far-mat42/mte-481-g29/Nucleo PCB Schematic/MB1136.PcbDoc.htm

Reporting Options

# File in Newer Format

Date | : | 2025-03-16
Time | : | 6:20:26 PM
Filename | : | D:\GitHub\mte-481-g29\Nucleo PCB Schematic\MB1136.PcbDoc

Version | Warning
Release 12 | CAUTION - Air Gap Width previously controlled by Clearance rule is now controlled by Polygon Connect Style rule's newly introduced Air Gap Width (set to default value). Suggest reviewing each Polygon Connect Style rule's Air Gap Width attribute for correctness.
Release 13 | CAUTION - Silkscreen Over Component Pads Rules are converted to Silk To Solder Mask Clearance Rules. Suggest examining rule scopes for accuracy.

This file was generated by an earlier version of the software
