far-mat42/mte-481-g29/Custom PCBs/PCB BOM.xlsx

Quantity | Designator | Part Number
2 | BUF: C1, C2 | C0603C120J5GACTU
1 | BUF: C3 | CC0603KRX7R7BB104
2 | BUF: J1, J2 | 61300411121
1 | BUF: J3 | 61300611121
1 | BUF: J4 | 61300811121
3 | BUF: R3, R4, R5 | RNCP0603FTD10K0
1 | BUF: R6 | RC0603FR-071ML
1 | BUF: U1 | XR20M1172IG28-F
1 | BUF: Y1 | CX2016SA24000D0HLLG3
2 | ADC: C1, C2 | CC0603KRX7R7BB104
4 | ADC: C3A, C3B, C3C, C3D | KGM15AR71C683KT
1 | ADC: J1 | 61300811121
1 | ADC: J2 | 61300611121
2 | ADC: R1, R5 | RNCP0603FTD10K0
2 | ADC: R2, R3 | RC0603FR-071K8L
4 | ADC: R4A, R4B, R4C, R4D | RC0603FR-07100RL
1 | ADC: U1 | ADS1219IPWR
