far-mat42/mte-481-g29/3D Parts and Assemblies/Alternate Barcode Scanner Gimbal.SLDASM

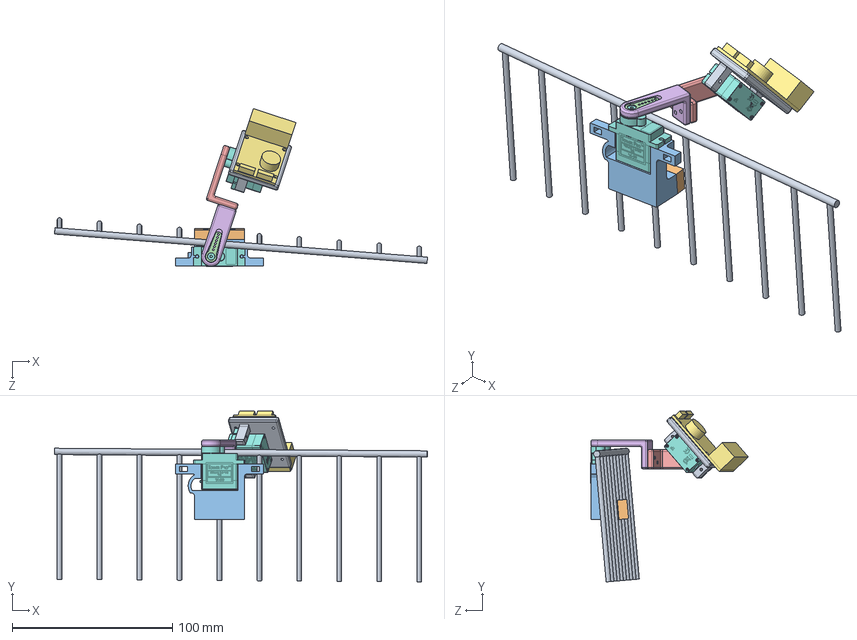
[picture p1: CAD file, 2025-03-16]
3D Parts and Assemblies/Alternate Barcode Scanner Gimbal.SLDASM
232.6 x 106.6 x 98.4 mm
Barcode Scanner Mount Alt
SG90 - Micro Servo 9g - Tower Pro.1 x 2
GM67 Barcode Scanner
Alt Gimbal Yaw Arm
Alt Gimbal Pitch Arm
SG90 Arm x 2
Alt Gimbal Yaw Servo Mount
Yaw Servo Mount Clamp
Gimbal Cart Mockup
