far-mat42/mte-481-g29/3D Parts and Assemblies/ESP32 Case.SLDASM

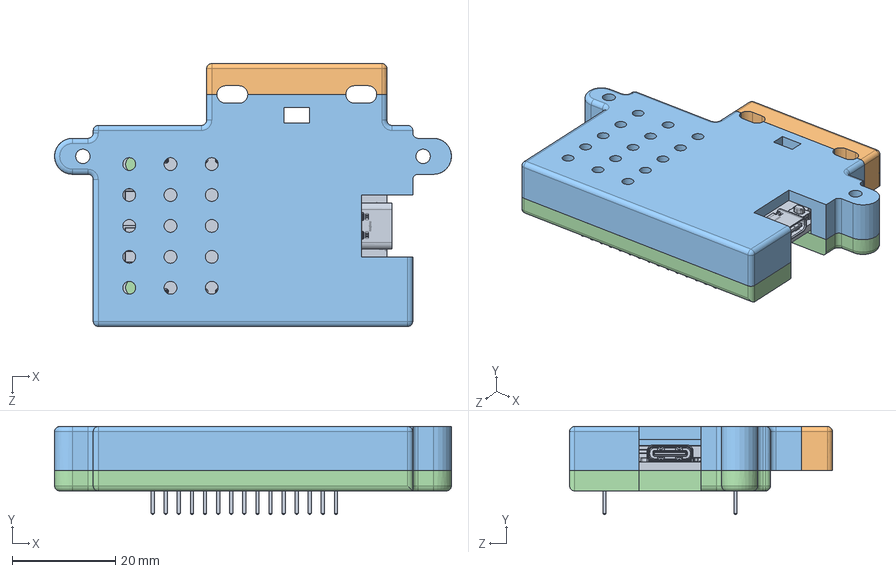
[picture p2: CAD file, 2025-03-10]
3D Parts and Assemblies/ESP32 Case.SLDASM
77.0 x 17.1 x 51.0 mm
ESP32 Case Bottom
ESP32 Case Top
ESP32 Case Mount Clamp
ESP32-WROOM-32
