far-mat42/mte-481-g29/3D Parts and Assemblies/Load Cell ADC Case.SLDASM

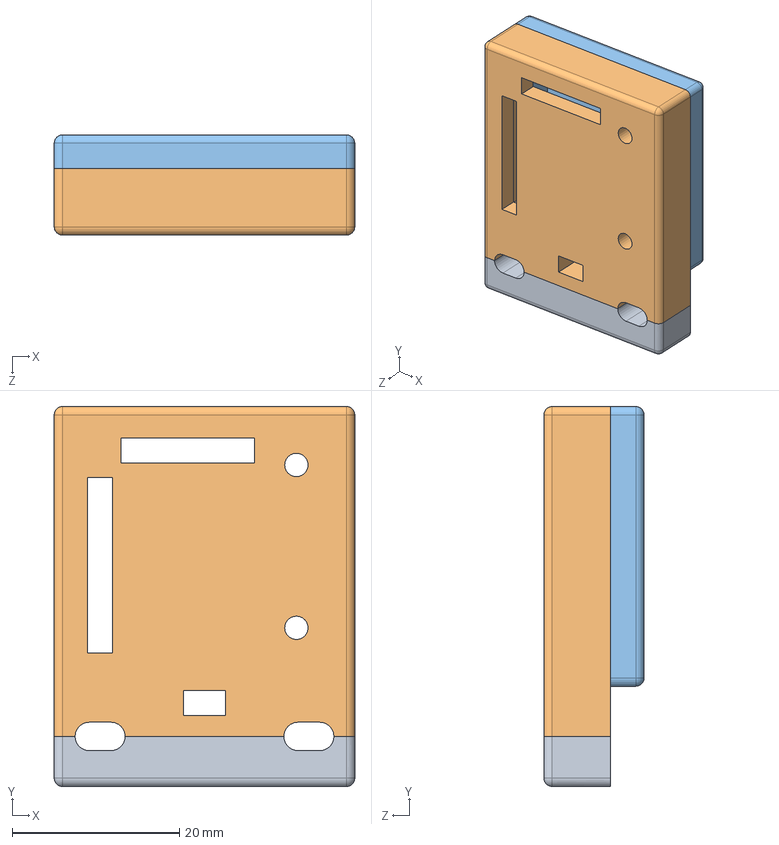
[picture p3: CAD file, 2025-03-02]
3D Parts and Assemblies/Load Cell ADC Case.SLDASM
36.0 x 45.5 x 12.0 mm
Load Cell ADC Case Bottom
Load Cell ADC Case Top
Load Cell ADC Case Mount Clamp
