far-mat42/mte-481-g29/3D Parts and Assemblies/Battery Case.SLDASM

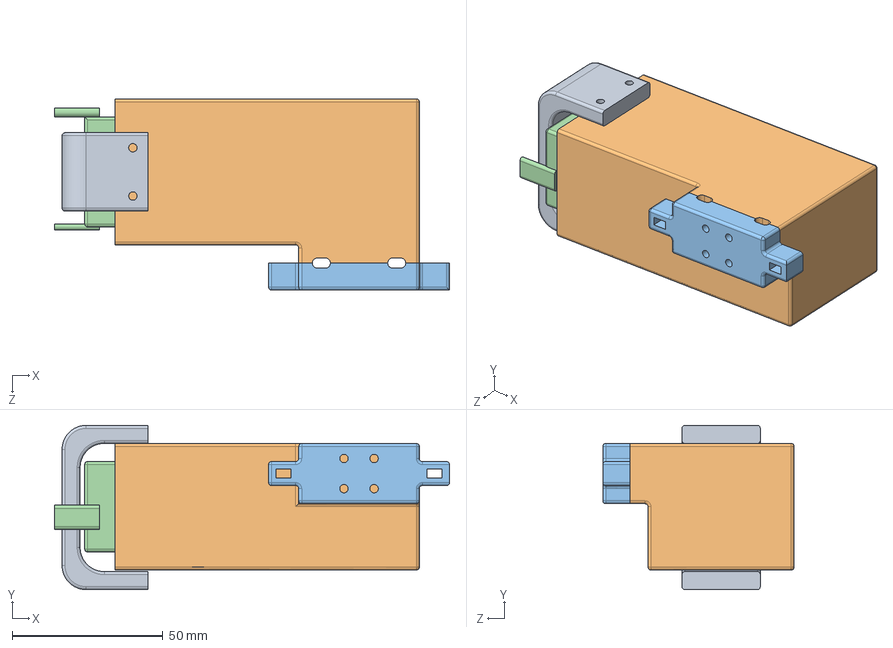
[picture p4: CAD file, 2025-03-02]
3D Parts and Assemblies/Battery Case.SLDASM
131.0 x 54.5 x 63.5 mm
Battery Model
Battery Case Mount
Battery Case
Battery Front Cover
