far-mat42/mte-481-g29/3D Parts and Assemblies/Buck Converter Case.SLDASM

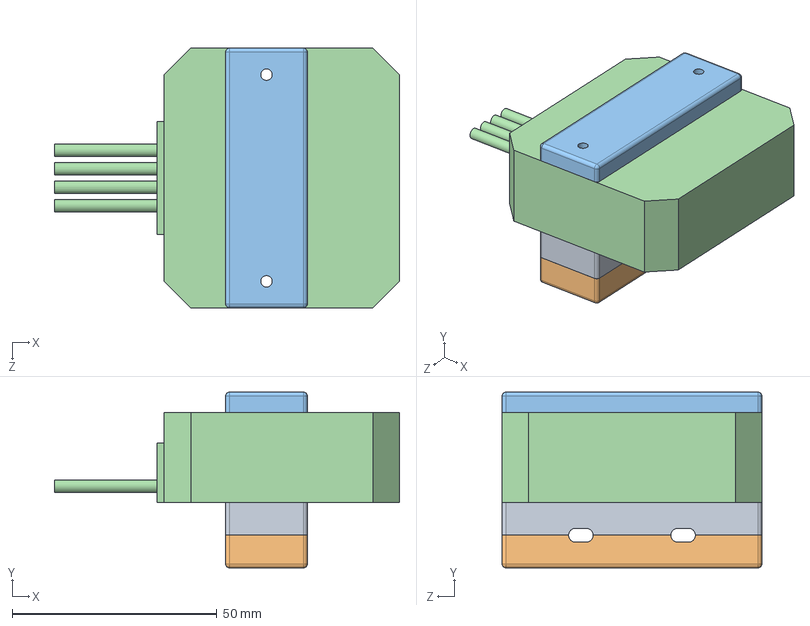
[picture p5: CAD file, 2025-02-27]
3D Parts and Assemblies/Buck Converter Case.SLDASM
84.3 x 43.0 x 63.5 mm
Buck Converter Model
Buck Converter Case Top
Buck Converter Case Mount Clamp
Buck Converter Case Bottom
