far-mat42/mte-481-g29/3D Parts and Assemblies/Barcode Scanner Gimbal.SLDASM

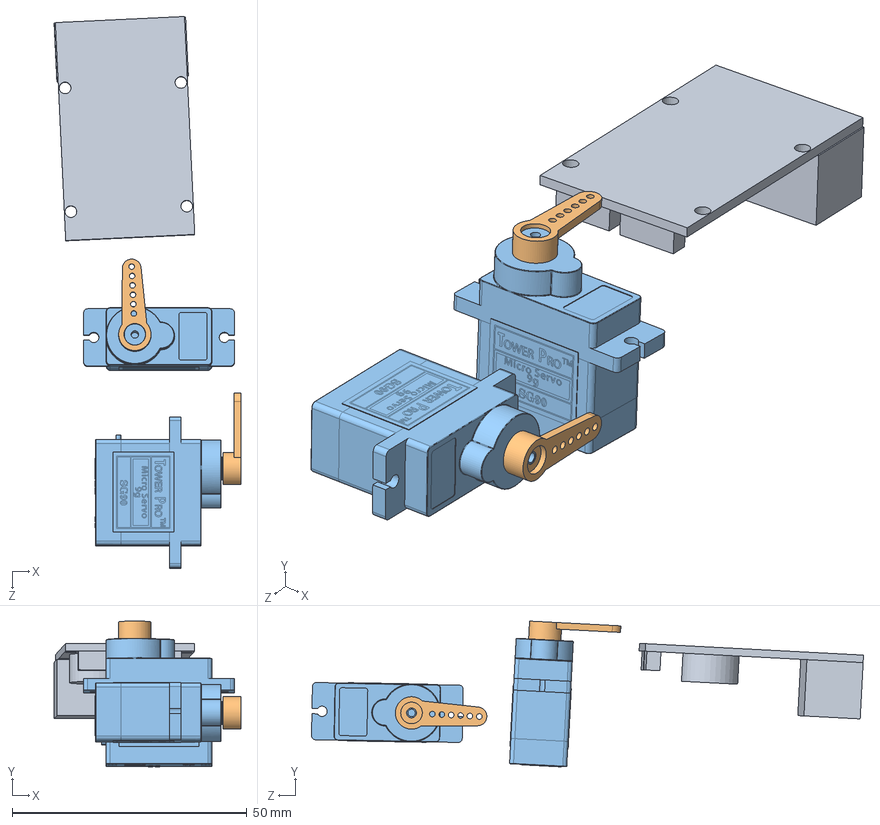
[picture p6: CAD file, 2025-01-12]
3D Parts and Assemblies/Barcode Scanner Gimbal.SLDASM
39.7 x 31.1 x 117.5 mm
SG90 - Micro Servo 9g - Tower Pro.1 x 2
SG90 Arm x 2
GM67 Barcode Scanner
