far-mat42/mte-481-g29/3D Parts and Assemblies/Models & Used Designs/Gimbal Cart Mockup.SLDPRT

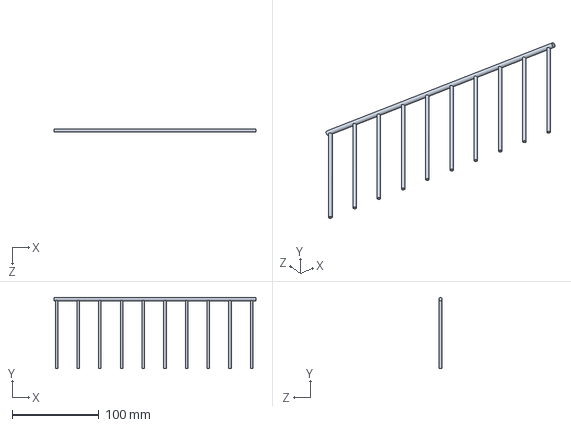
[picture p7: CAD file, 2025-03-16]
3D Parts and Assemblies/Models & Used Designs/Gimbal Cart Mockup.SLDPRT
233.0 x 82.0 x 4.00 mm
