far-mat42/mte-481-g29/3D Parts and Assemblies/Custom Parts/ESP32 Case Bottom.SLDPRT

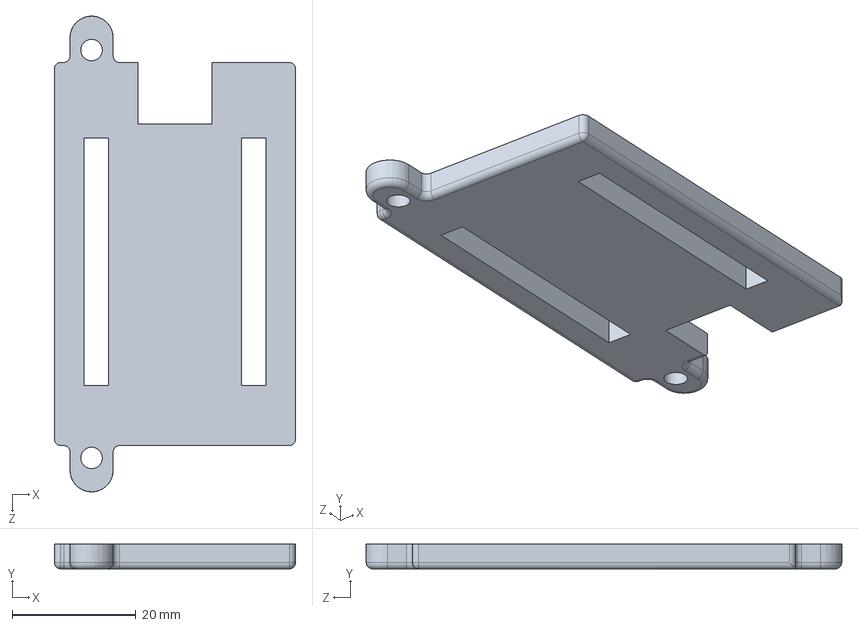
[picture p8: CAD file, 2025-03-10]
3D Parts and Assemblies/Custom Parts/ESP32 Case Bottom.SLDPRT
39.0 x 4.00 x 77.0 mm
