far-mat42/mte-481-g29/3D Parts and Assemblies/Models & Used Designs/ESP32-WROOM-32.SLDPRT

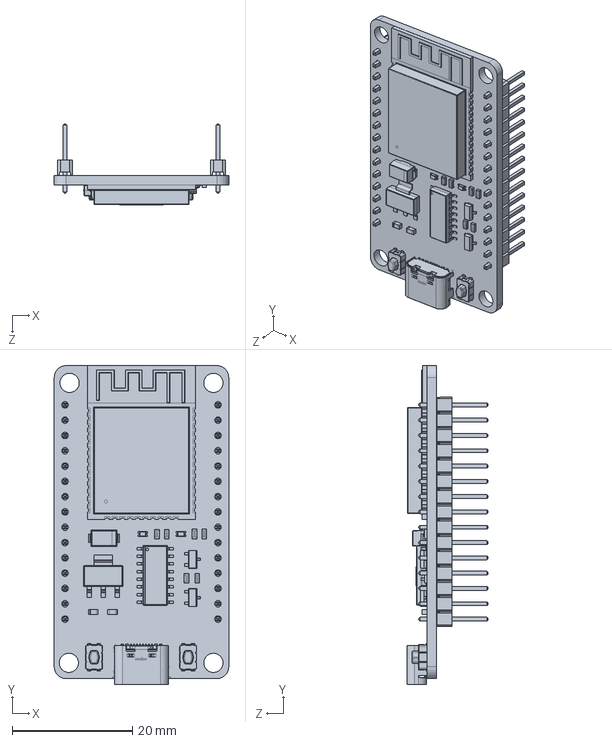
[picture p9: CAD file, 2025-03-03]
3D Parts and Assemblies/Models & Used Designs/ESP32-WROOM-32.SLDPRT
29.0 x 53.0 x 13.5 mm
