far-mat42/mte-481-g29/3D Parts and Assemblies/Custom Parts/ESP32 Case Top.SLDPRT

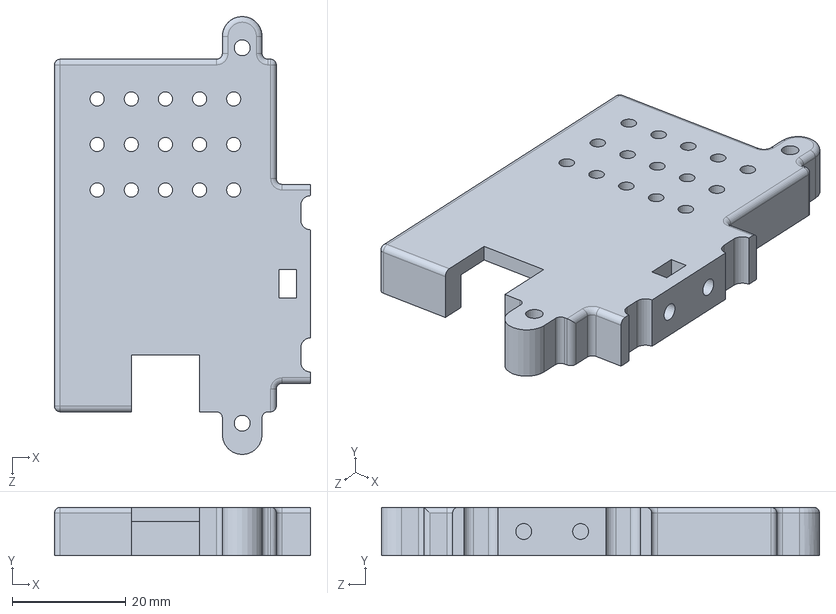
[picture p10: CAD file, 2025-03-10]
3D Parts and Assemblies/Custom Parts/ESP32 Case Top.SLDPRT
45.0 x 8.50 x 77.0 mm
