far-mat42/mte-481-g29/3D Parts and Assemblies/Models & Used Designs/Battery Model.SLDPRT

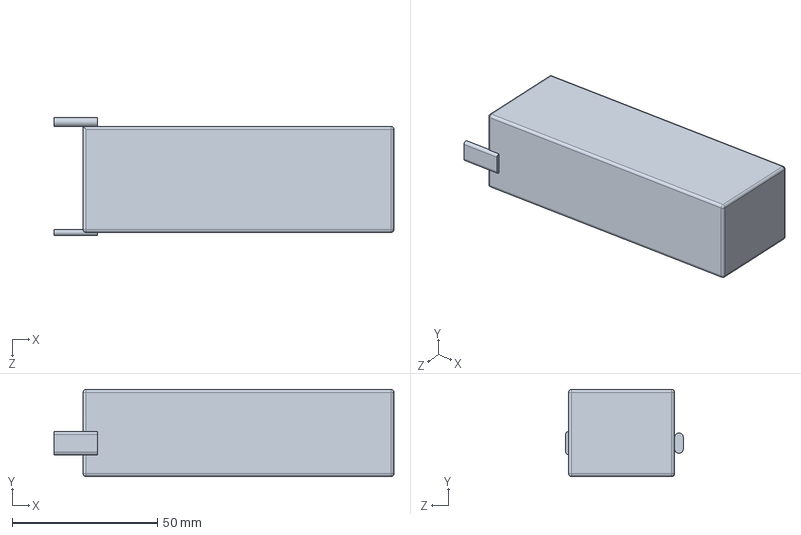
[picture p11: CAD file, 2025-02-27]
3D Parts and Assemblies/Models & Used Designs/Battery Model.SLDPRT
117.0 x 30.0 x 40.5 mm
