far-mat42/mte-481-g29/3D Parts and Assemblies/Custom Parts/Jetson Nano Case Bottom.SLDPRT

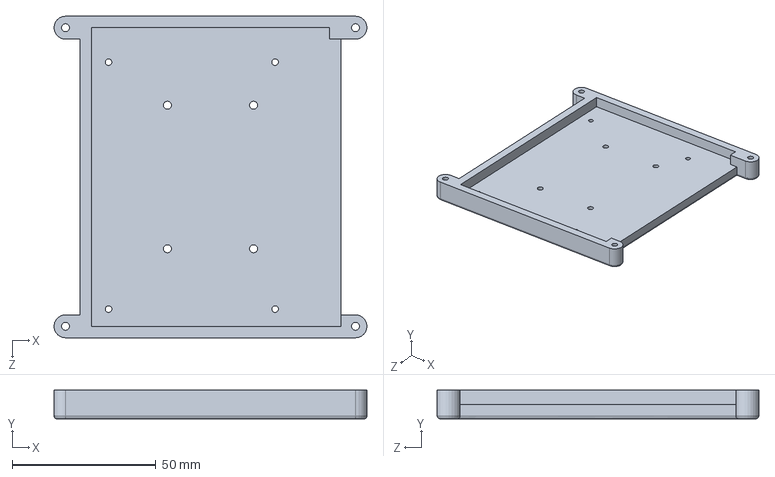
[picture p12: CAD file, 2025-03-06]
3D Parts and Assemblies/Custom Parts/Jetson Nano Case Bottom.SLDPRT
109.0 x 10.0 x 112.0 mm
