far-mat42/mte-481-g29/3D Parts and Assemblies/Models & Used Designs/Buck Converter Model.SLDPRT

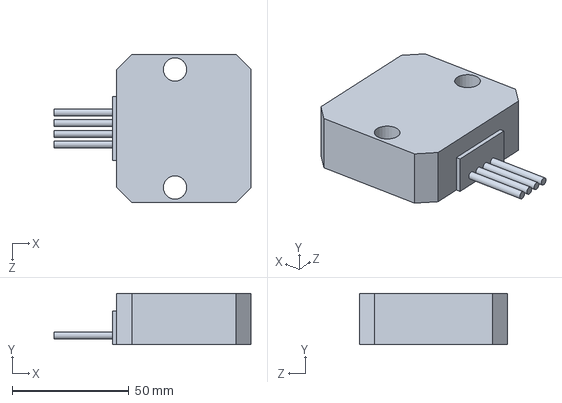
[picture p13: CAD file, 2025-02-27]
3D Parts and Assemblies/Models & Used Designs/Buck Converter Model.SLDPRT
84.3 x 22.0 x 63.5 mm
