far-mat42/mte-481-g29/3D Parts and Assemblies/Models & Used Designs/Basket Wall.SLDPRT

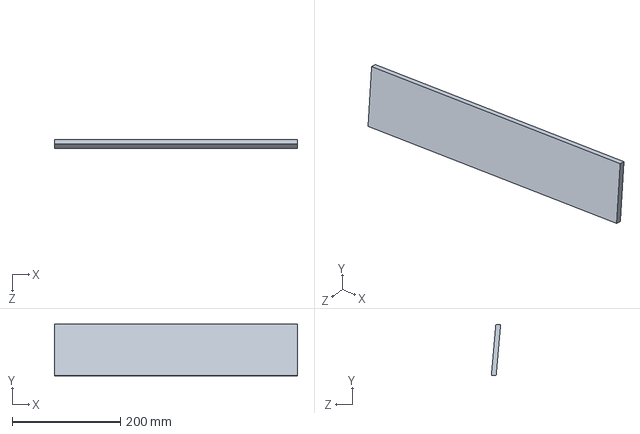
[picture p14: CAD file, 2025-02-02]
3D Parts and Assemblies/Models & Used Designs/Basket Wall.SLDPRT
450.0 x 95.4 x 17.2 mm
