far-mat42/mte-481-g29/3D Parts and Assemblies/Models & Used Designs/MotorSlot-Left.SLDPRT

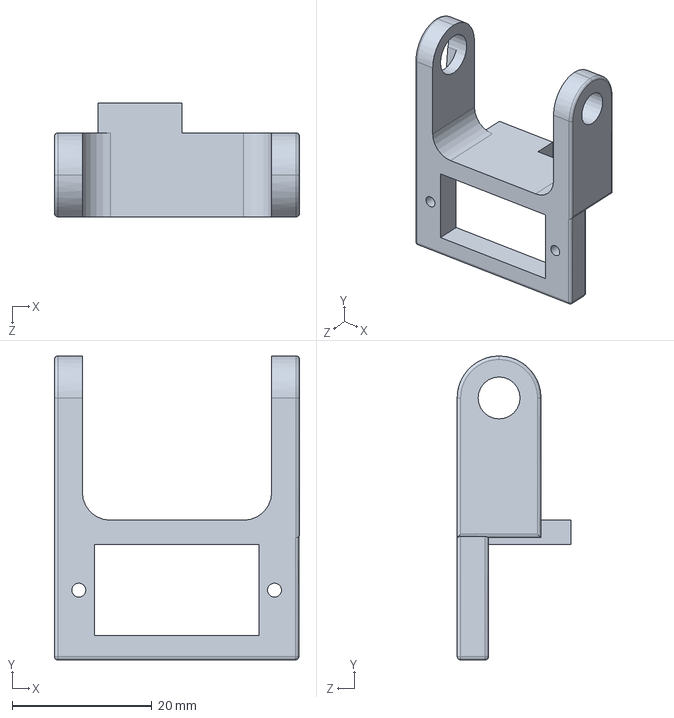
[picture p15: CAD file, 2025-01-12]
3D Parts and Assemblies/Models & Used Designs/MotorSlot-Left.SLDPRT
35.1 x 43.5 x 16.3 mm
