far-mat42/mte-481-g29/3D Parts and Assemblies/Custom Parts/Nucleo Case Top.SLDPRT

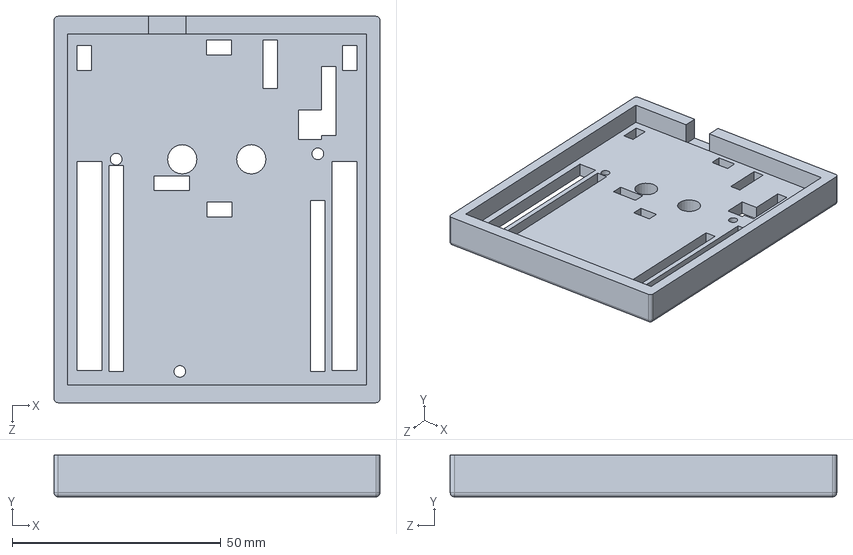
[picture p16: CAD file, 2025-03-03]
3D Parts and Assemblies/Custom Parts/Nucleo Case Top.SLDPRT
78.0 x 10.0 x 92.5 mm
