far-mat42/mte-481-g29/3D Parts and Assemblies/Models & Used Designs/SG90 Arm.SLDPRT

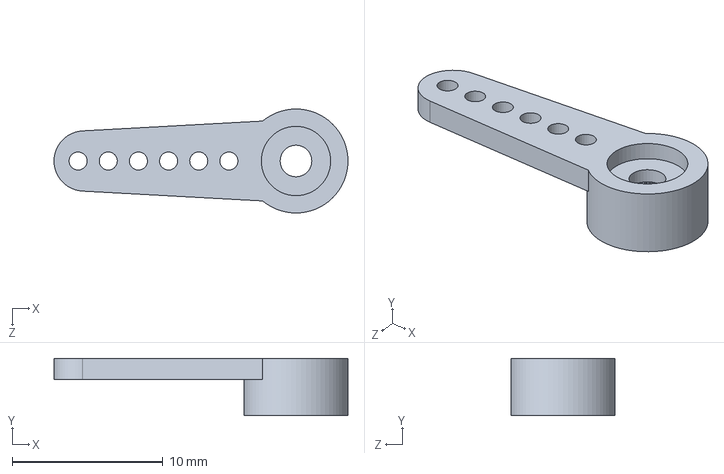
[picture p17: CAD file, 2025-01-12]
3D Parts and Assemblies/Models & Used Designs/SG90 Arm.SLDPRT
19.5 x 3.80 x 6.90 mm
