far-mat42/mte-481-g29/3D Parts and Assemblies/Custom Parts/Nucleo Case Outer Clamp.SLDPRT

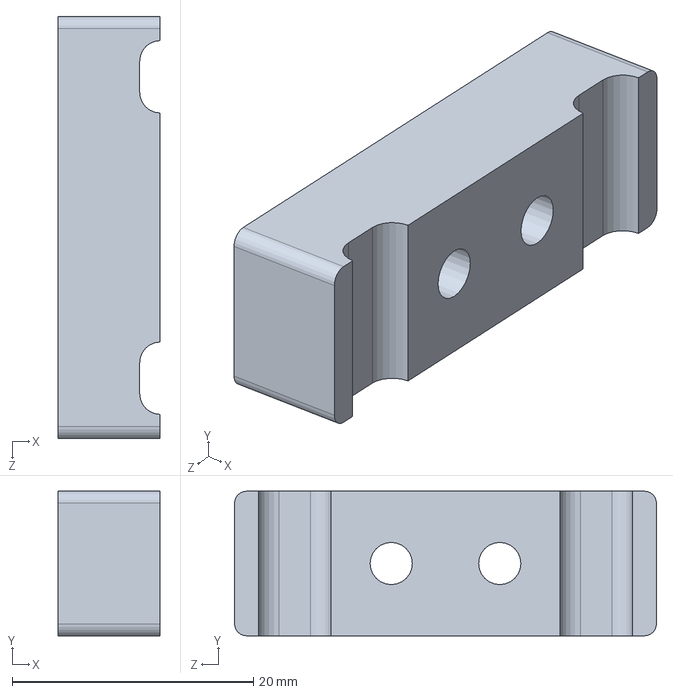
[picture p18: CAD file, 2025-03-03]
3D Parts and Assemblies/Custom Parts/Nucleo Case Outer Clamp.SLDPRT
8.50 x 12.0 x 35.0 mm
