far-mat42/mte-481-g29/3D Parts and Assemblies/Models & Used Designs/MotorHolder.SLDPRT

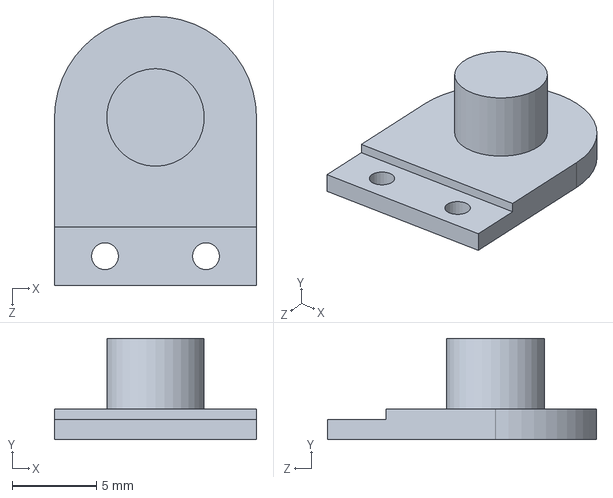
[picture p19: CAD file, 2025-01-12]
3D Parts and Assemblies/Models & Used Designs/MotorHolder.SLDPRT
12.0 x 6.00 x 16.0 mm
