far-mat42/mte-481-g29/3D Parts and Assemblies/Custom Parts/Nucleo Case Inner Clamp.SLDPRT

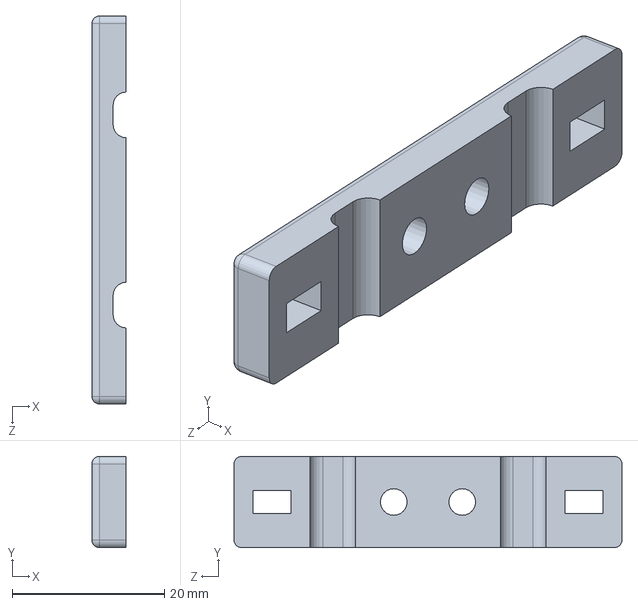
[picture p20: CAD file, 2025-03-03]
3D Parts and Assemblies/Custom Parts/Nucleo Case Inner Clamp.SLDPRT
4.50 x 12.0 x 51.0 mm
