far-mat42/mte-481-g29/3D Parts and Assemblies/Custom Parts/Jetson Nano Case Top.SLDPRT

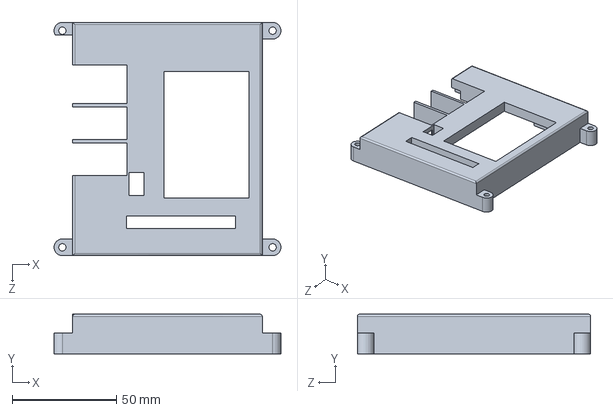
[picture p21: CAD file, 2025-03-03]
3D Parts and Assemblies/Custom Parts/Jetson Nano Case Top.SLDPRT
109.0 x 19.0 x 112.0 mm
