far-mat42/mte-481-g29/3D Parts and Assemblies/Models & Used Designs/SG90 - Micro Servo 9g - Tower Pro.1.SLDPRT

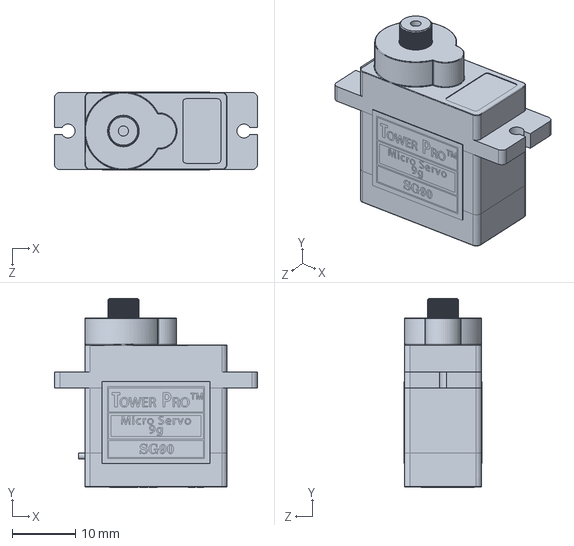
[picture p22: CAD file, 2025-01-12]
3D Parts and Assemblies/Models & Used Designs/SG90 - Micro Servo 9g - Tower Pro.1.SLDPRT
32.1 x 30.0 x 12.4 mm
