far-mat42/mte-481-g29/3D Parts and Assemblies/Custom Parts/ESP32 Case Mount Clamp.SLDPRT

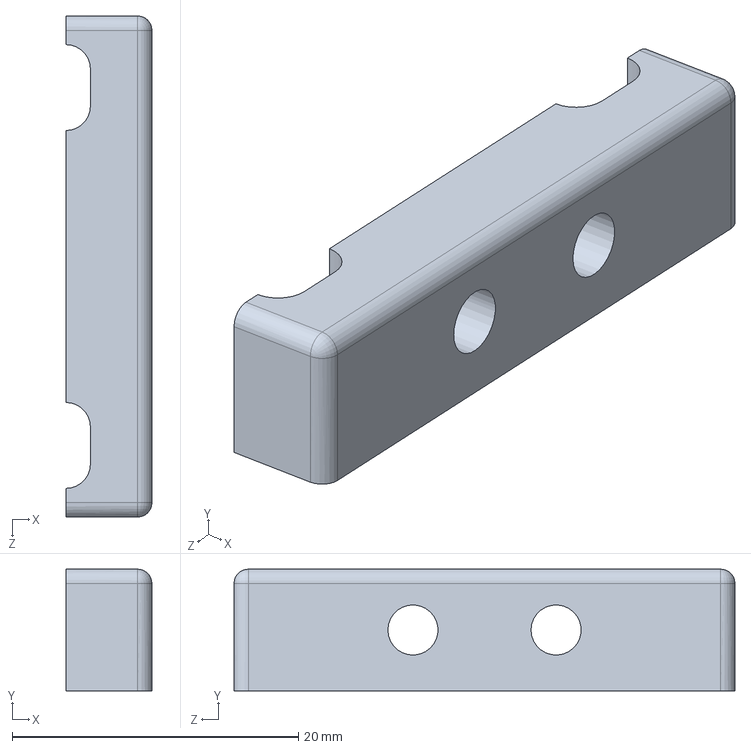
[picture p23: CAD file, 2025-03-03]
3D Parts and Assemblies/Custom Parts/ESP32 Case Mount Clamp.SLDPRT
6.00 x 8.50 x 35.0 mm
