far-mat42/mte-481-g29/3D Parts and Assemblies/Custom Parts/Jetson Case Inner Clamp.SLDPRT

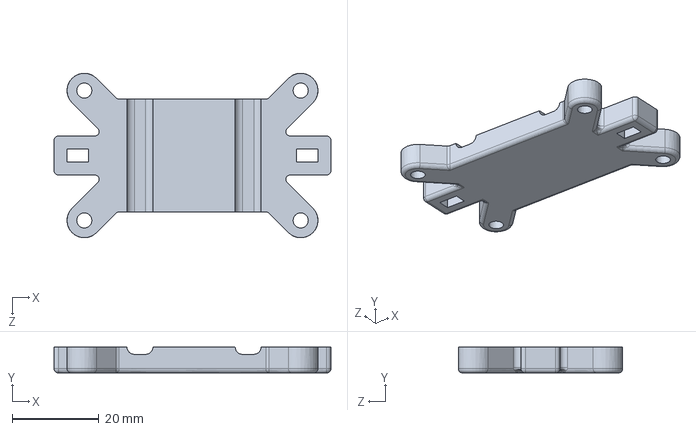
[picture p24: CAD file, 2025-03-02]
3D Parts and Assemblies/Custom Parts/Jetson Case Inner Clamp.SLDPRT
64.0 x 6.00 x 38.0 mm
