far-mat42/mte-481-g29/3D Parts and Assemblies/Custom Parts/Jetson Case Outer Clamp.SLDPRT

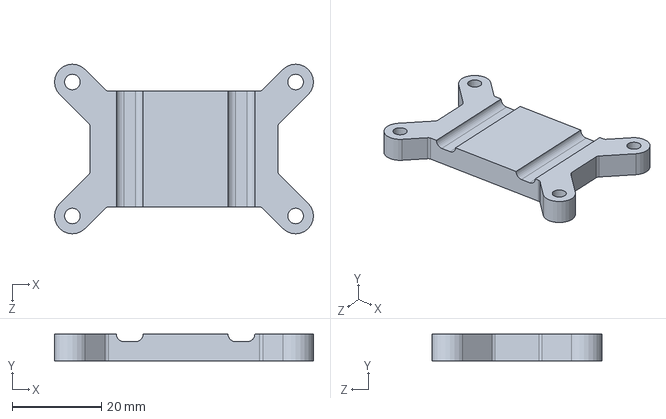
[picture p25: CAD file, 2025-03-02]
3D Parts and Assemblies/Custom Parts/Jetson Case Outer Clamp.SLDPRT
58.0 x 6.00 x 38.0 mm
