far-mat42/mte-481-g29/3D Parts and Assemblies/Custom Parts/Battery Front Cover.SLDPRT

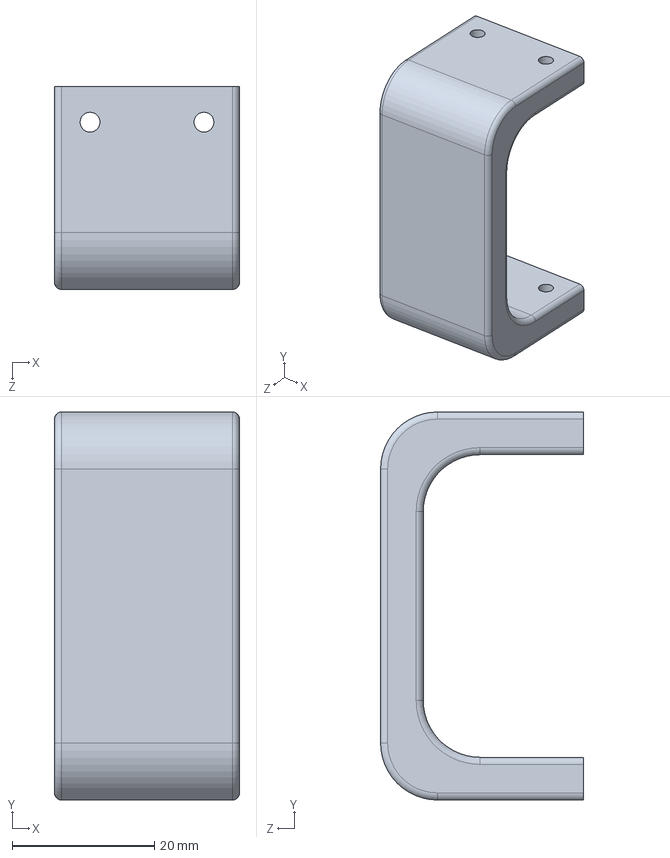
[picture p26: CAD file, 2025-02-27]
3D Parts and Assemblies/Custom Parts/Battery Front Cover.SLDPRT
26.0 x 54.5 x 28.5 mm
