far-mat42/mte-481-g29/3D Parts and Assemblies/Custom Parts/Battery Case.SLDPRT

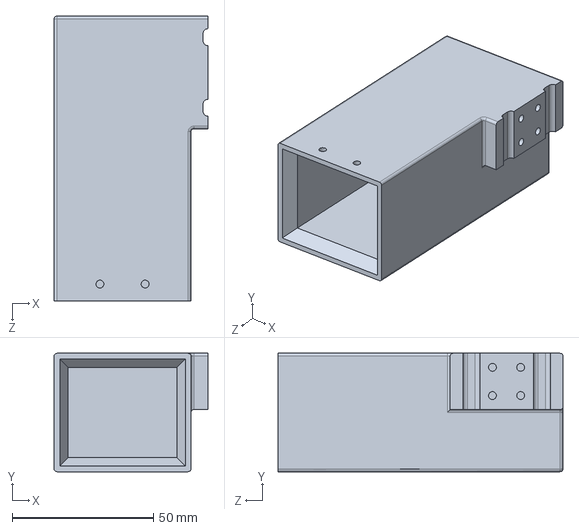
[picture p27: CAD file, 2025-02-27]
3D Parts and Assemblies/Custom Parts/Battery Case.SLDPRT
54.5 x 42.0 x 101.0 mm
