far-mat42/mte-481-g29/3D Parts and Assemblies/Custom Parts/Battery Case Mount.SLDPRT

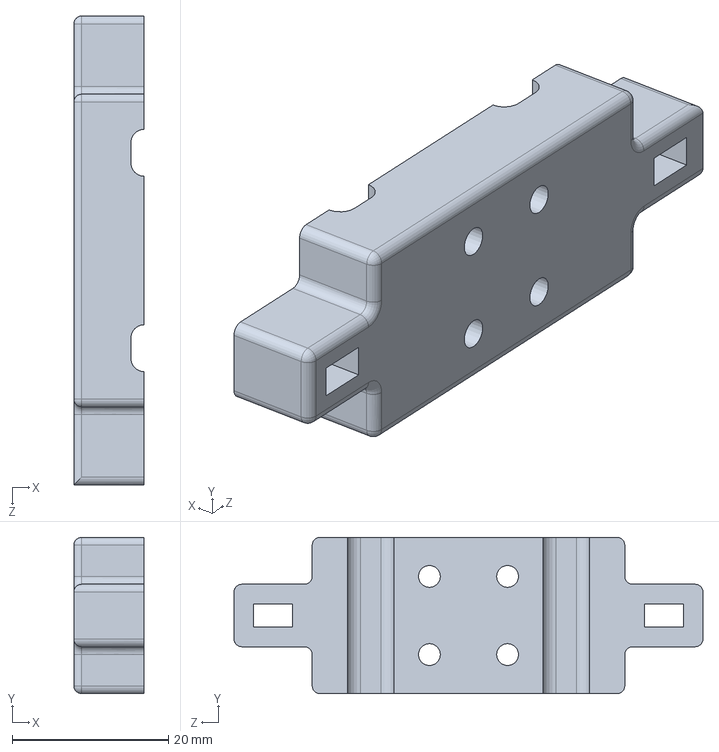
[picture p28: CAD file, 2025-02-27]
3D Parts and Assemblies/Custom Parts/Battery Case Mount.SLDPRT
9.00 x 20.0 x 60.0 mm
