far-mat42/mte-481-g29/3D Parts and Assemblies/Custom Parts/Buck Converter Case Top.SLDPRT

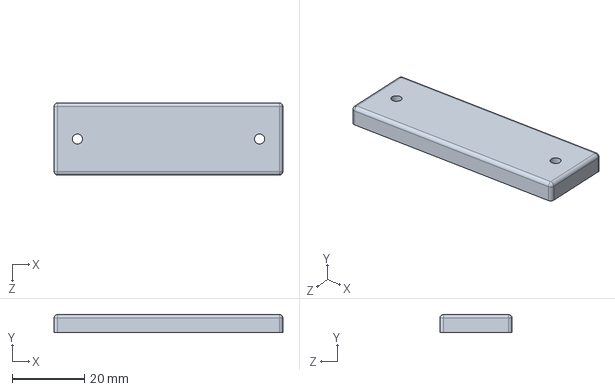
[picture p29: CAD file, 2025-02-27]
3D Parts and Assemblies/Custom Parts/Buck Converter Case Top.SLDPRT
63.5 x 5.00 x 20.0 mm
