far-mat42/mte-481-g29/3D Parts and Assemblies/Custom Parts/Buck Converter Case Bottom.SLDPRT

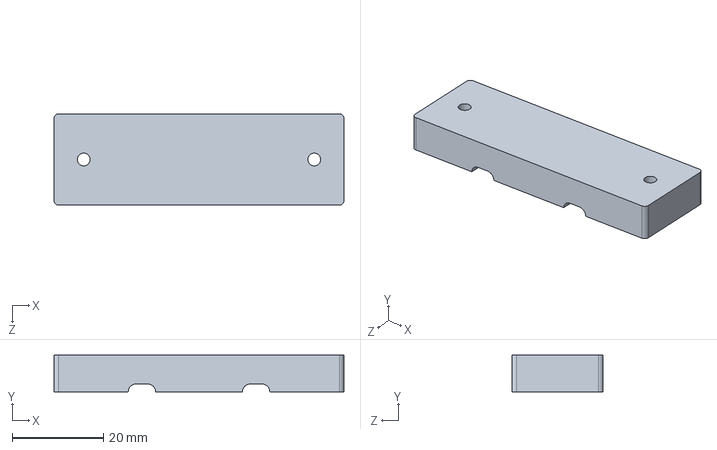
[picture p30: CAD file, 2025-02-27]
3D Parts and Assemblies/Custom Parts/Buck Converter Case Bottom.SLDPRT
63.5 x 8.00 x 20.0 mm
