far-mat42/mte-481-g29/3D Parts and Assemblies/Custom Parts/Nucleo Case Bottom.SLDPRT

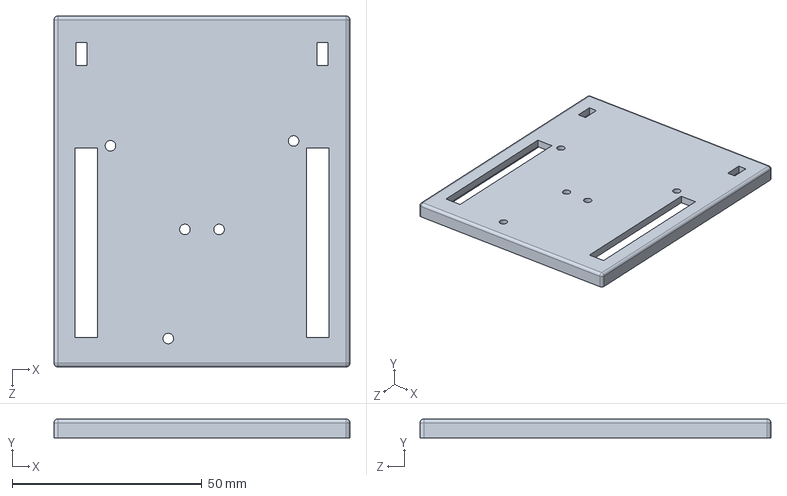
[picture p32: CAD file, 2025-02-25]
3D Parts and Assemblies/Custom Parts/Nucleo Case Bottom.SLDPRT
78.0 x 5.00 x 92.5 mm
