far-mat42/mte-481-g29/3D Parts and Assemblies/Custom Parts/LDO Case Top.SLDPRT

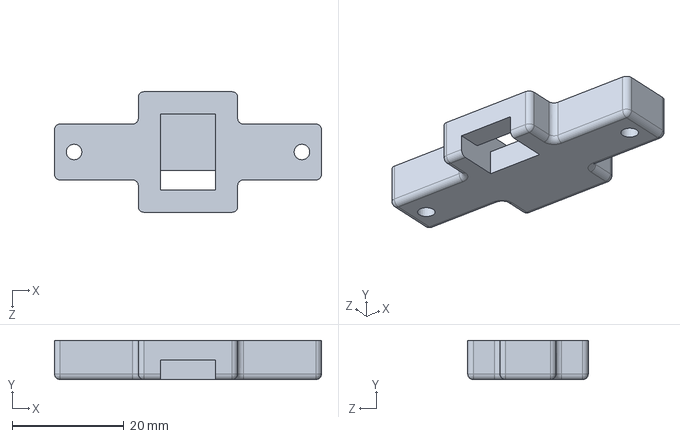
[picture p33: CAD file, 2025-02-25]
3D Parts and Assemblies/Custom Parts/LDO Case Top.SLDPRT
47.8 x 7.00 x 21.6 mm
