far-mat42/mte-481-g29/3D Parts and Assemblies/Custom Parts/Alt Gimbal Yaw Servo Mount.SLDPRT

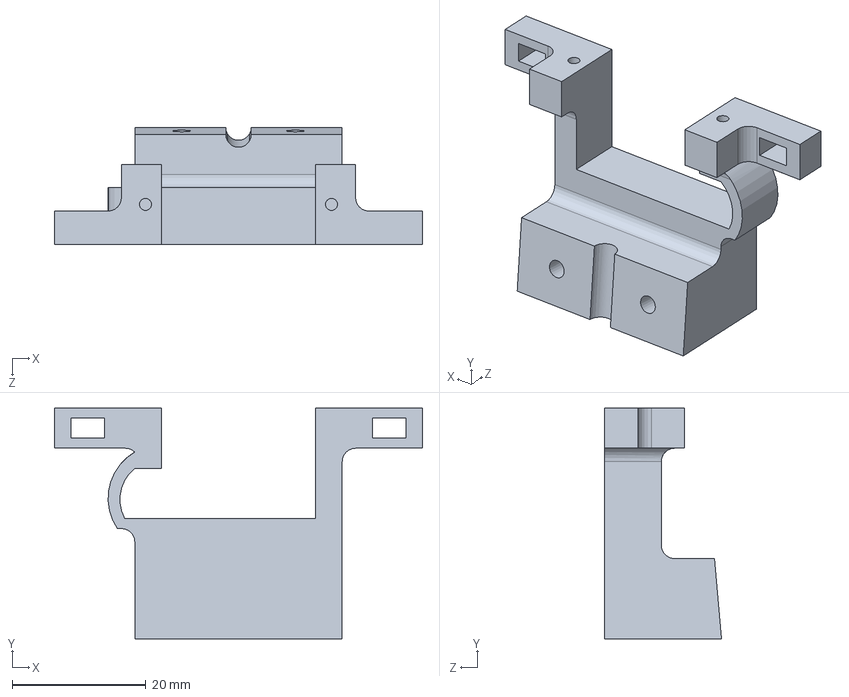
[picture p34: CAD file, 2025-02-25]
3D Parts and Assemblies/Custom Parts/Alt Gimbal Yaw Servo Mount.SLDPRT
55.0 x 34.5 x 17.5 mm
