far-mat42/mte-481-g29/3D Parts and Assemblies/Custom Parts/LDO Case Mount Clamp.SLDPRT

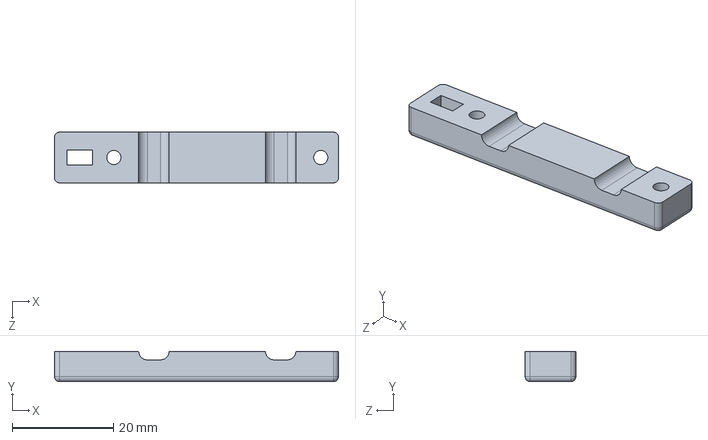
[picture p35: CAD file, 2025-02-25]
3D Parts and Assemblies/Custom Parts/LDO Case Mount Clamp.SLDPRT
56.0 x 6.00 x 10.0 mm
