far-mat42/mte-481-g29/3D Parts and Assemblies/Custom Parts/Yaw Servo Mount Clamp.SLDPRT

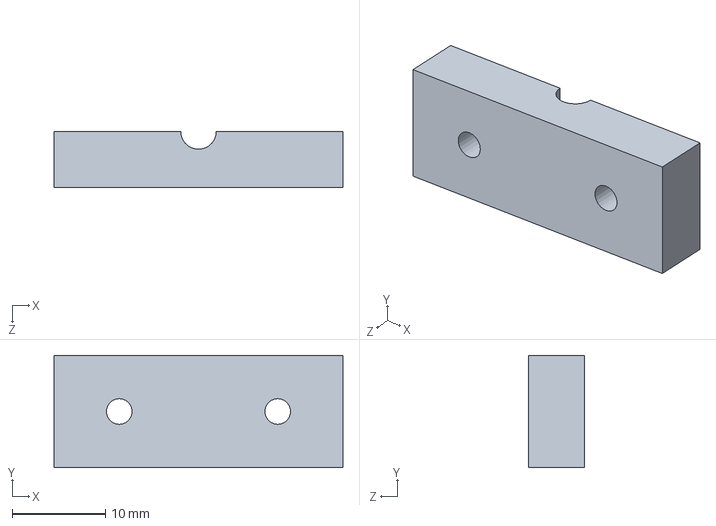
[picture p36: CAD file, 2025-02-25]
3D Parts and Assemblies/Custom Parts/Yaw Servo Mount Clamp.SLDPRT
31.0 x 12.1 x 6.00 mm
