far-mat42/mte-481-g29/3D Parts and Assemblies/Custom Parts/Load Cell ADC Case Bottom.SLDPRT

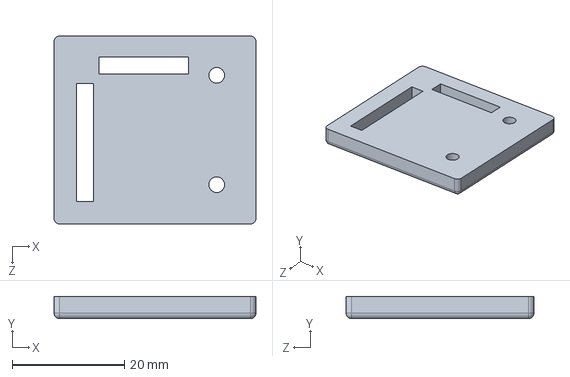
[picture p37: CAD file, 2025-02-23]
3D Parts and Assemblies/Custom Parts/Load Cell ADC Case Bottom.SLDPRT
36.0 x 4.00 x 33.5 mm
