far-mat42/mte-481-g29/3D Parts and Assemblies/Custom Parts/Load Cell ADC Case Top.SLDPRT

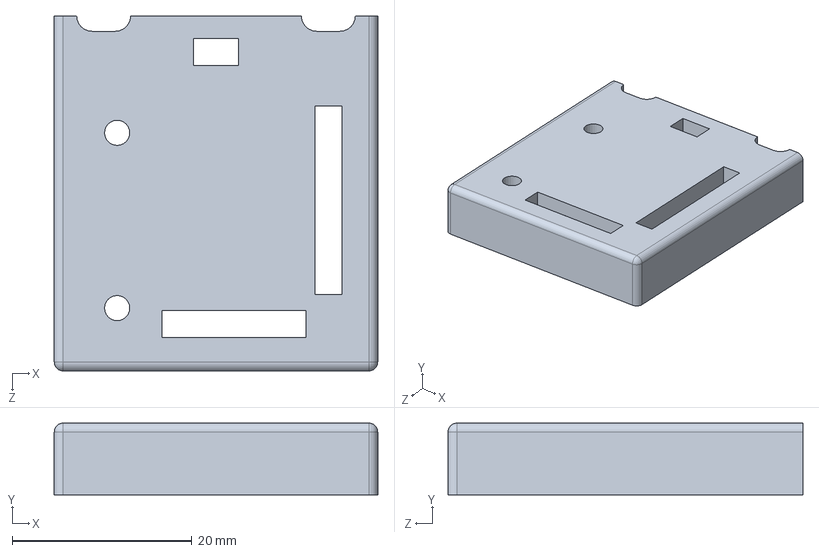
[picture p38: CAD file, 2025-02-23]
3D Parts and Assemblies/Custom Parts/Load Cell ADC Case Top.SLDPRT
36.0 x 8.00 x 39.5 mm
