far-mat42/mte-481-g29/3D Parts and Assemblies/Custom Parts/Load Cell ADC Case Mount Clamp.SLDPRT

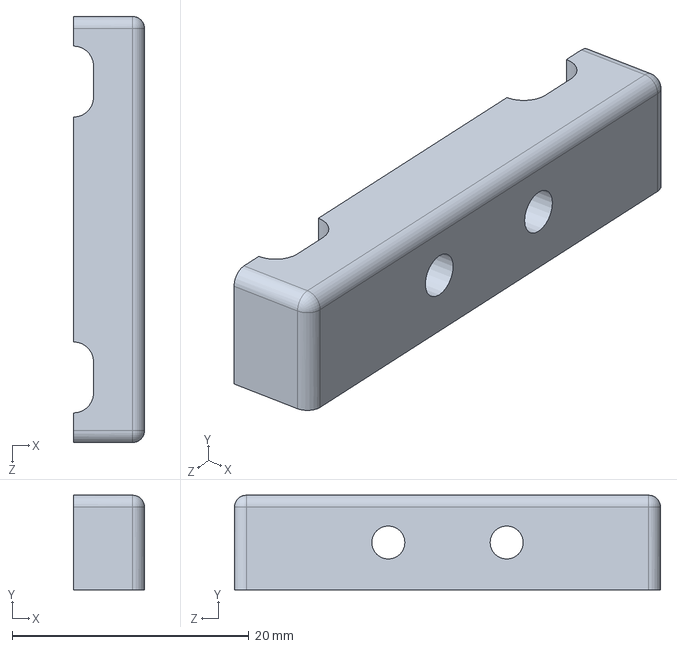
[picture p39: CAD file, 2025-02-23]
3D Parts and Assemblies/Custom Parts/Load Cell ADC Case Mount Clamp.SLDPRT
6.00 x 8.00 x 36.0 mm
