far-mat42/mte-481-g29/3D Parts and Assemblies/Custom Parts/Barcode Scanner Mount Alt.SLDPRT

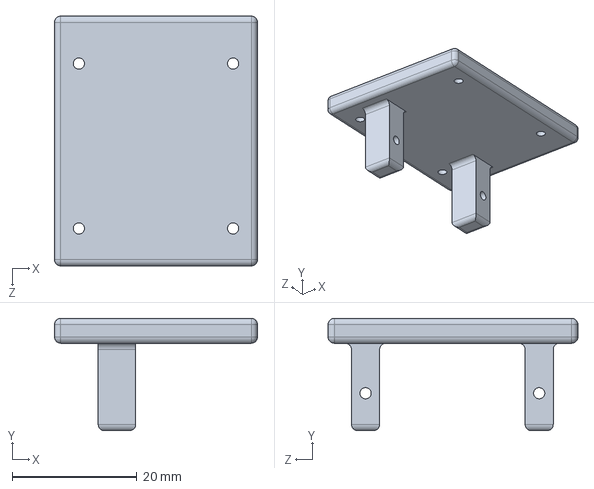
[picture p40: CAD file, 2025-02-02]
3D Parts and Assemblies/Custom Parts/Barcode Scanner Mount Alt.SLDPRT
32.5 x 18.0 x 40.0 mm
