far-mat42/mte-481-g29/3D Parts and Assemblies/Custom Parts/Alt Gimbal Yaw Arm.SLDPRT

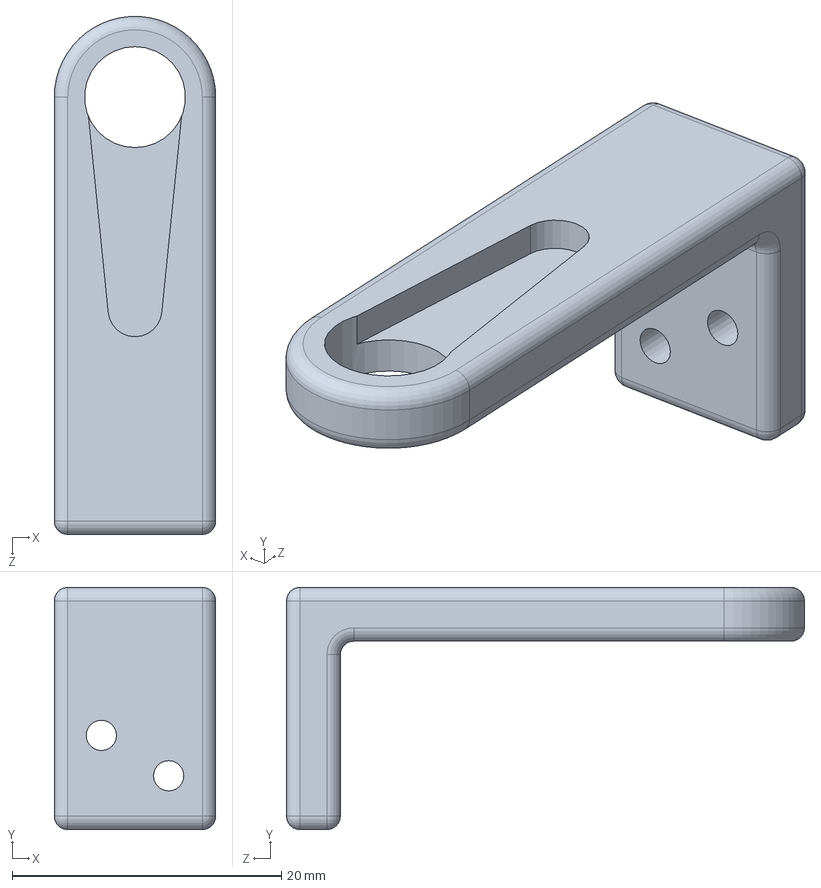
[picture p41: CAD file, 2025-02-02]
3D Parts and Assemblies/Custom Parts/Alt Gimbal Yaw Arm.SLDPRT
12.0 x 18.0 x 38.5 mm
