far-mat42/mte-481-g29/3D Parts and Assemblies/Custom Parts/Alt Gimbal Intermediate.SLDPRT

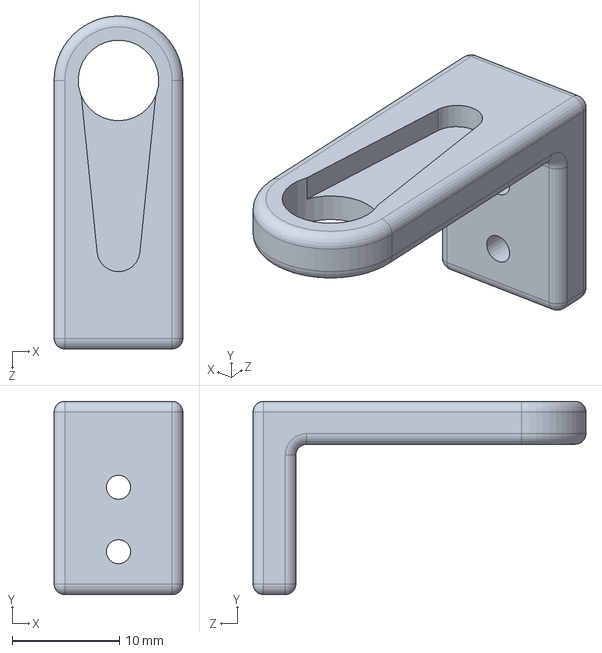
[picture p42: CAD file, 2025-02-02]
3D Parts and Assemblies/Custom Parts/Alt Gimbal Intermediate.SLDPRT
12.0 x 18.0 x 31.0 mm
