far-mat42/mte-481-g29/3D Parts and Assemblies/Custom Parts/Alt Gimbal Pitch Arm.SLDPRT

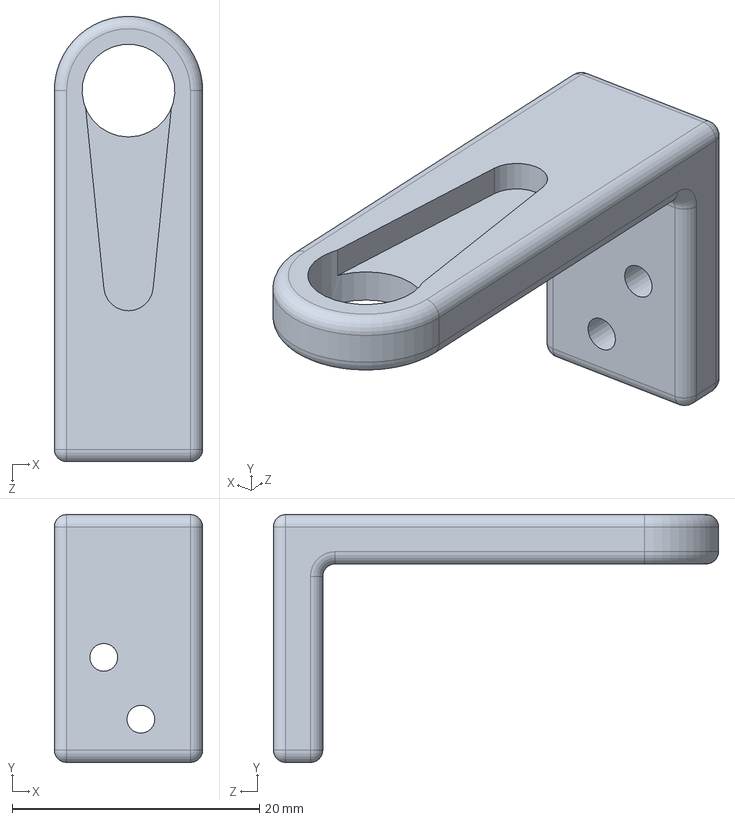
[picture p43: CAD file, 2025-02-02]
3D Parts and Assemblies/Custom Parts/Alt Gimbal Pitch Arm.SLDPRT
12.0 x 20.0 x 36.0 mm
