far-mat42/mte-481-g29/3D Parts and Assemblies/Custom Parts/GM67 Barcode Scanner.SLDPRT

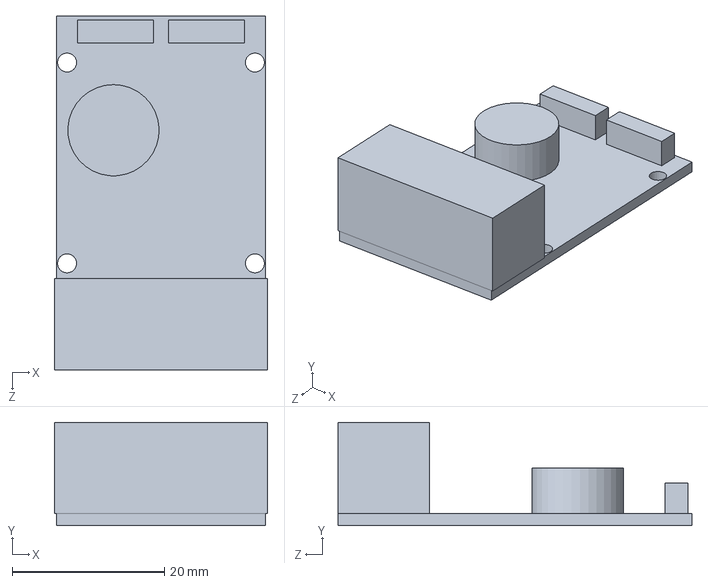
[picture p44: CAD file, 2025-01-12]
3D Parts and Assemblies/Custom Parts/GM67 Barcode Scanner.SLDPRT
28.0 x 13.6 x 46.5 mm
