far-mat42/mte-481-g29/3D Parts and Assemblies/Custom Parts/Barcode Scanner Mount.SLDPRT

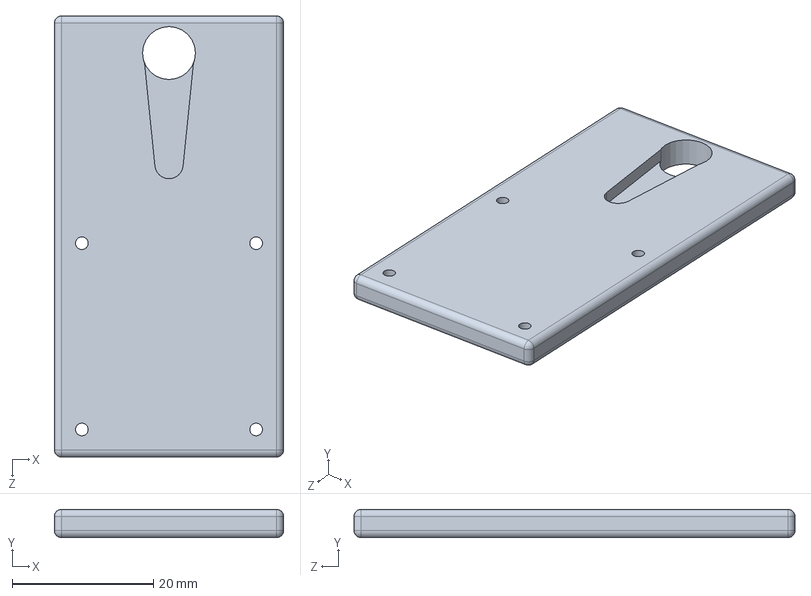
[picture p45: CAD file, 2025-01-12]
3D Parts and Assemblies/Custom Parts/Barcode Scanner Mount.SLDPRT
32.5 x 4.00 x 62.5 mm
