far-mat42/mte-481-g29/(list of files, cad)

Other CAD files:
3D Parts and Assemblies/Models & Used Designs/Gimbal-Intermediate.SLDPRT
3D Parts and Assemblies/Custom Parts/LDO Case Bottom.SLDPRT
3D Parts and Assemblies/Custom Parts/Motor Slot Intermediate.SLDPRT
3D Parts and Assemblies/Custom Parts/Alt Gimbal Pitch Arm.STL
3D Parts and Assemblies/Custom Parts/Alt Gimbal Yaw Arm.STL
3D Parts and Assemblies/Custom Parts/Alt Gimbal Yaw Servo Mount.STL
3D Parts and Assemblies/Custom Parts/Barcode Scanner Mount Alt.STL
3D Parts and Assemblies/Custom Parts/Barcode Scanner Mount.STL
3D Parts and Assemblies/Custom Parts/Battery Case Mount.STL
3D Parts and Assemblies/Custom Parts/Battery Case.STL
3D Parts and Assemblies/Custom Parts/Battery Front Cover.STL
3D Parts and Assemblies/Custom Parts/Buck Converter Case Bottom.STL
3D Parts and Assemblies/Custom Parts/Buck Converter Case Mount Clamp.STL
3D Parts and Assemblies/Custom Parts/Buck Converter Case Top.STL
3D Parts and Assemblies/Custom Parts/Camera Screw Mount Inside Alt.SLDPRT
3D Parts and Assemblies/Custom Parts/Camera Screw Mount Inside Alt.STL
3D Parts and Assemblies/Custom Parts/Camera Screw Mount Inside.SLDPRT
3D Parts and Assemblies/Custom Parts/Camera Screw Mount Inside.STL
3D Parts and Assemblies/Custom Parts/Camera Screw Mount Outside Alt.SLDPRT
3D Parts and Assemblies/Custom Parts/Camera Screw Mount Outside Alt.STL
3D Parts and Assemblies/Custom Parts/Camera Screw Mount Outside.SLDPRT
3D Parts and Assemblies/Custom Parts/Camera Screw Mount Outside.STL
3D Parts and Assemblies/Custom Parts/Camera Screw Mount.SLDPRT
3D Parts and Assemblies/Custom Parts/Drawings/3V3 LDO Case.SLDDRW
3D Parts and Assemblies/Custom Parts/Drawings/Battery Mount.SLDDRW
3D Parts and Assemblies/Custom Parts/Drawings/ESP32 Case.SLDDRW
3D Parts and Assemblies/Custom Parts/Drawings/Gimbal Arms.SLDDRW
3D Parts and Assemblies/Custom Parts/Drawings/Gimbal Mount.SLDDRW
3D Parts and Assemblies/Custom Parts/Drawings/Jetson Case.SLDDRW
3D Parts and Assemblies/Custom Parts/Drawings/Load Cell ADC Case.SLDDRW
3D Parts and Assemblies/Custom Parts/Drawings/Nucleo Case.SLDDRW
3D Parts and Assemblies/Custom Parts/Drawings/Template.SLDDRW
3D Parts and Assemblies/Custom Parts/ESP32 Case Bottom.STL
3D Parts and Assemblies/Custom Parts/ESP32 Case Mount Clamp.STL
3D Parts and Assemblies/Custom Parts/ESP32 Case Top.STL
3D Parts and Assemblies/Custom Parts/Jetson Case Inner Clamp.STL
3D Parts and Assemblies/Custom Parts/Jetson Case Outer Clamp.STL
3D Parts and Assemblies/Custom Parts/Jetson Nano Case Bottom.STL
3D Parts and Assemblies/Custom Parts/Jetson Nano Case Top.STL
3D Parts and Assemblies/Custom Parts/LDO Case Bottom.STL
3D Parts and Assemblies/Custom Parts/LDO Case Mount Clamp.STL
3D Parts and Assemblies/Custom Parts/LDO Case Top.STL
3D Parts and Assemblies/Custom Parts/Load Cell ADC Case Bottom.STL
3D Parts and Assemblies/Custom Parts/Load Cell ADC Case Mount Clamp.STL
3D Parts and Assemblies/Custom Parts/Load Cell ADC Case Top.STL
3D Parts and Assemblies/Custom Parts/Motor Slot Intermediate.STL
3D Parts and Assemblies/Custom Parts/Nucleo Case Bottom.STL
3D Parts and Assemblies/Custom Parts/Nucleo Case Inner Clamp.STL
3D Parts and Assemblies/Custom Parts/Nucleo Case Outer Clamp.STL
3D Parts and Assemblies/Custom Parts/Nucleo Case Top.STL
3D Parts and Assemblies/Custom Parts/Yaw Servo Mount Clamp.STL
3D Parts and Assemblies/Models & Used Designs/Gimbal-Intermediate.stl
3D Parts and Assemblies/Models & Used Designs/M3 Screw.SLDPRT
