far-mat42/mte-481-g29/3D Parts and Assemblies/Custom Parts/Drawings/3V3 LDO Case.pdf

3.50

15.00

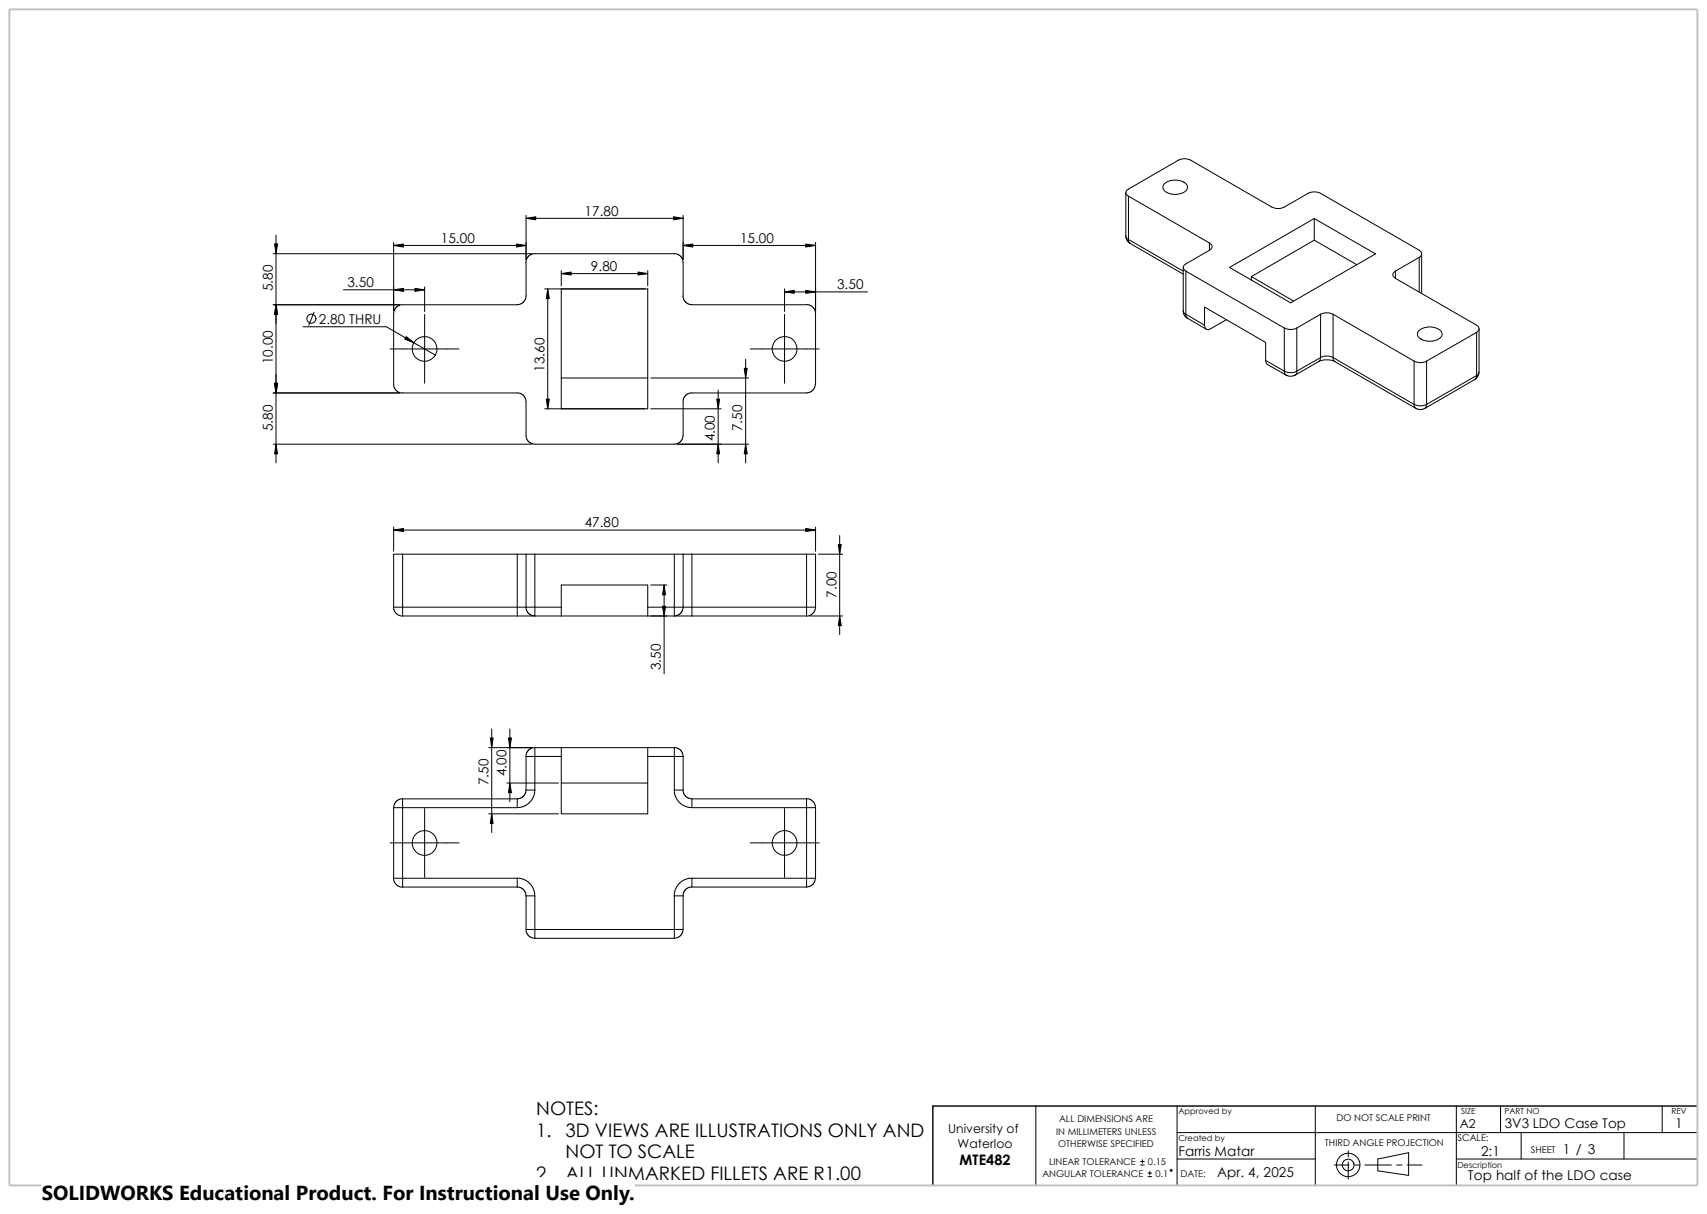
[picture p46: page 1]
DATE:; Apr. 4, 2025; 2.80 THRU 5.80 10.00 5.80

NOTES:
1. 3D VIEWS ARE ILLUSTRATIONS ONLY AND
NOT TO SCALE
2. ALL UNMARKED FILLETS ARE R1.00

University of Waterloo MTE482 | ALL DIMENSIONS ARE IN MILLIMETERS UNLESS OTHERWISE SPECIFIED LINEAR TOLERANCE 0.15 ANGULAR TOLERANCE 0.1 | Approved by | DO NOT SCALE PRINT | SIZE A2 | PART NO 3V3 LDO Case Top | REV 1

Created by Farris Matar | THIRD ANGLE PROJECTION | SCALE: 2:1 | SHEET 1 3 /

Description
Top half of the LDO case

SOLIDWORKS Educational Product. For Instructional Use Only.

6.00 | 19.00 | 6.00 | 8.40 ⁵.80 10.00 5.80

## 2.80 THRU

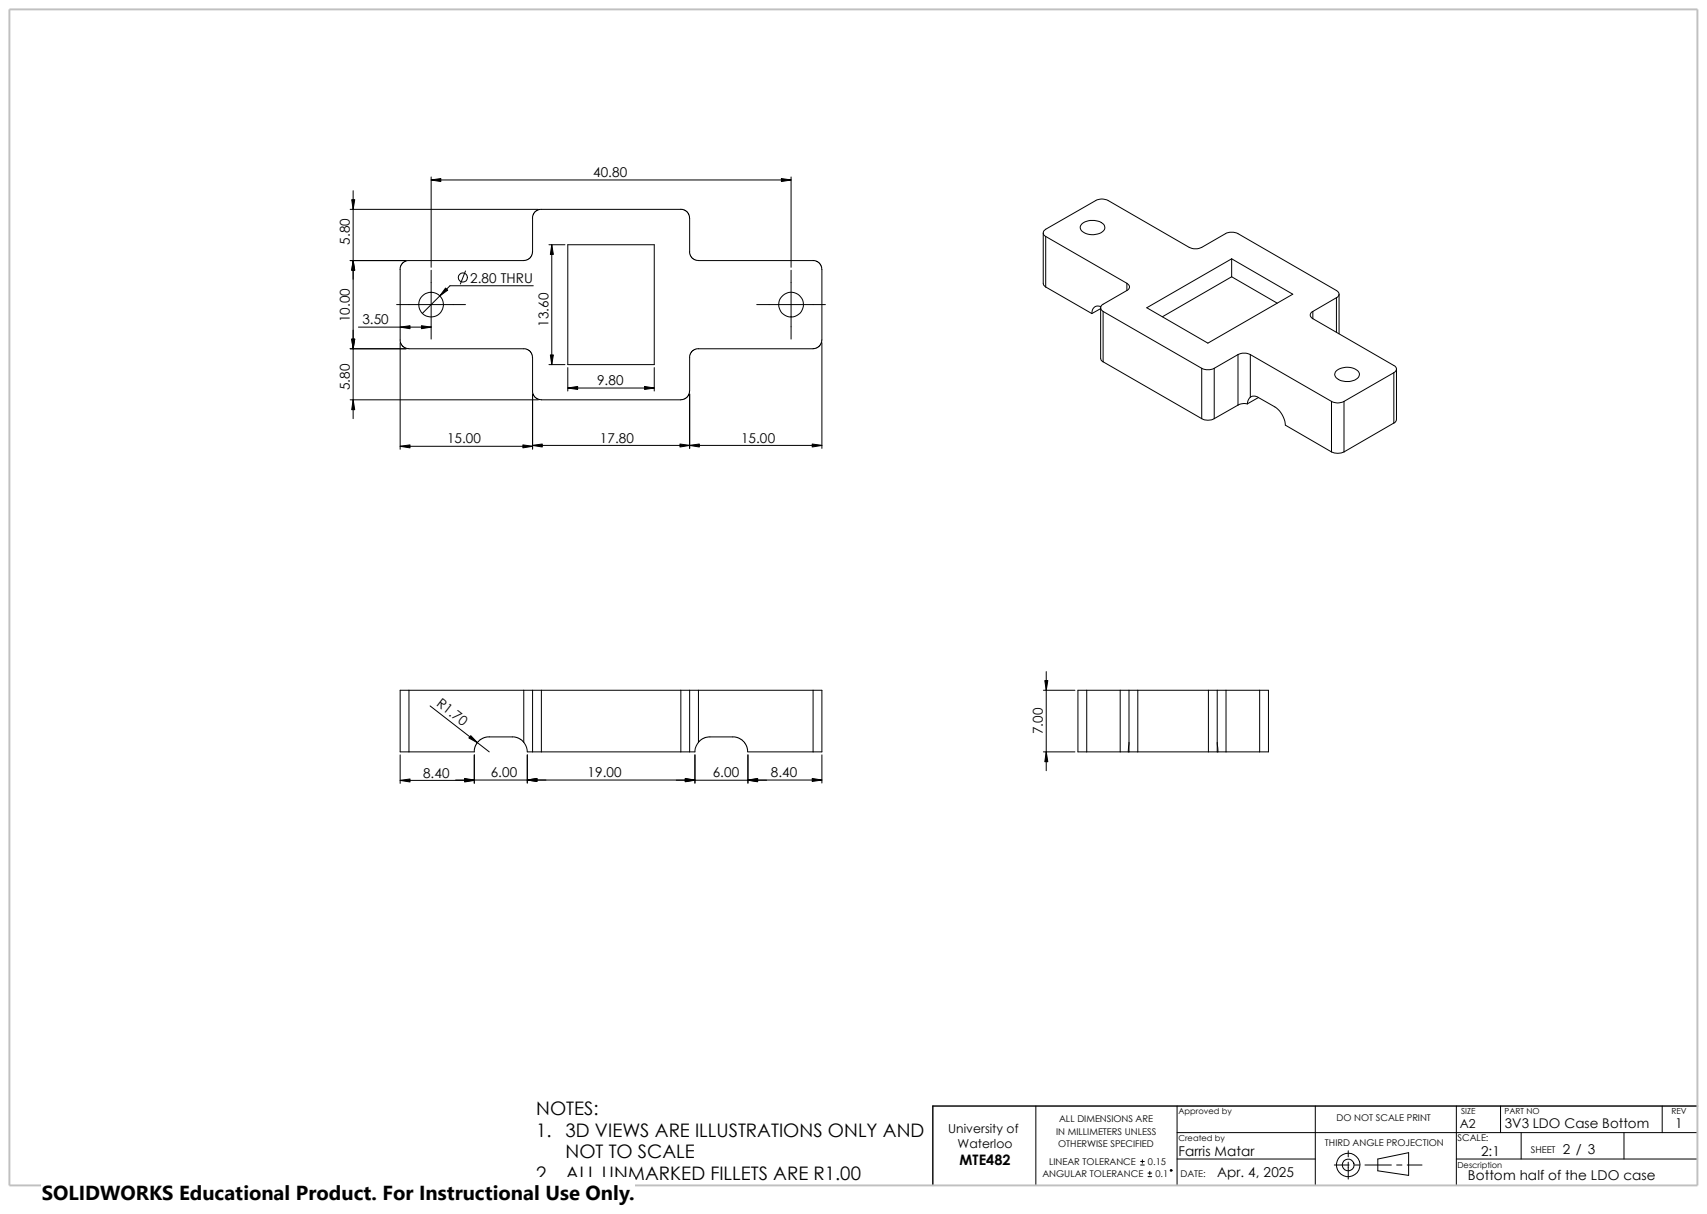
[picture p47: page 2]
NOTES:

3V3 LDO Case Bottom | 1
2:1 | 2 3 /

Bottom half of the LDO case

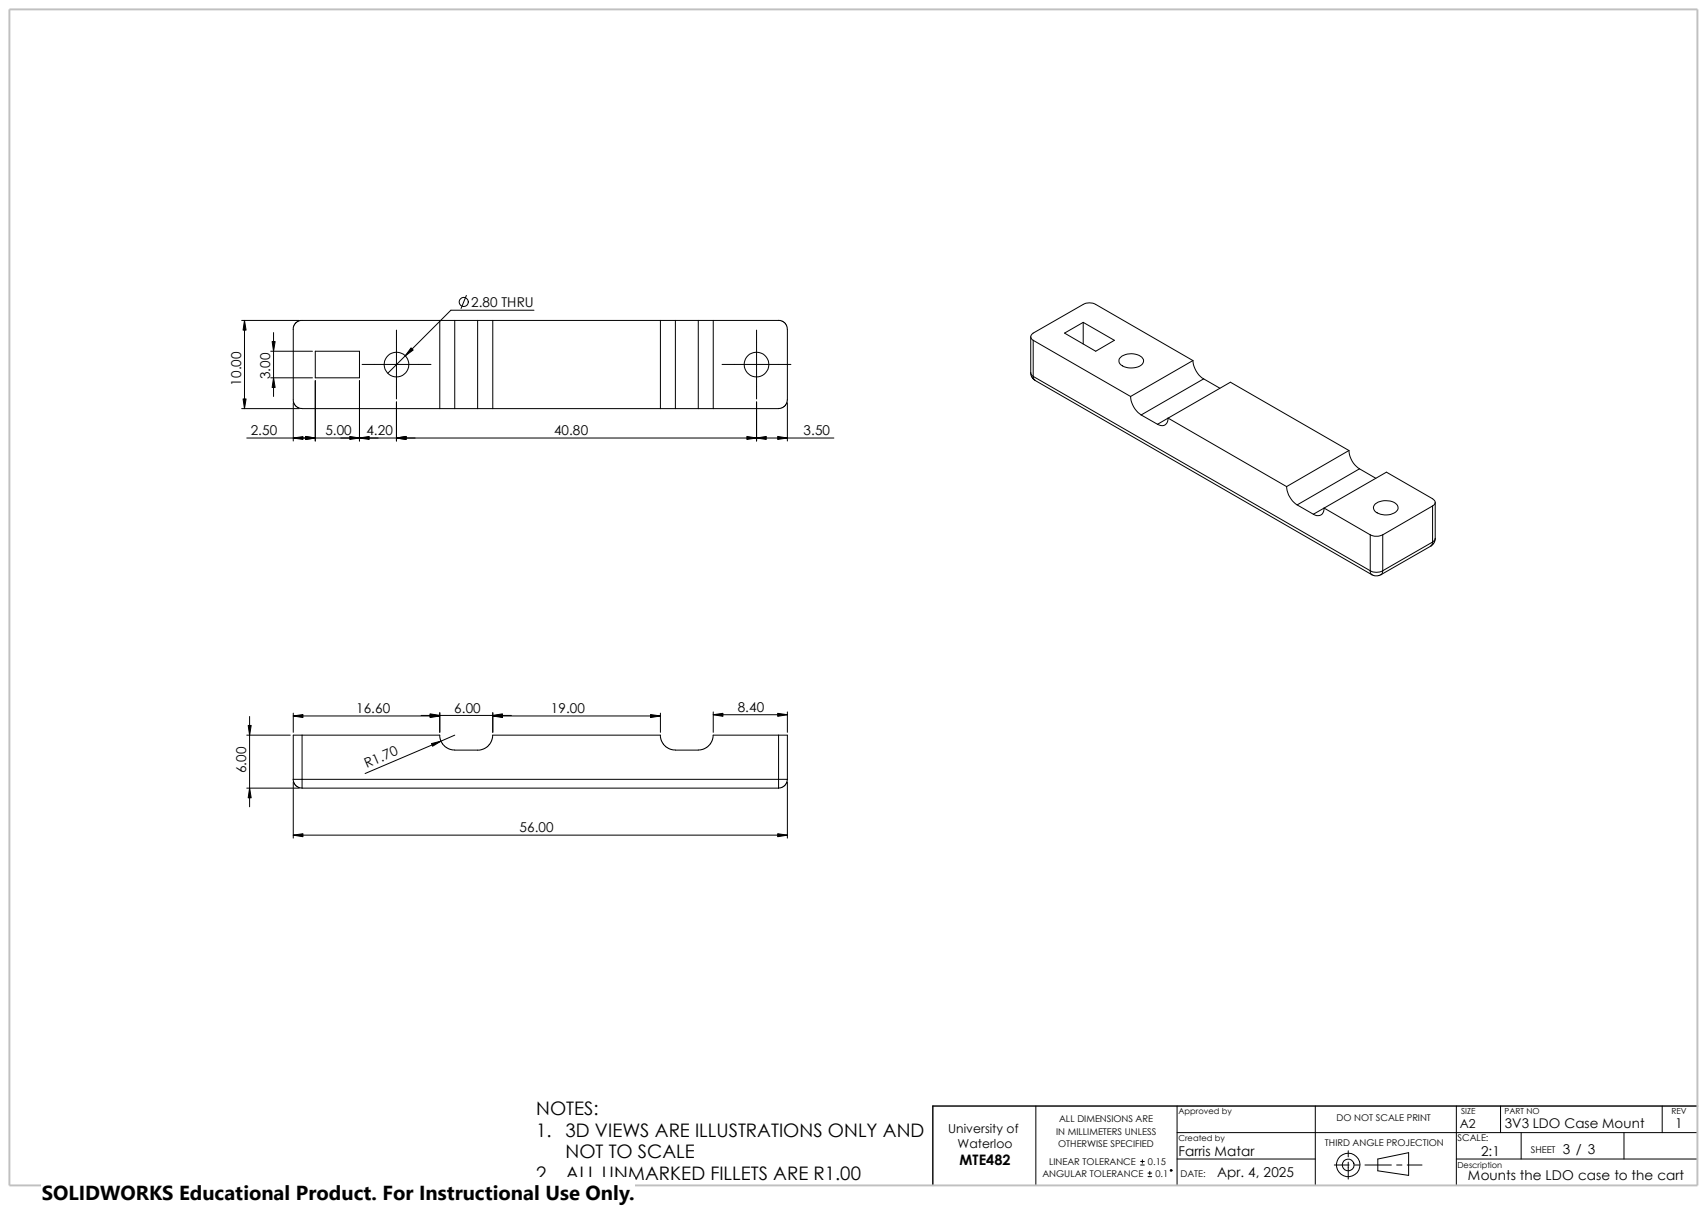
[picture p48: page 3]
2.80 THRU 3.00; NOTES:

3V3 LDO Case Mount
2:1 | 3 3 /

Mounts the LDO case to the cart
