far-mat42/mte-481-g29/3D Parts and Assemblies/Custom Parts/Drawings/Barcode Scanner & Gimbal Mount.pdf

## TRUE R1.90 5.00

## TRUE R1.38

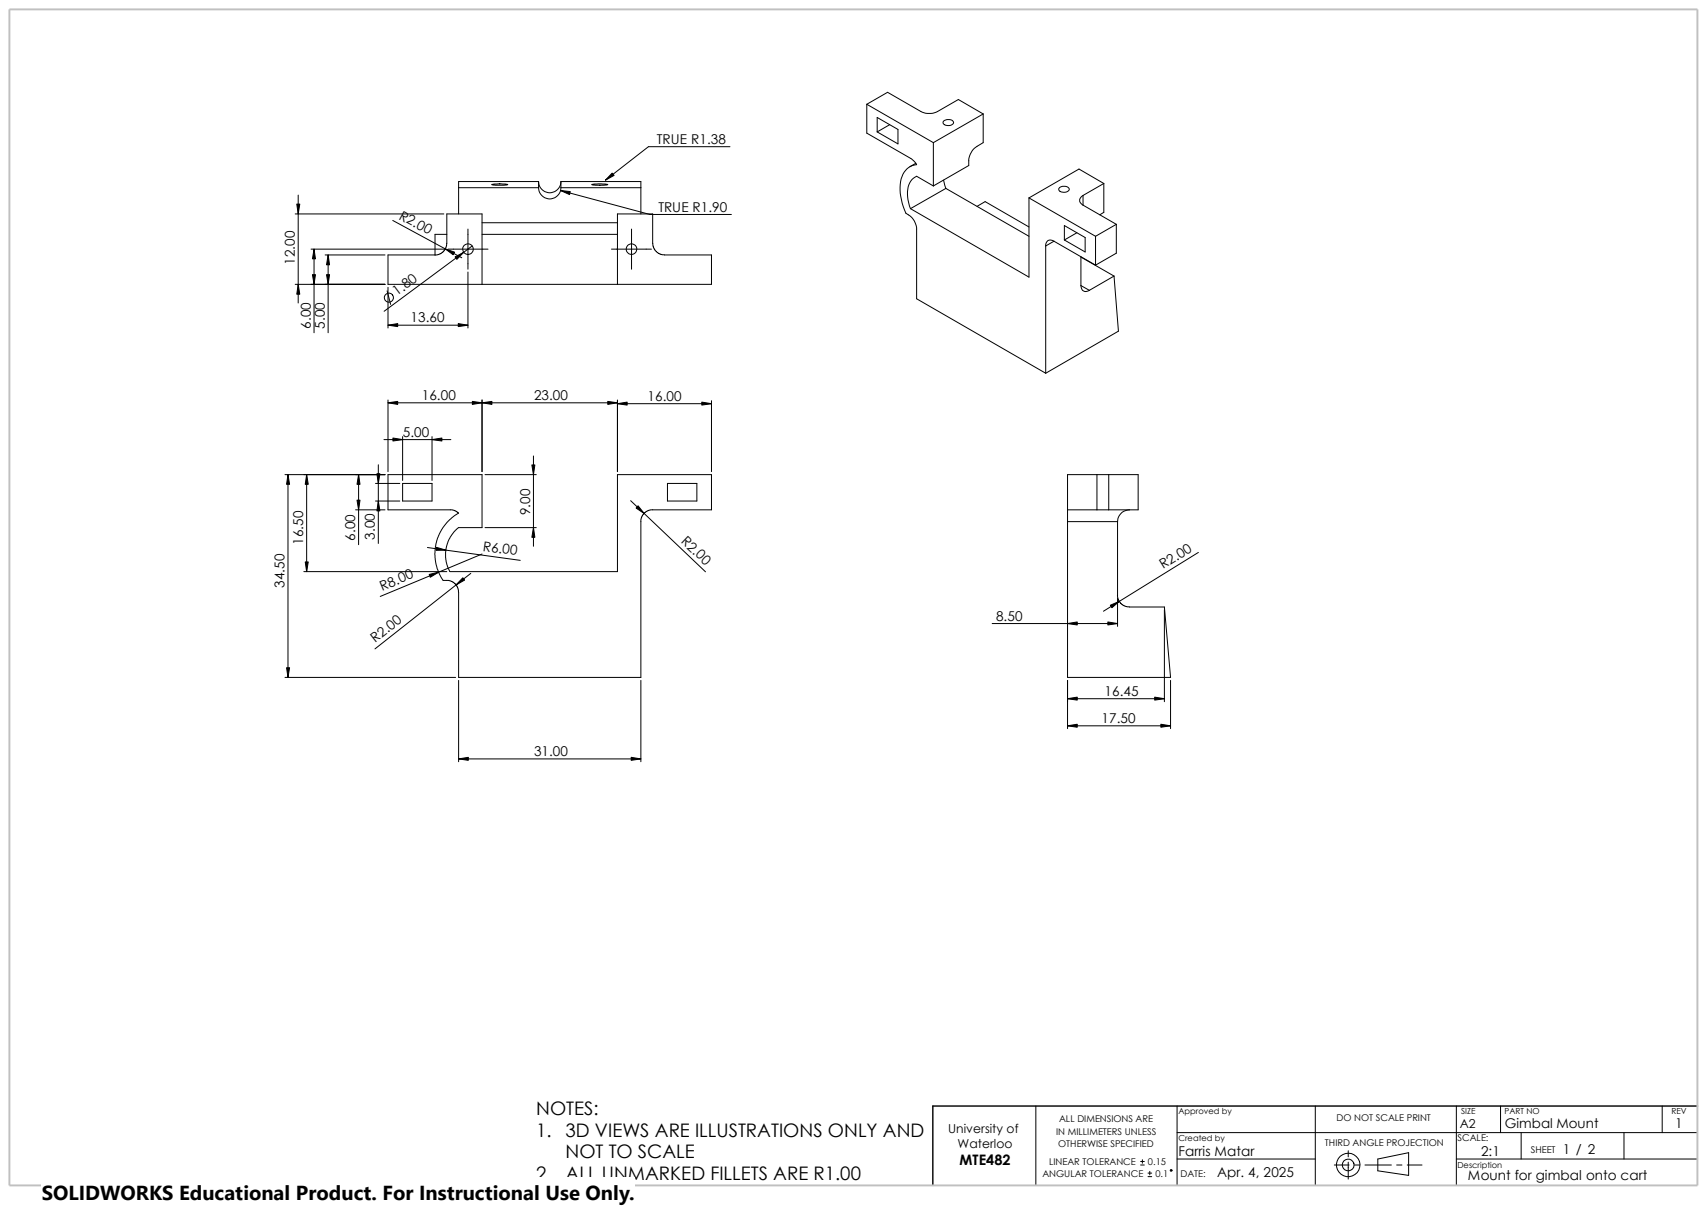
[picture p49: page 1]
Apr. 4, 2025; DATE:

NOTES:
1. 3D VIEWS ARE ILLUSTRATIONS ONLY AND
NOT TO SCALE
2. ALL UNMARKED FILLETS ARE R1.00

University of Waterloo MTE482 | ALL DIMENSIONS ARE IN MILLIMETERS UNLESS OTHERWISE SPECIFIED LINEAR TOLERANCE 0.15 ANGULAR TOLERANCE 0.1 | Approved by | DO NOT SCALE PRINT | SIZE A2 | PART NO Gimbal Mount | REV 1
Created by Farris Matar | THIRD ANGLE PROJECTION | SCALE: 2:1 | SHEET 1 / 2

Description
Mount for gimbal onto cart

SOLIDWORKS Educational Product. For Instructional Use Only.

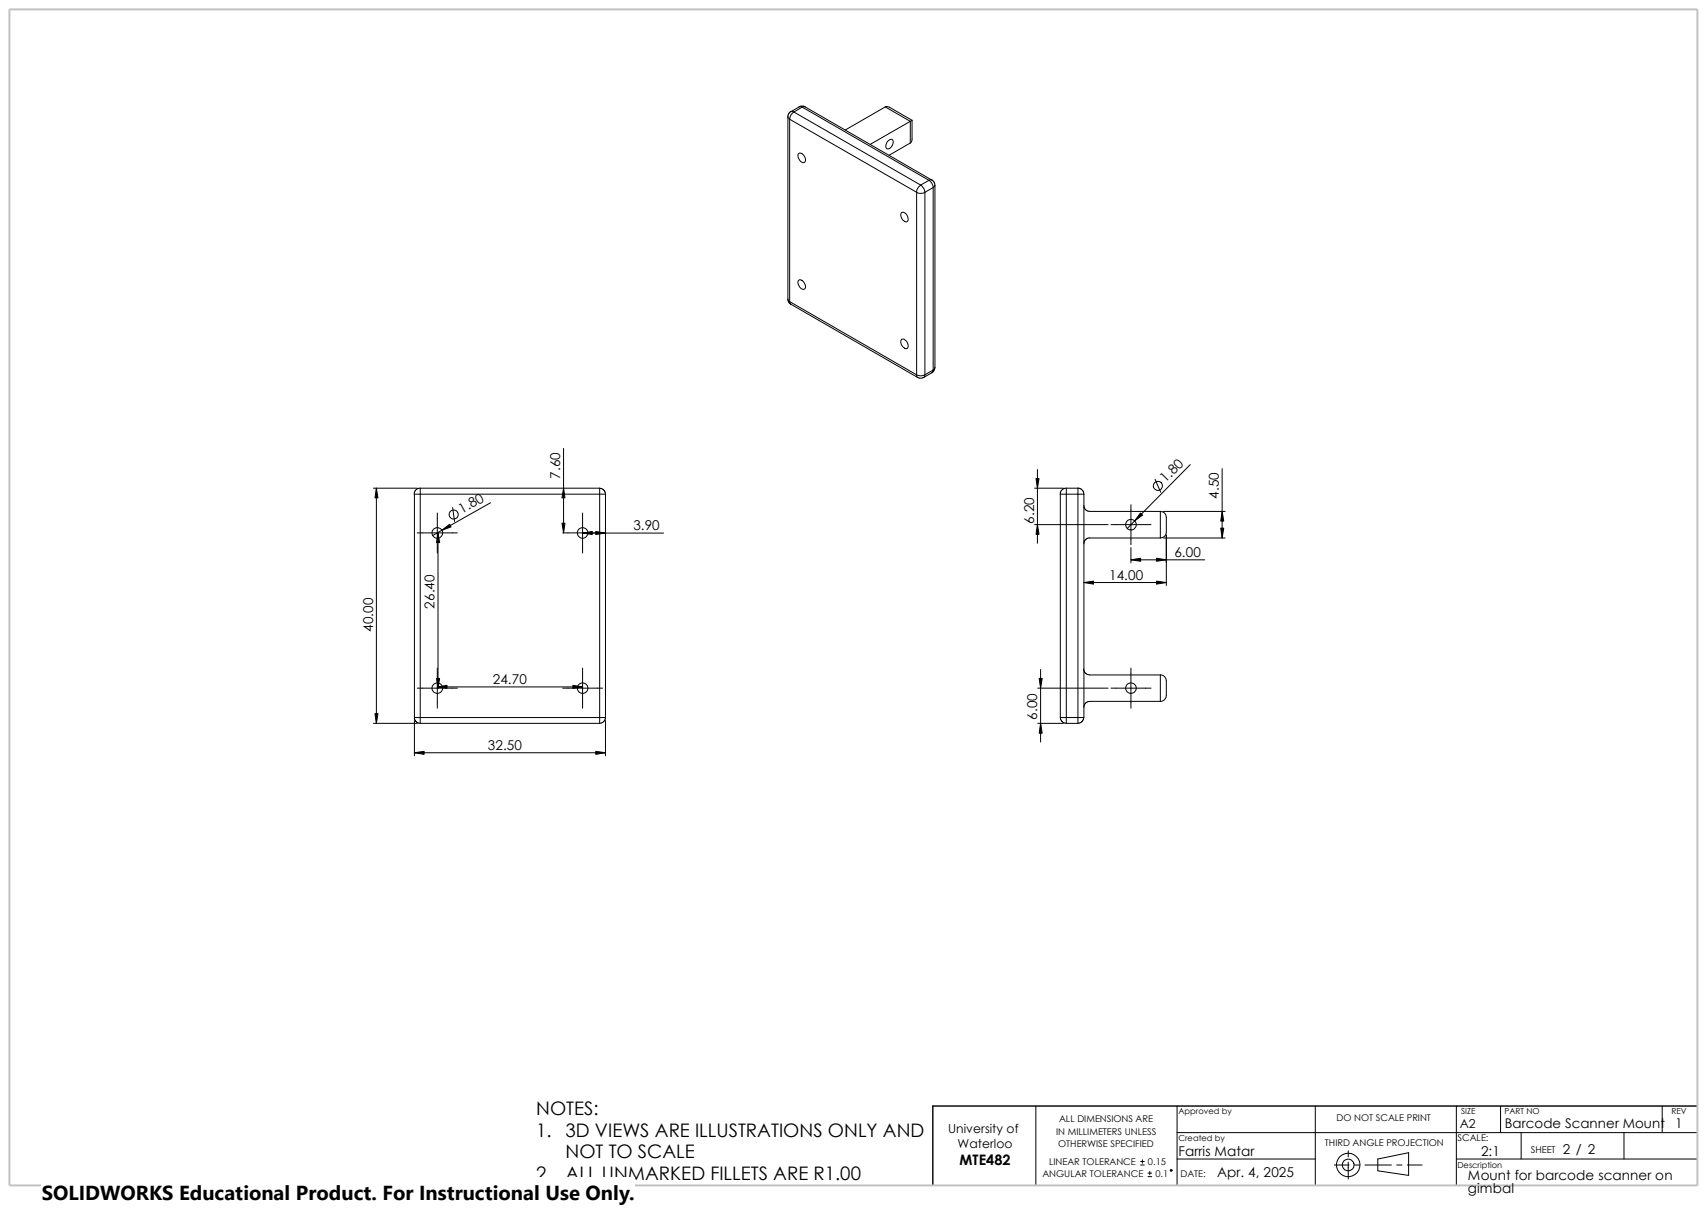
[picture p50: page 2]
0.1 Apr. 4, 2025 DATE:

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

University of Waterloo MTE482 | ALL DIMENSIONS ARE IN MILLIMETERS UNLESS OTHERWISE SPECIFIED LINEAR TOLERANCE 0.15 ANGULAR TOLERANCE | Approved by | DO NOT SCALE PRINT | SIZE A2 | PART NO Barcode Scanner Mount | REV 1
Created by Farris Matar | THIRD ANGLE PROJECTION | SCALE: 2:1 | SHEET 2 / 2

Description
Mount for barcode scanner on
gimbal

SOLIDWORKS Educational Product. For Instructional Use Only.
