far-mat42/mte-481-g29/3D Parts and Assemblies/Custom Parts/Drawings/Battery Case.pdf

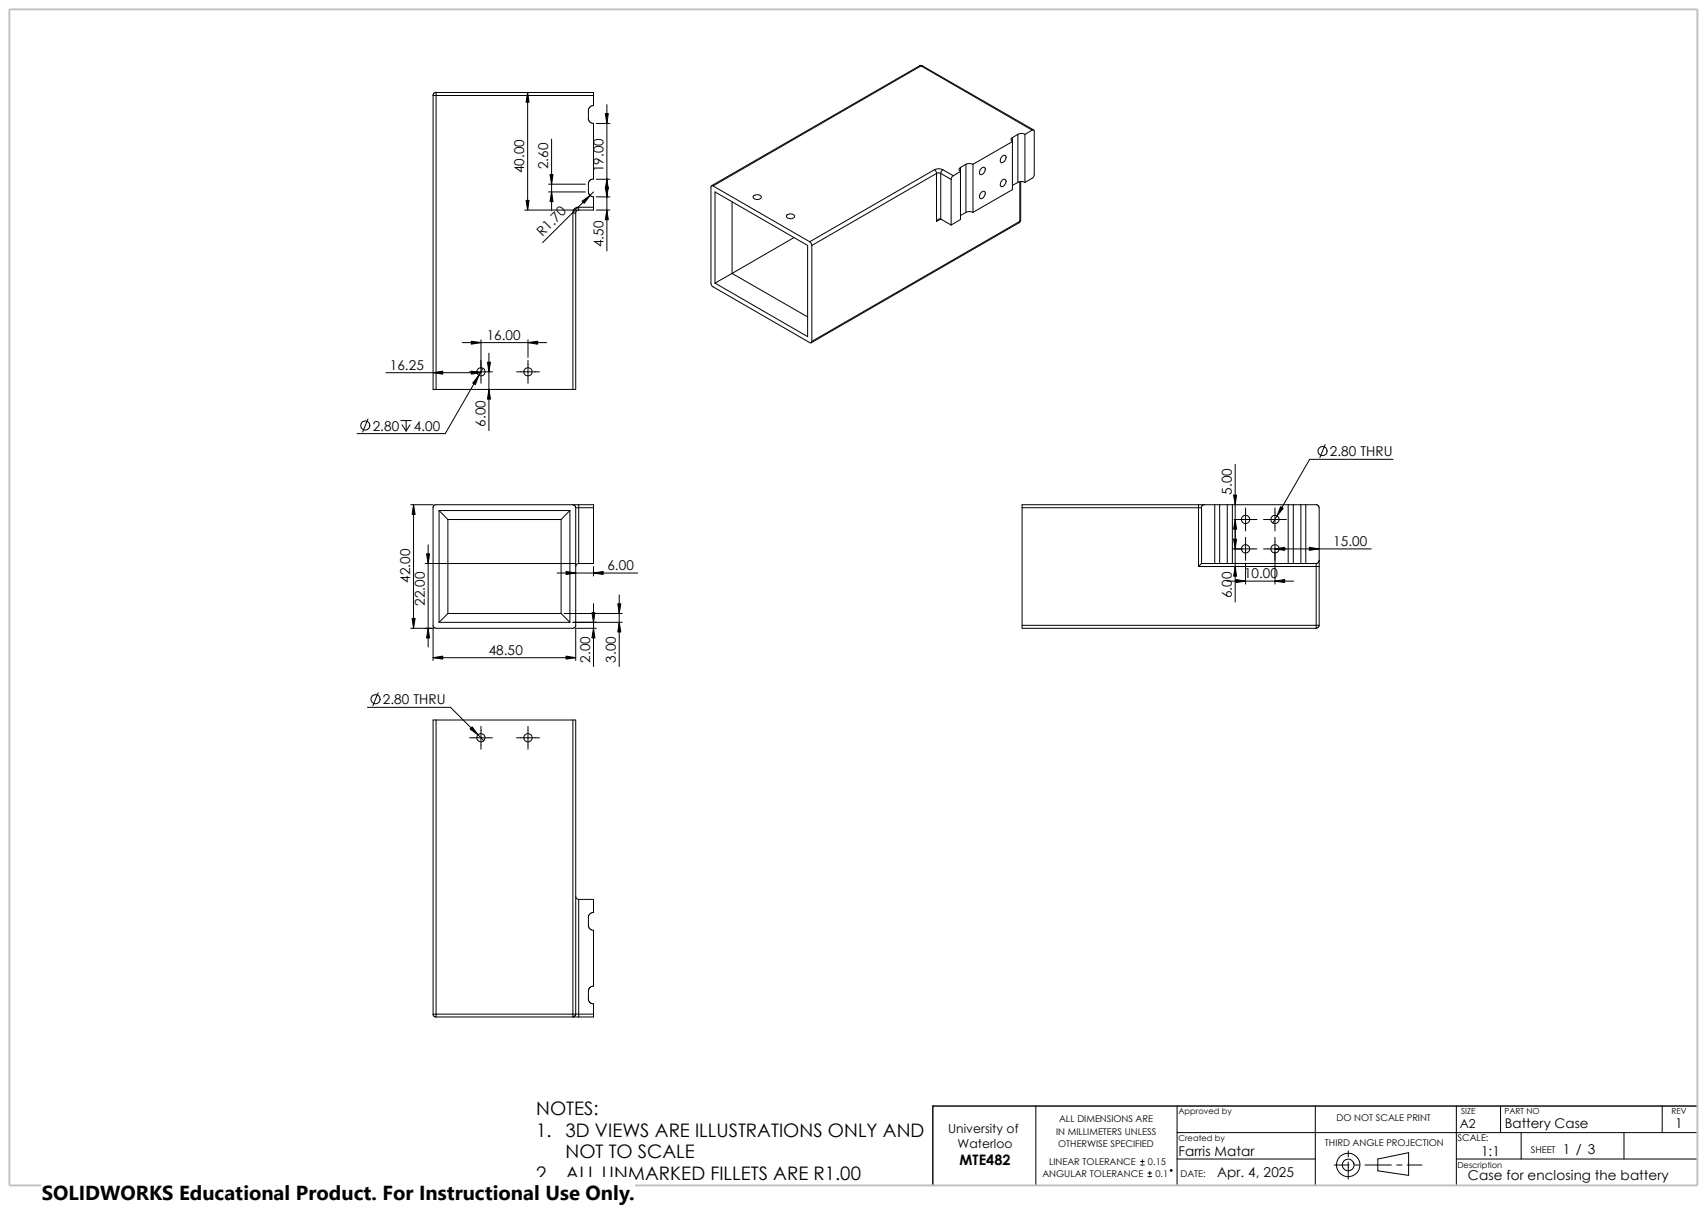
[picture p51: page 1]
DATE:; Apr. 4, 2025; 2.80 THRU; 2.80 THRU 5.00 6.00

NOTES:
1. 3D VIEWS ARE ILLUSTRATIONS ONLY AND
NOT TO SCALE
2. ALL UNMARKED FILLETS ARE R1.00

University of Waterloo MTE482 | ALL DIMENSIONS ARE IN MILLIMETERS UNLESS OTHERWISE SPECIFIED LINEAR TOLERANCE 0.15 ANGULAR TOLERANCE 0.1 | Approved by | DO NOT SCALE PRINT | SIZE A2 | PART NO Battery Case | REV 1

Created by Farris Matar | THIRD ANGLE PROJECTION | SCALE: 1:1 | SHEET 1 3 /

Description
Case for enclosing the battery

SOLIDWORKS Educational Product. For Instructional Use Only.

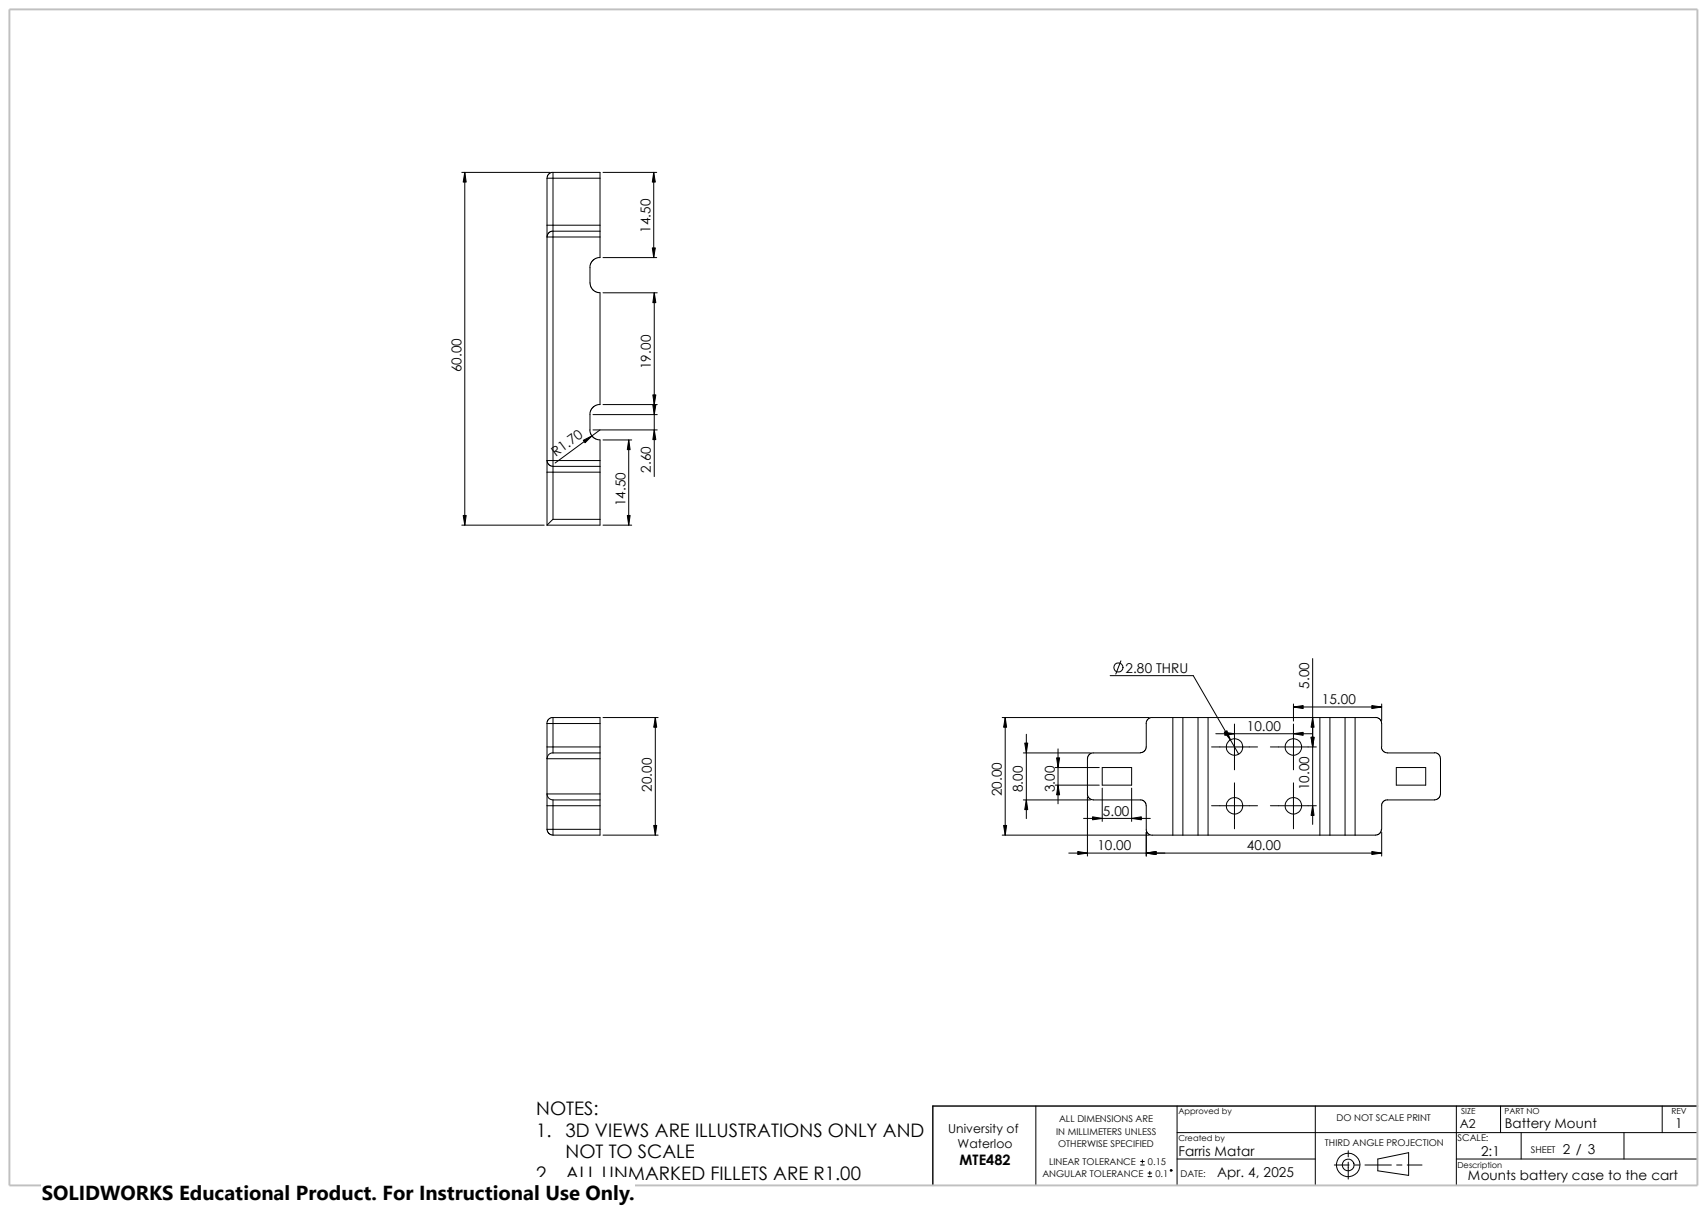
[picture p52: page 2]
2.80 THRU; NOTES:

Battery Mount
2:1 | 2 3 /

Mounts battery case to the cart

# 2.80 THRU 26.00 5.00

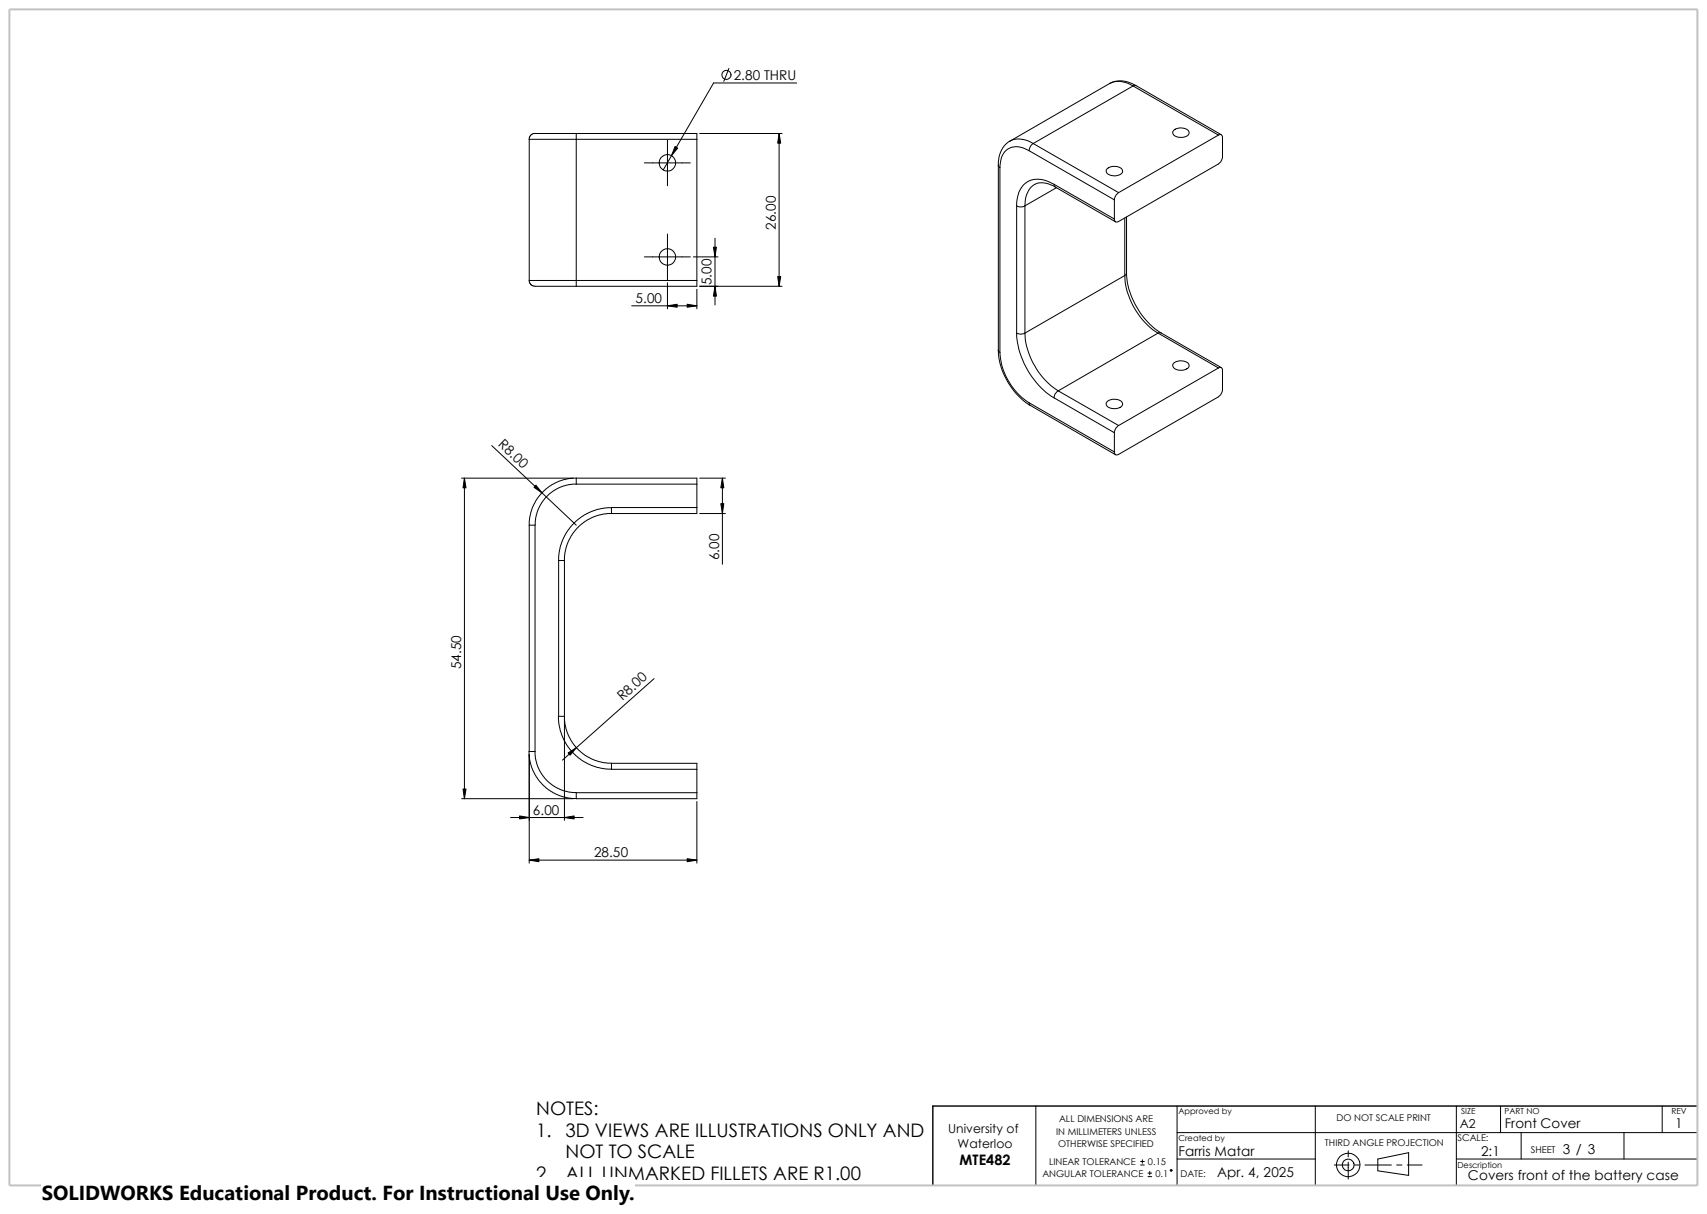
[picture p53: page 3]
NOTES:

Front Cover | 1
2:1 | 3 3 /

Covers front of the battery case
