far-mat42/mte-481-g29/3D Parts and Assemblies/Custom Parts/Drawings/ESP32 Case.pdf

# 2.50 THRU 7.00 8.00

7.50 | 6.00 | 2.00

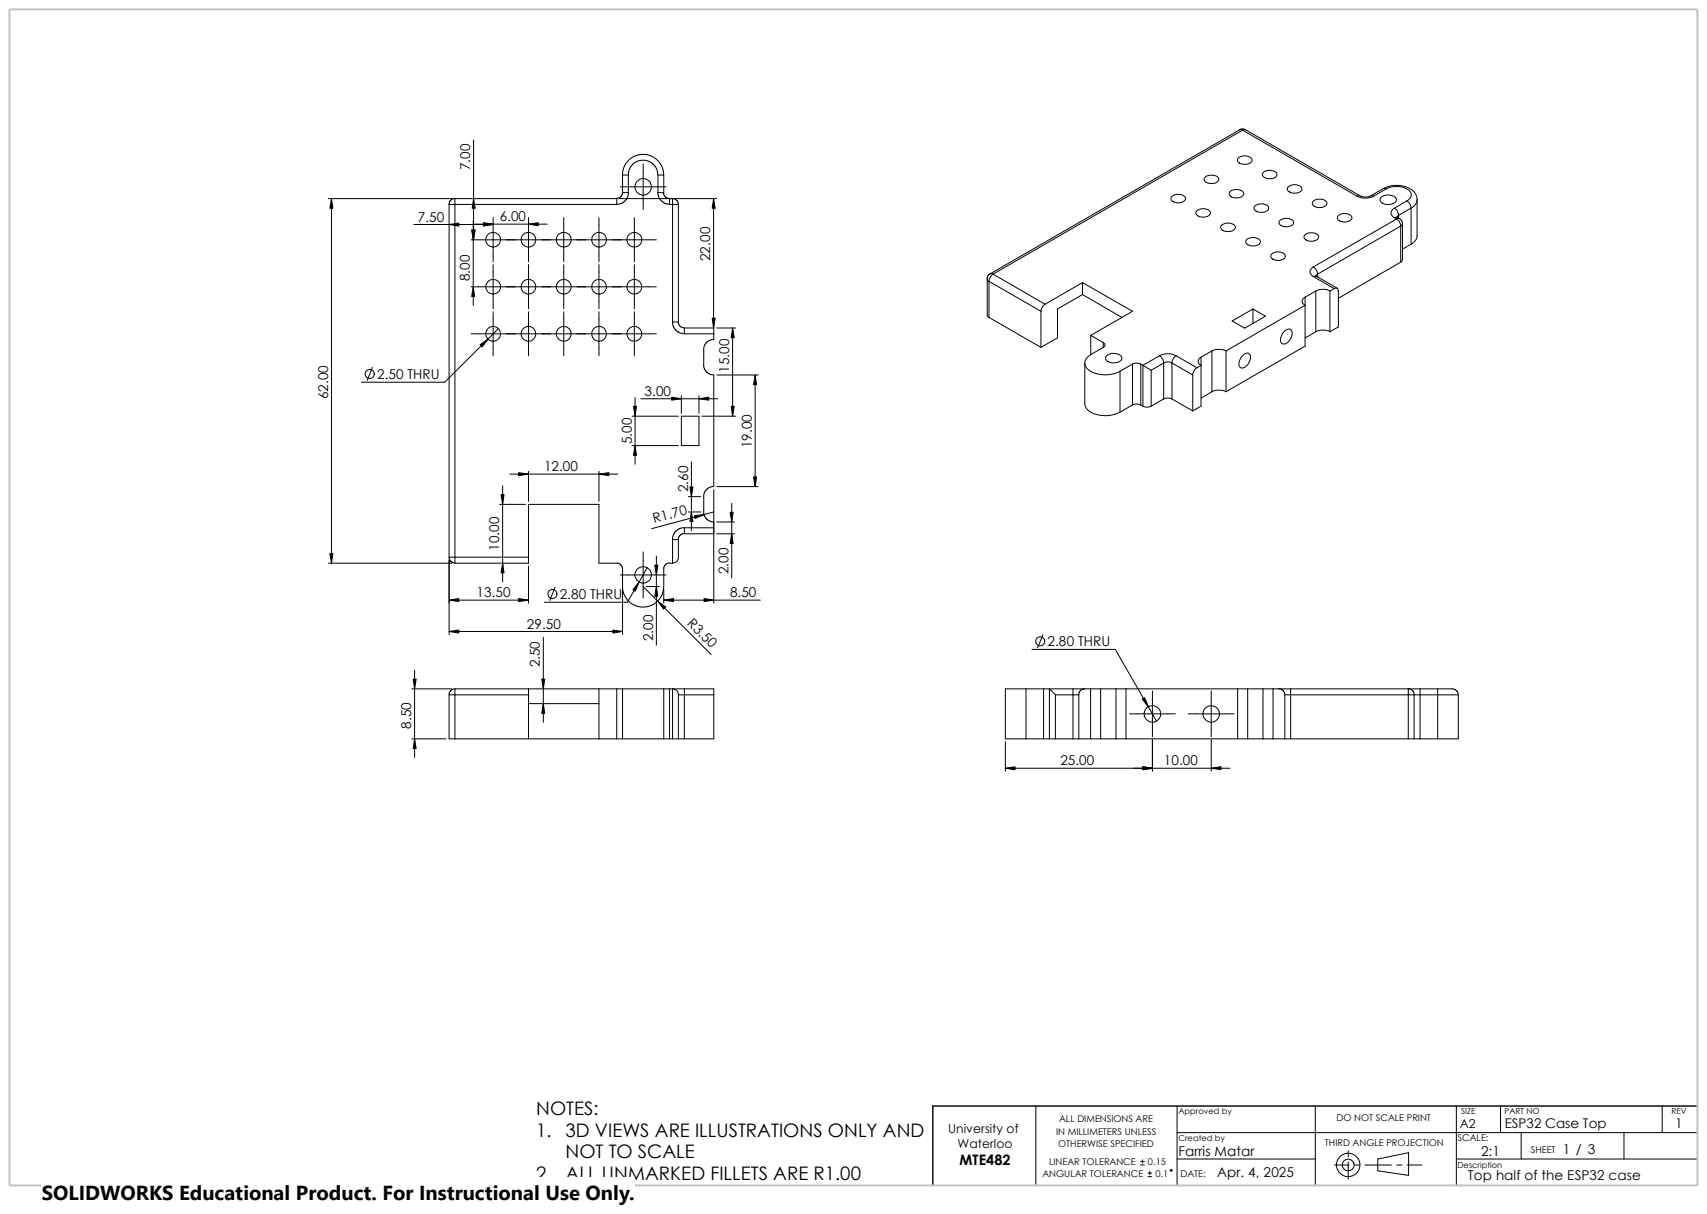
[picture p54: page 1]
DATE:; Apr. 4, 2025; 2.80 THRU

NOTES:
1. 3D VIEWS ARE ILLUSTRATIONS ONLY AND
NOT TO SCALE
2. ALL UNMARKED FILLETS ARE R1.00

University of Waterloo MTE482 | ALL DIMENSIONS ARE IN MILLIMETERS UNLESS OTHERWISE SPECIFIED LINEAR TOLERANCE 0.15 ANGULAR TOLERANCE 0.1 | Approved by | DO NOT SCALE PRINT | SIZE A2 | PART NO ESP32 Case Top | REV

Created by Farris Matar | THIRD ANGLE PROJECTION | SCALE: 2:1 | SHEET 1 3 /

Description
Top half of the ESP32 case

SOLIDWORKS Educational Product. For Instructional Use Only.

13.50 | 12.00 | 13.50 | 4.00

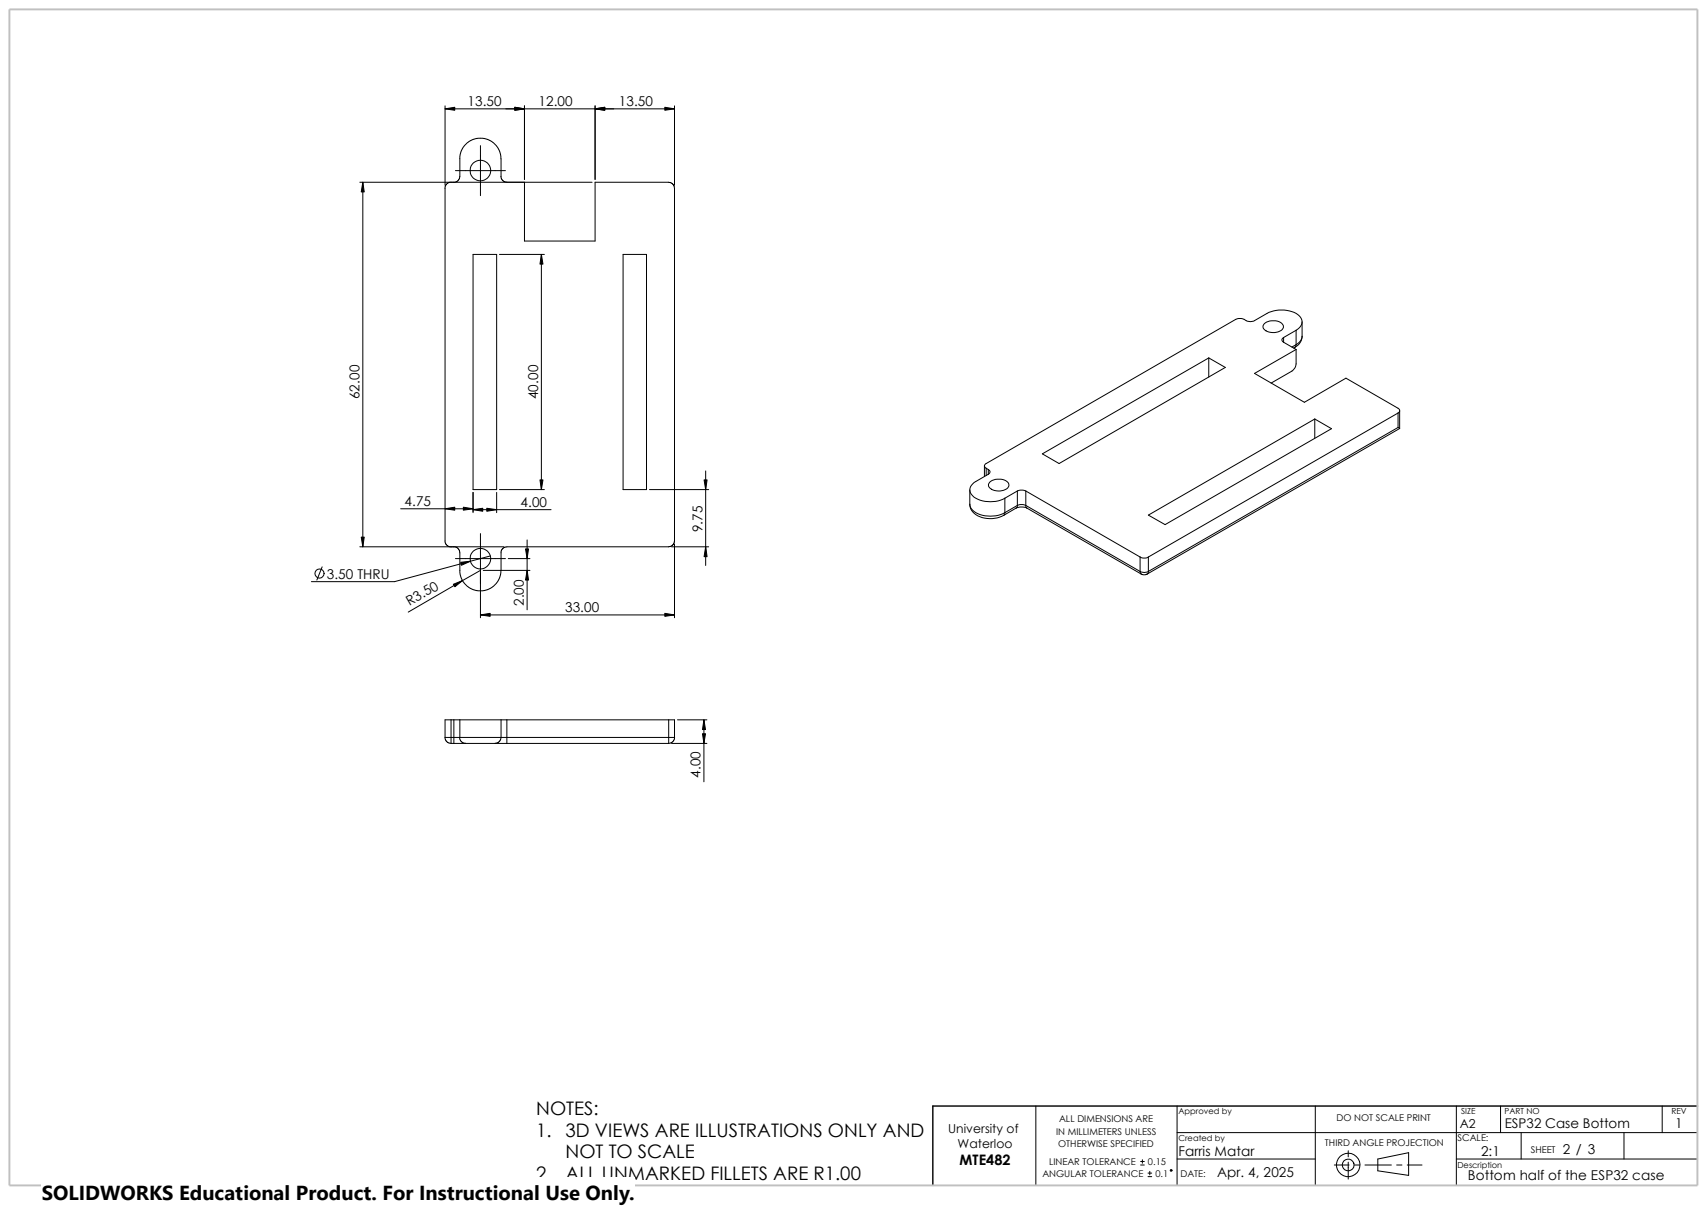
[picture p55: page 2]
3.50 THRU; NOTES:

ESP32 Case Bottom
2:1 | 2 3 /

Bottom half of the ESP32 case

## 3.50 THRU

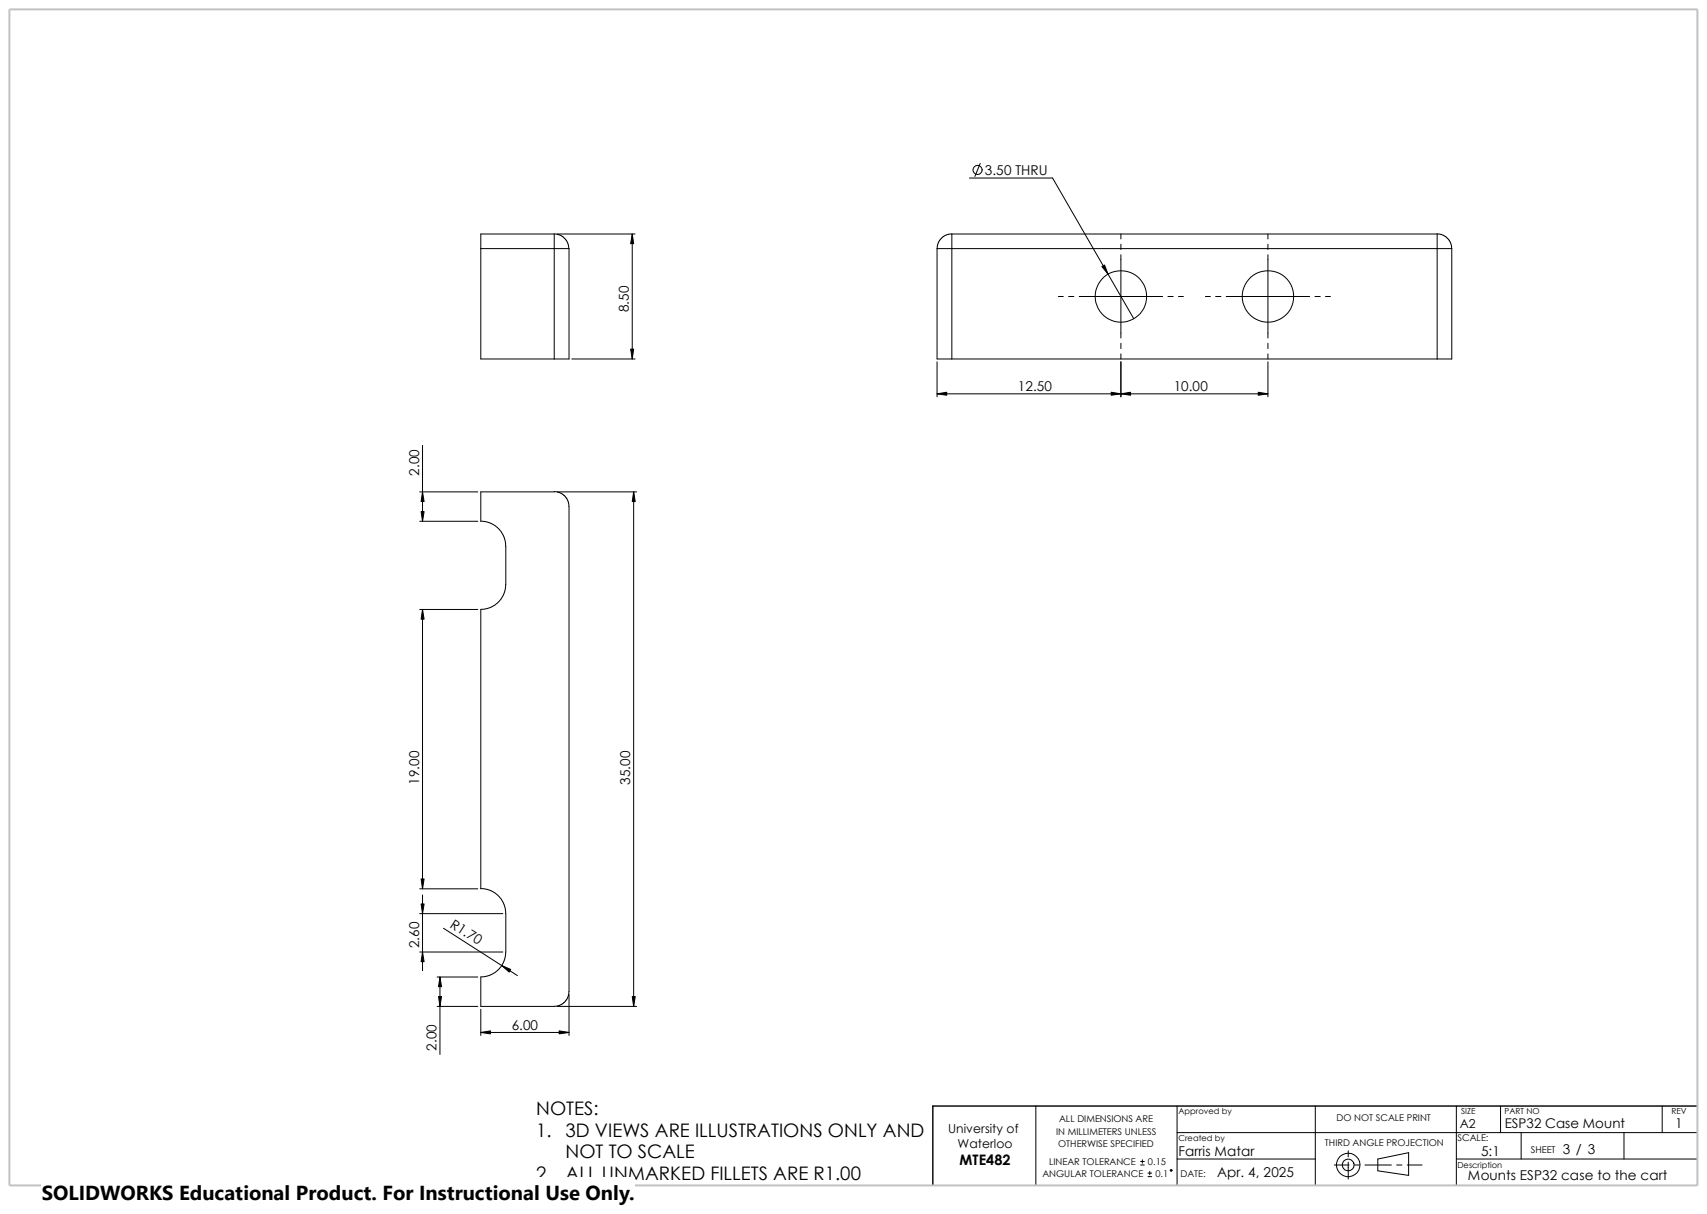
[picture p56: page 3]
NOTES:

ESP32 Case Mount
5:1 | 3 3 /

Mounts ESP32 case to the cart
