far-mat42/mte-481-g29/3D Parts and Assemblies/Custom Parts/Drawings/Gimbal Arms.pdf

4.00 8.50 14.6

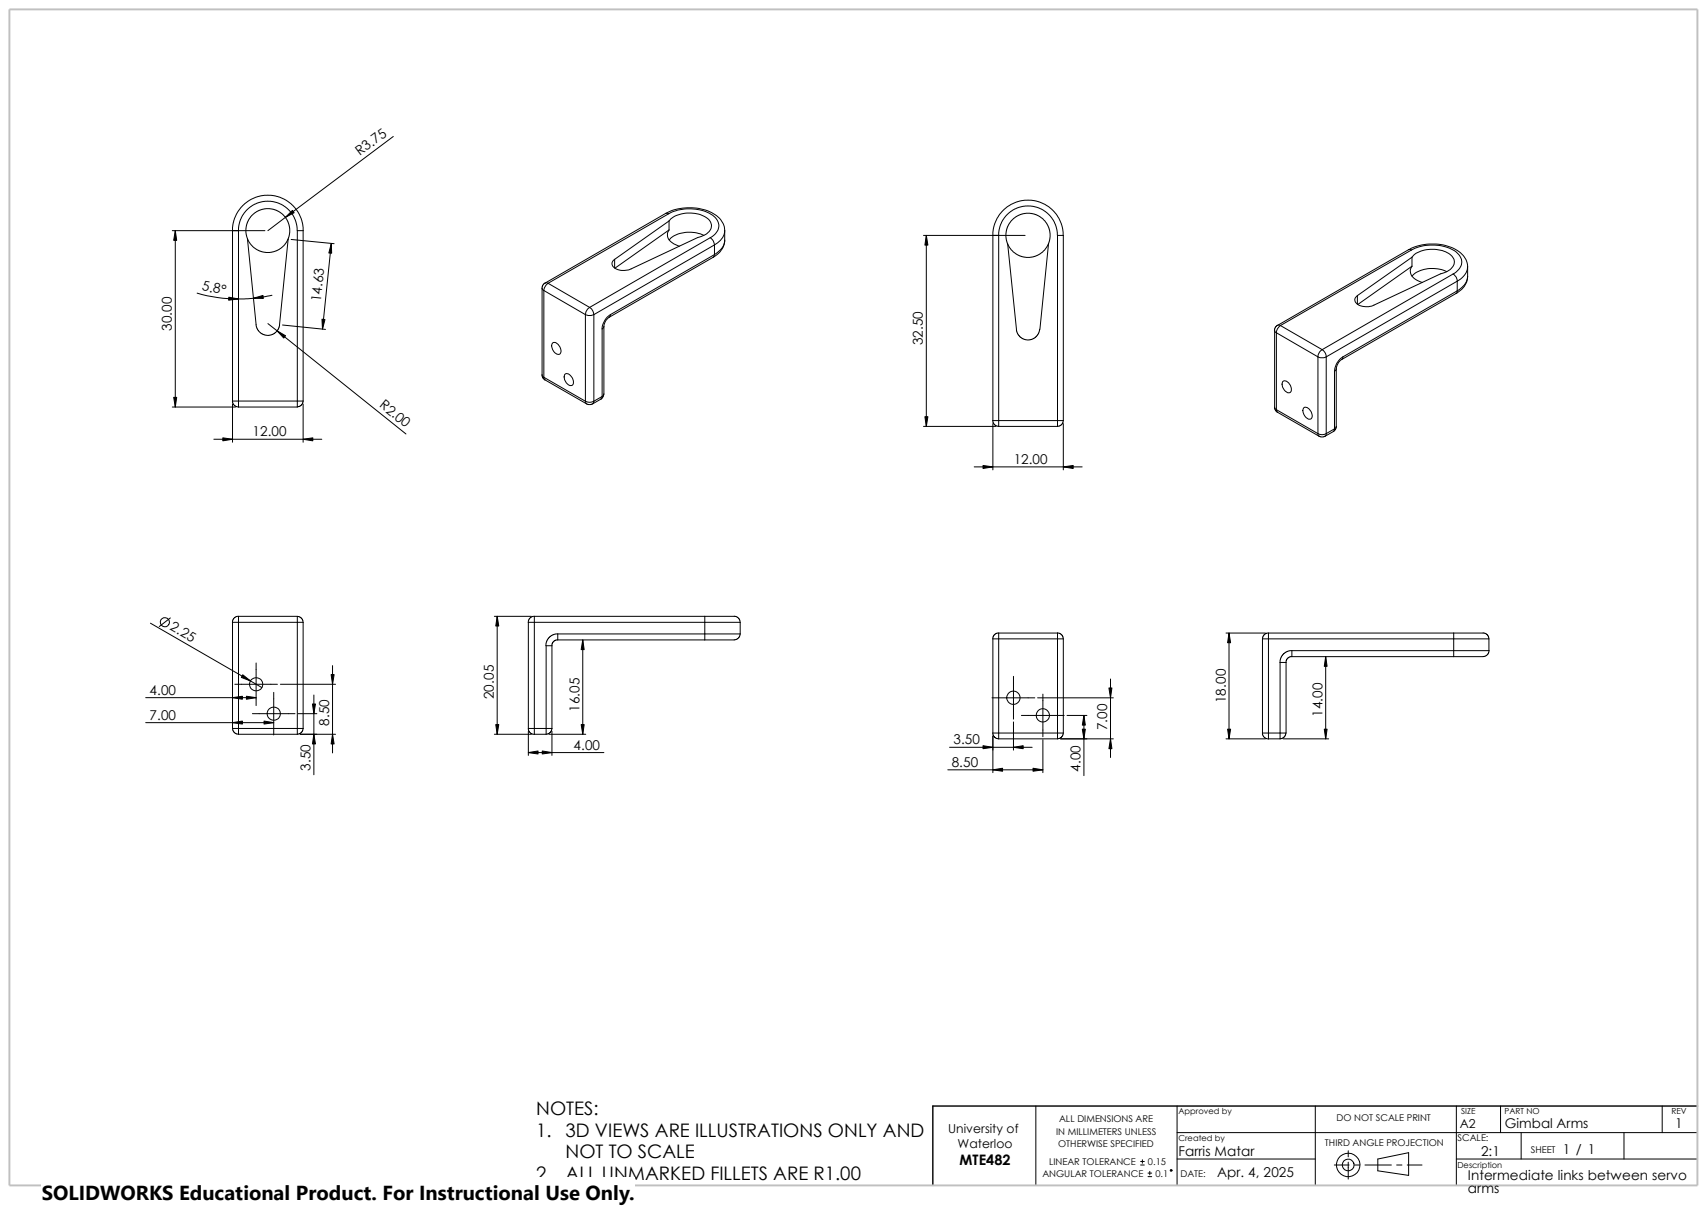
[picture p57: page 1]
Apr. 4, 2025; DATE:

2. ALL UNMARKED FILLETS ARE R1.00 ²⁰.05

NOTES:
1. 3D VIEWS ARE ILLUSTRATIONS ONLY AND
NOT TO SCALE

University of Waterloo MTE482 | ALL DIMENSIONS ARE IN MILLIMETERS UNLESS OTHERWISE SPECIFIED LINEAR TOLERANCE 0.15 ANGULAR TOLERANCE 0.1 | Approved by | DO NOT SCALE PRINT | SIZE A2 | PART NO Gimbal Arms | REV 1
Created by Farris Matar | THIRD ANGLE PROJECTION | SCALE: 2:1 | SHEET 1 / 1

Description
Intermediate links between servo
arms

SOLIDWORKS Educational Product. For Instructional Use Only.
