far-mat42/mte-481-g29/3D Parts and Assemblies/Custom Parts/Drawings/Jetson Case.pdf

2. ALL UNMARKED FILLETS ARE R1.00 ¹¹².00 96.00 | 104.00
40.80 23.65 | 6.30 10.00 | 19.00

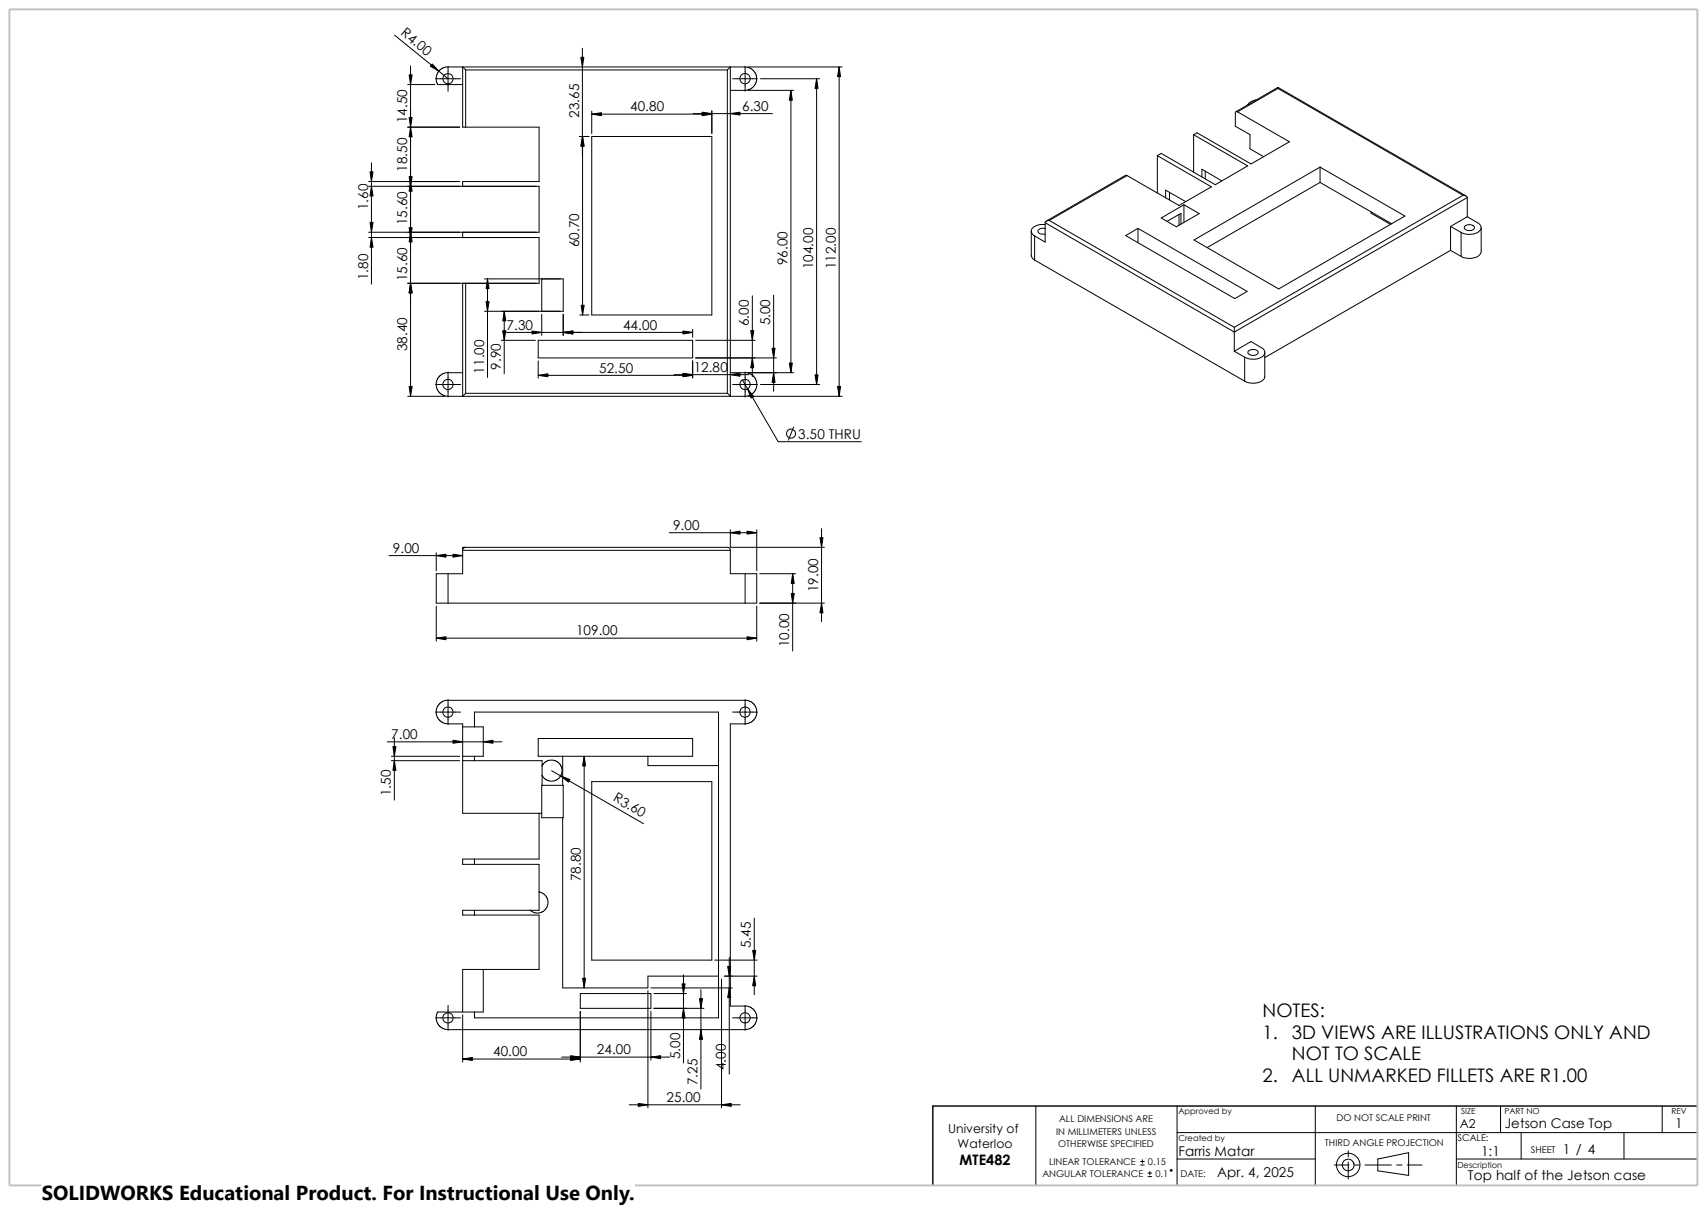
[picture p58: page 1]
DATE:; Apr. 4, 2025; 3.50 THRU

NOTES:
1. 3D VIEWS ARE ILLUSTRATIONS ONLY AND
NOT TO SCALE

University of Waterloo MTE482 | ALL DIMENSIONS ARE IN MILLIMETERS UNLESS OTHERWISE SPECIFIED LINEAR TOLERANCE 0.15 ANGULAR TOLERANCE 0.1 | Approved by | DO NOT SCALE PRINT | SIZE A2 | PART NO Jetson Case Top | REV 1

Created by Farris Matar | THIRD ANGLE PROJECTION | SCALE: 1:1 | SHEET 1 4 /

Description
Top half of the Jetson case

SOLIDWORKS Educational Product. For Instructional Use Only.

101.00

## 2.80 THRU

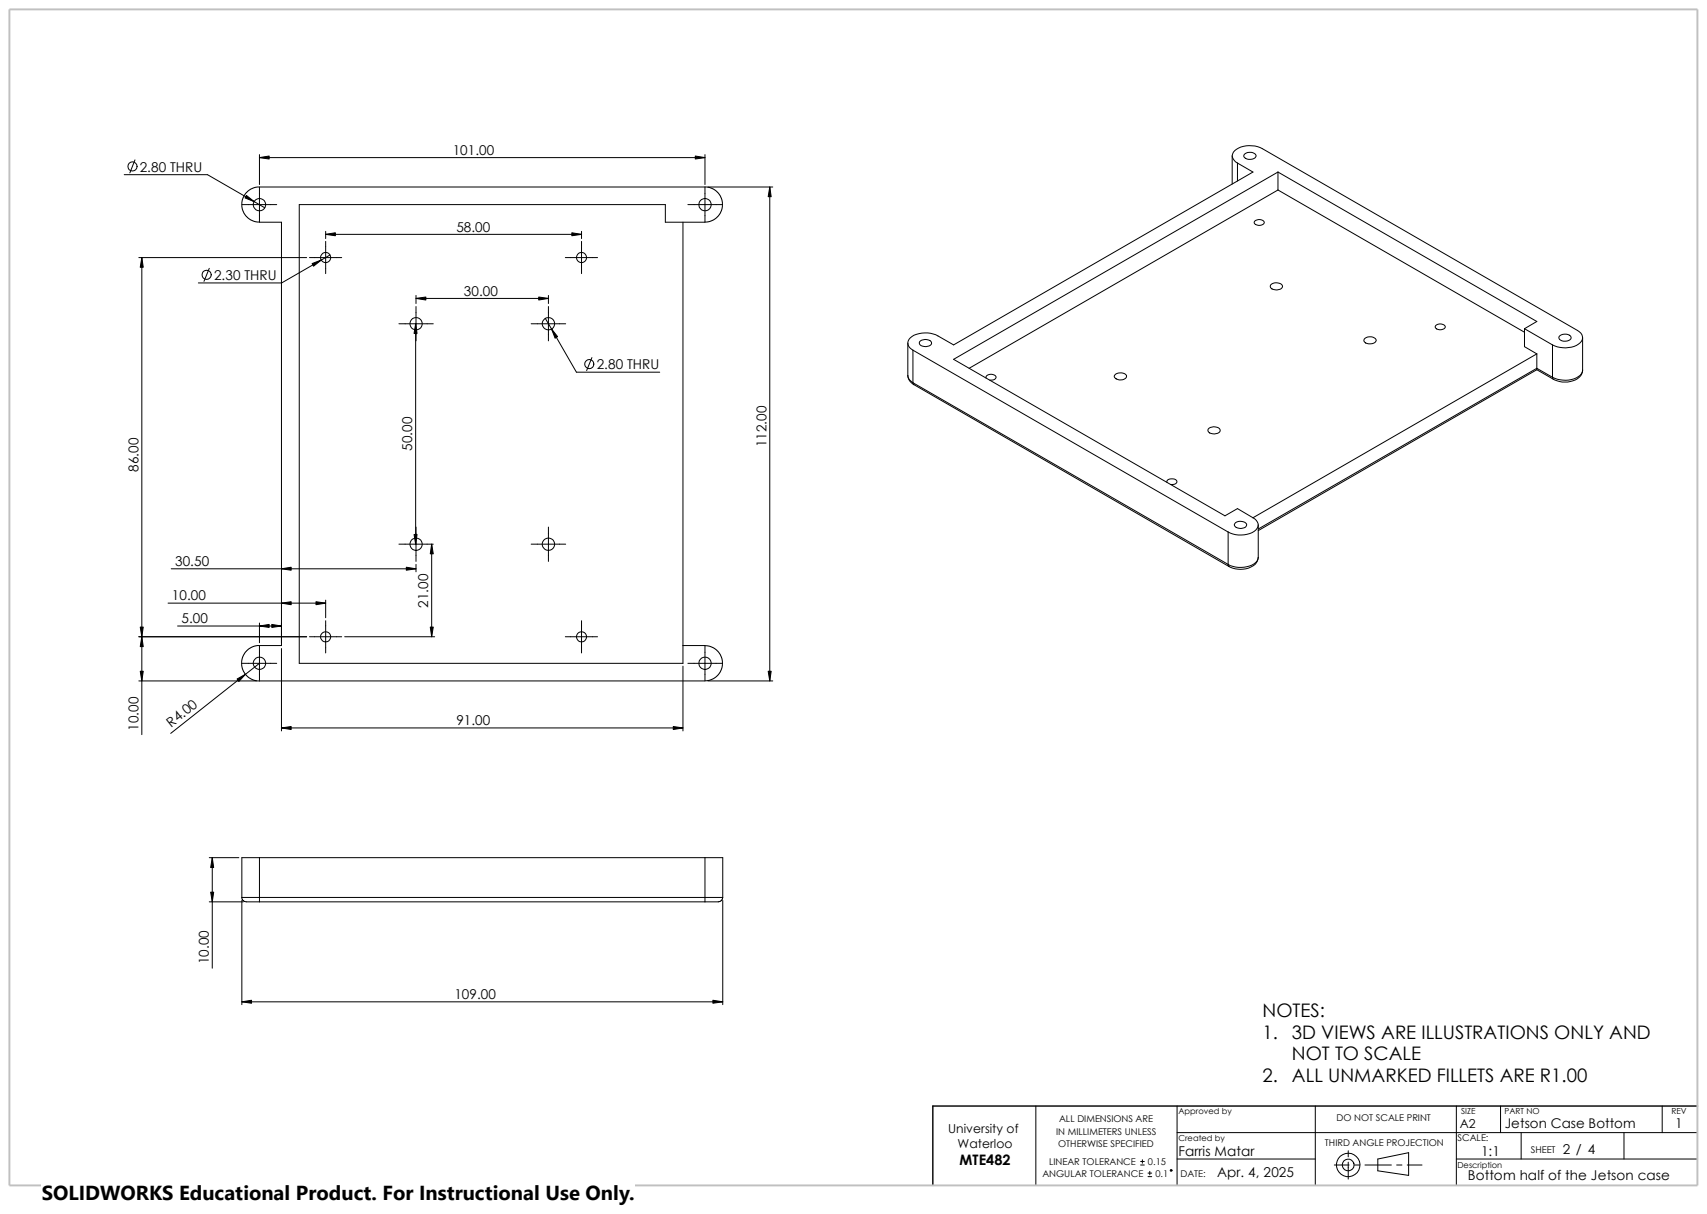
[picture p59: page 2]
2.30 THRU 86.00 10.00; 2.80 THRU

NOTES:
1. 3D VIEWS ARE ILLUSTRATIONS ONLY AND
NOT TO SCALE
2. ALL UNMARKED FILLETS ARE R1.00

Jetson Case Bottom
1:1 | 2 4 /

Bottom half of the Jetson case

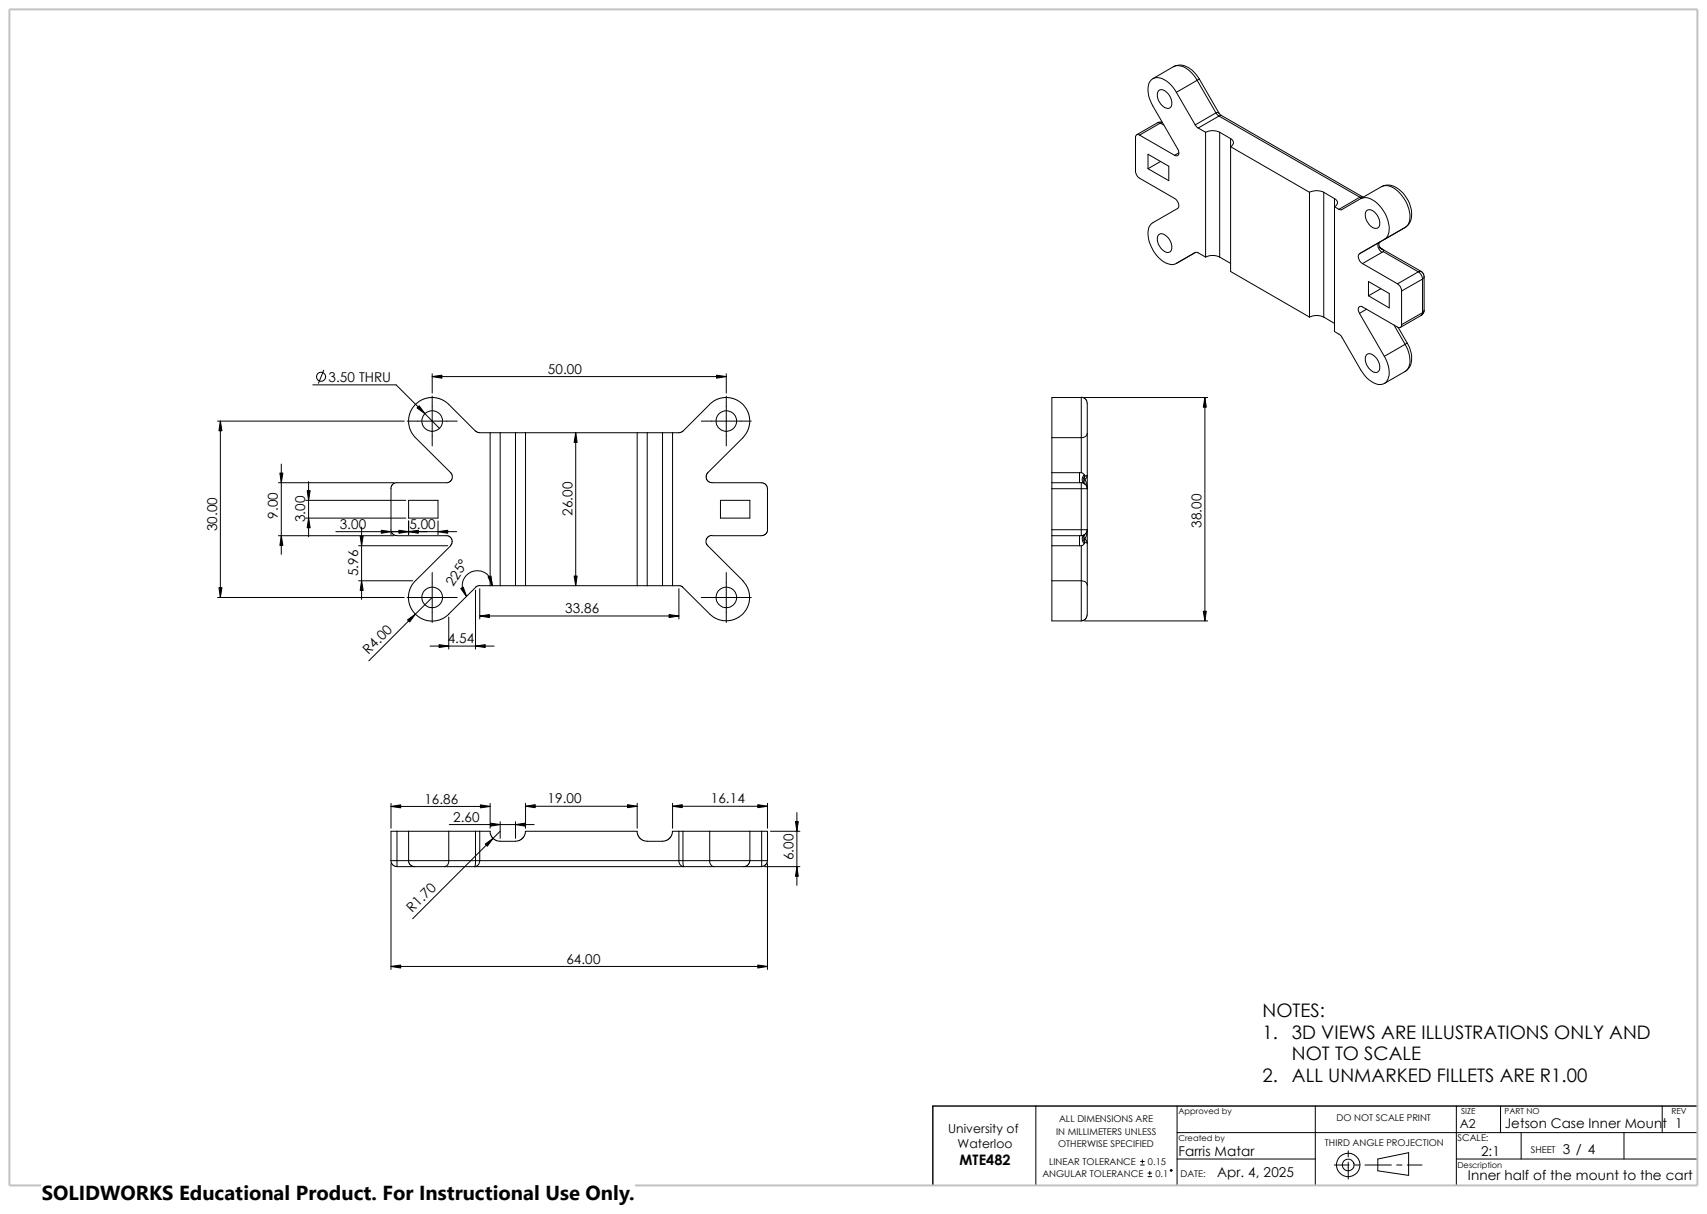
[picture p60: page 3]
50.00 3.50 THRU

2. ALL UNMARKED FILLETS ARE R1.00 ³⁸.00

NOTES:
1. 3D VIEWS ARE ILLUSTRATIONS ONLY AND
NOT TO SCALE

Jetson Case Inner Mount
2:1 | 3 4 /

Inner half of the mount to the cart

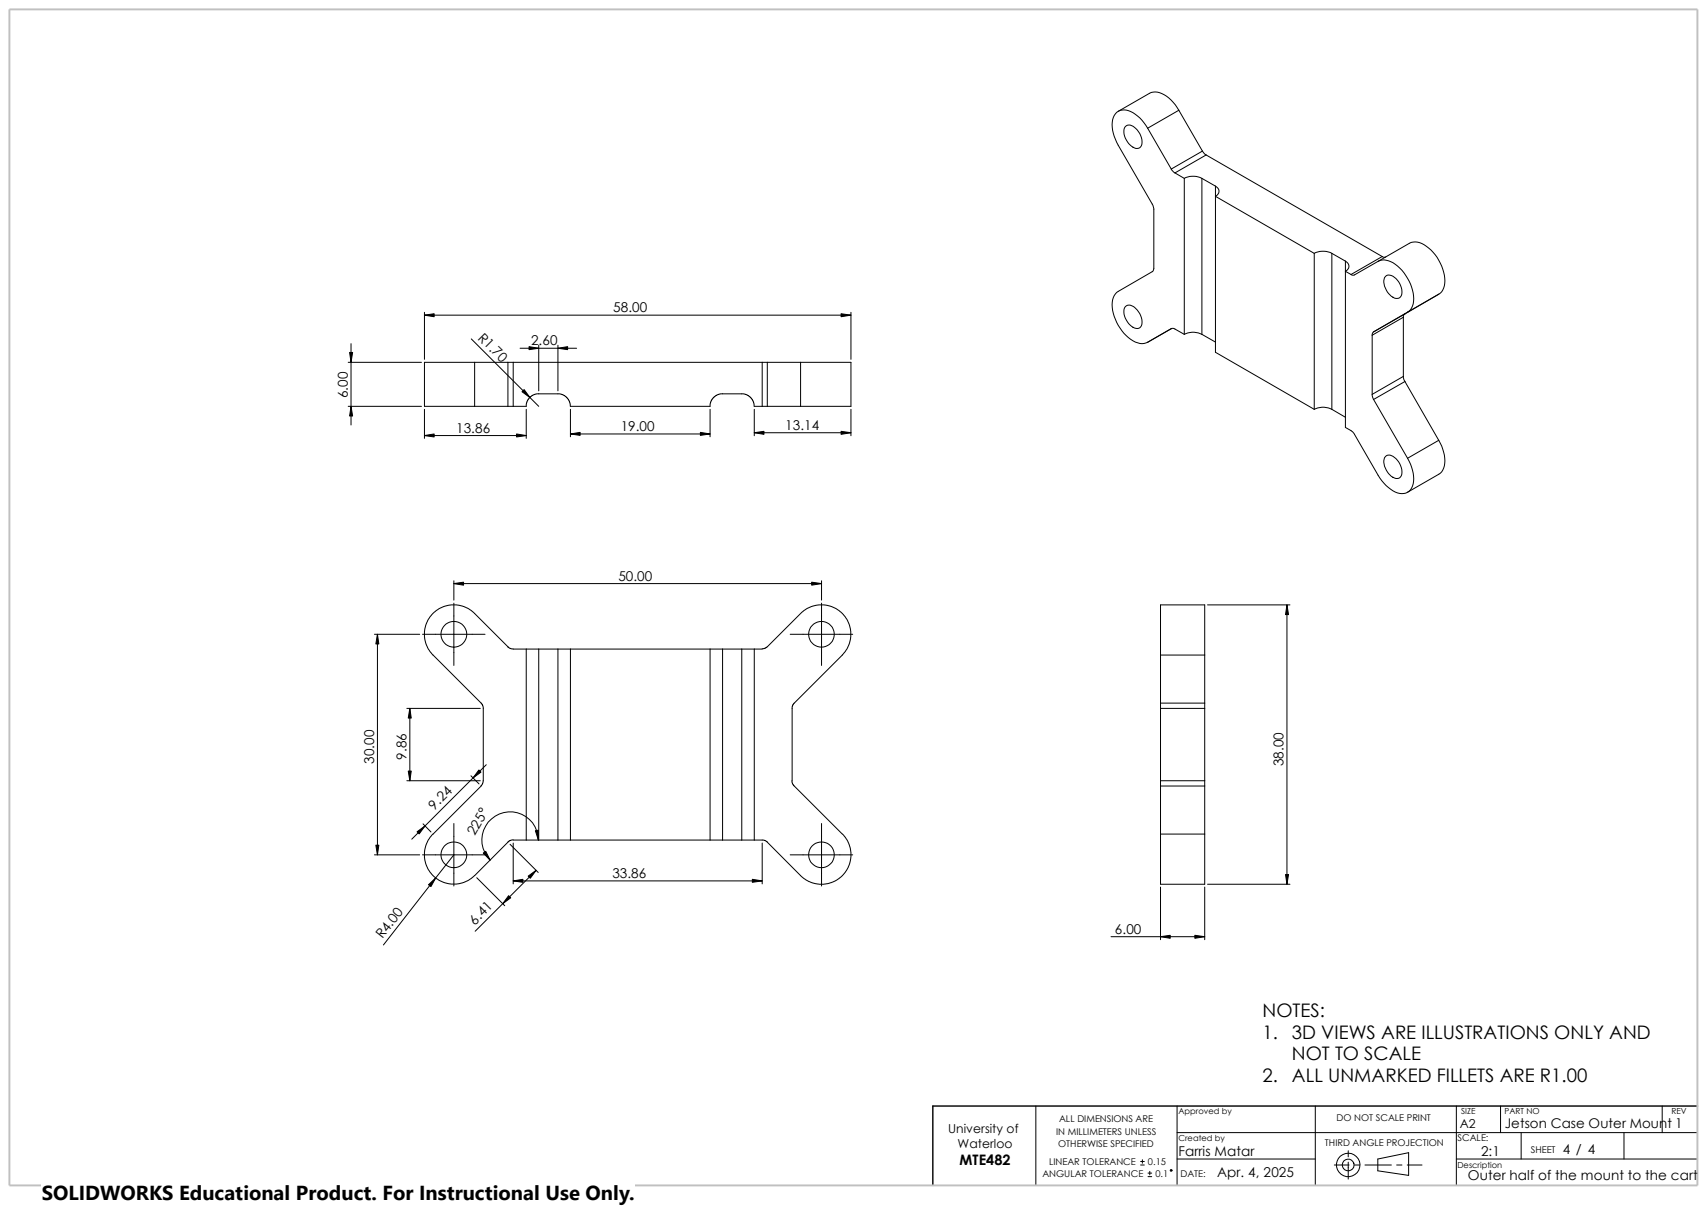
[picture p61: page 4]
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

Jetson Case Outer Mount
2:1 | 4 4 /

Outer half of the mount to the cart
