far-mat42/mte-481-g29/3D Parts and Assemblies/Custom Parts/Drawings/Load Cell ADC Case.pdf

## 2.50 R1.70

2.60

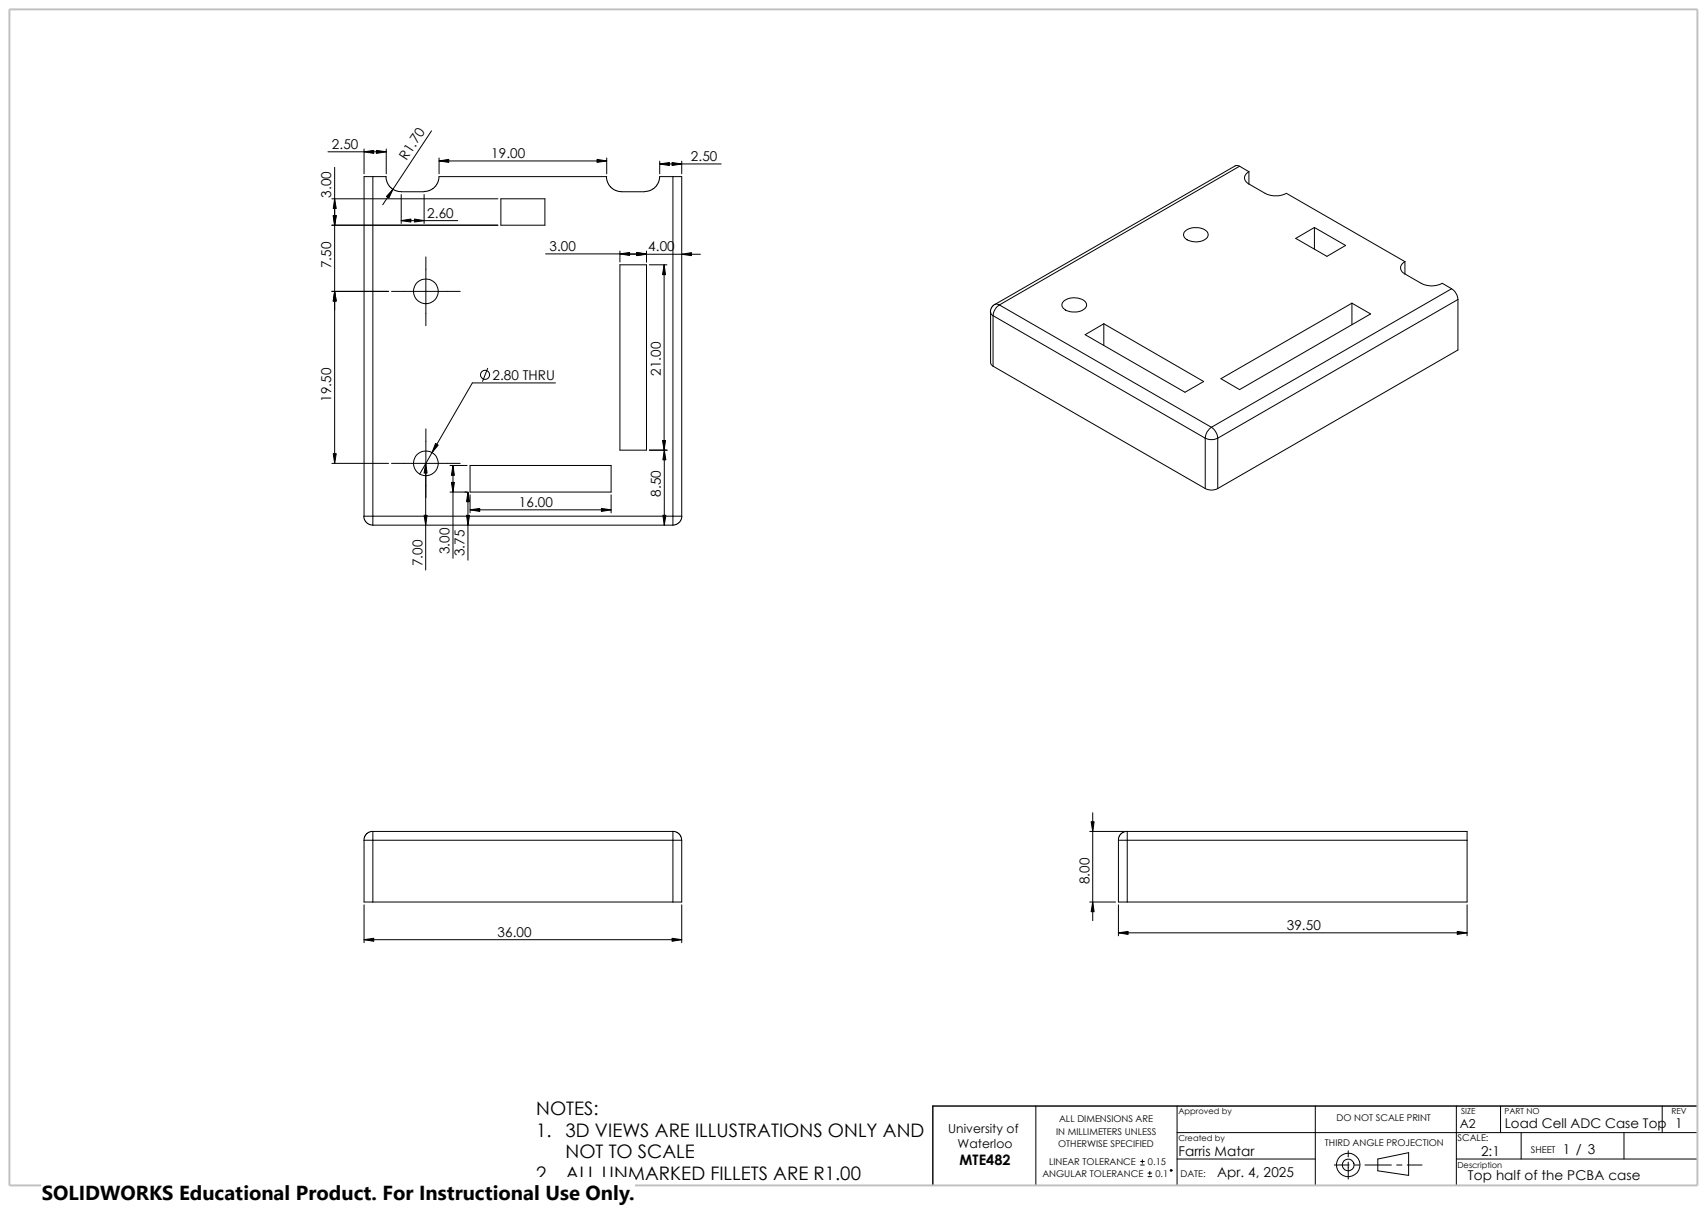
[picture p62: page 1]
DATE:; Apr. 4, 2025; 2.80 THRU

NOTES:
1. 3D VIEWS ARE ILLUSTRATIONS ONLY AND
NOT TO SCALE
2. ALL UNMARKED FILLETS ARE R1.00

University of Waterloo MTE482 | ALL DIMENSIONS ARE IN MILLIMETERS UNLESS OTHERWISE SPECIFIED LINEAR TOLERANCE 0.15 ANGULAR TOLERANCE 0.1 | Approved by | DO NOT SCALE PRINT | SIZE A2 | PART NO Load Cell ADC Case Top | REV 1

Created by Farris Matar | THIRD ANGLE PROJECTION | SCALE: 2:1 | SHEET 1 3 /

Description
Top half of the PCBA case

SOLIDWORKS Educational Product. For Instructional Use Only.

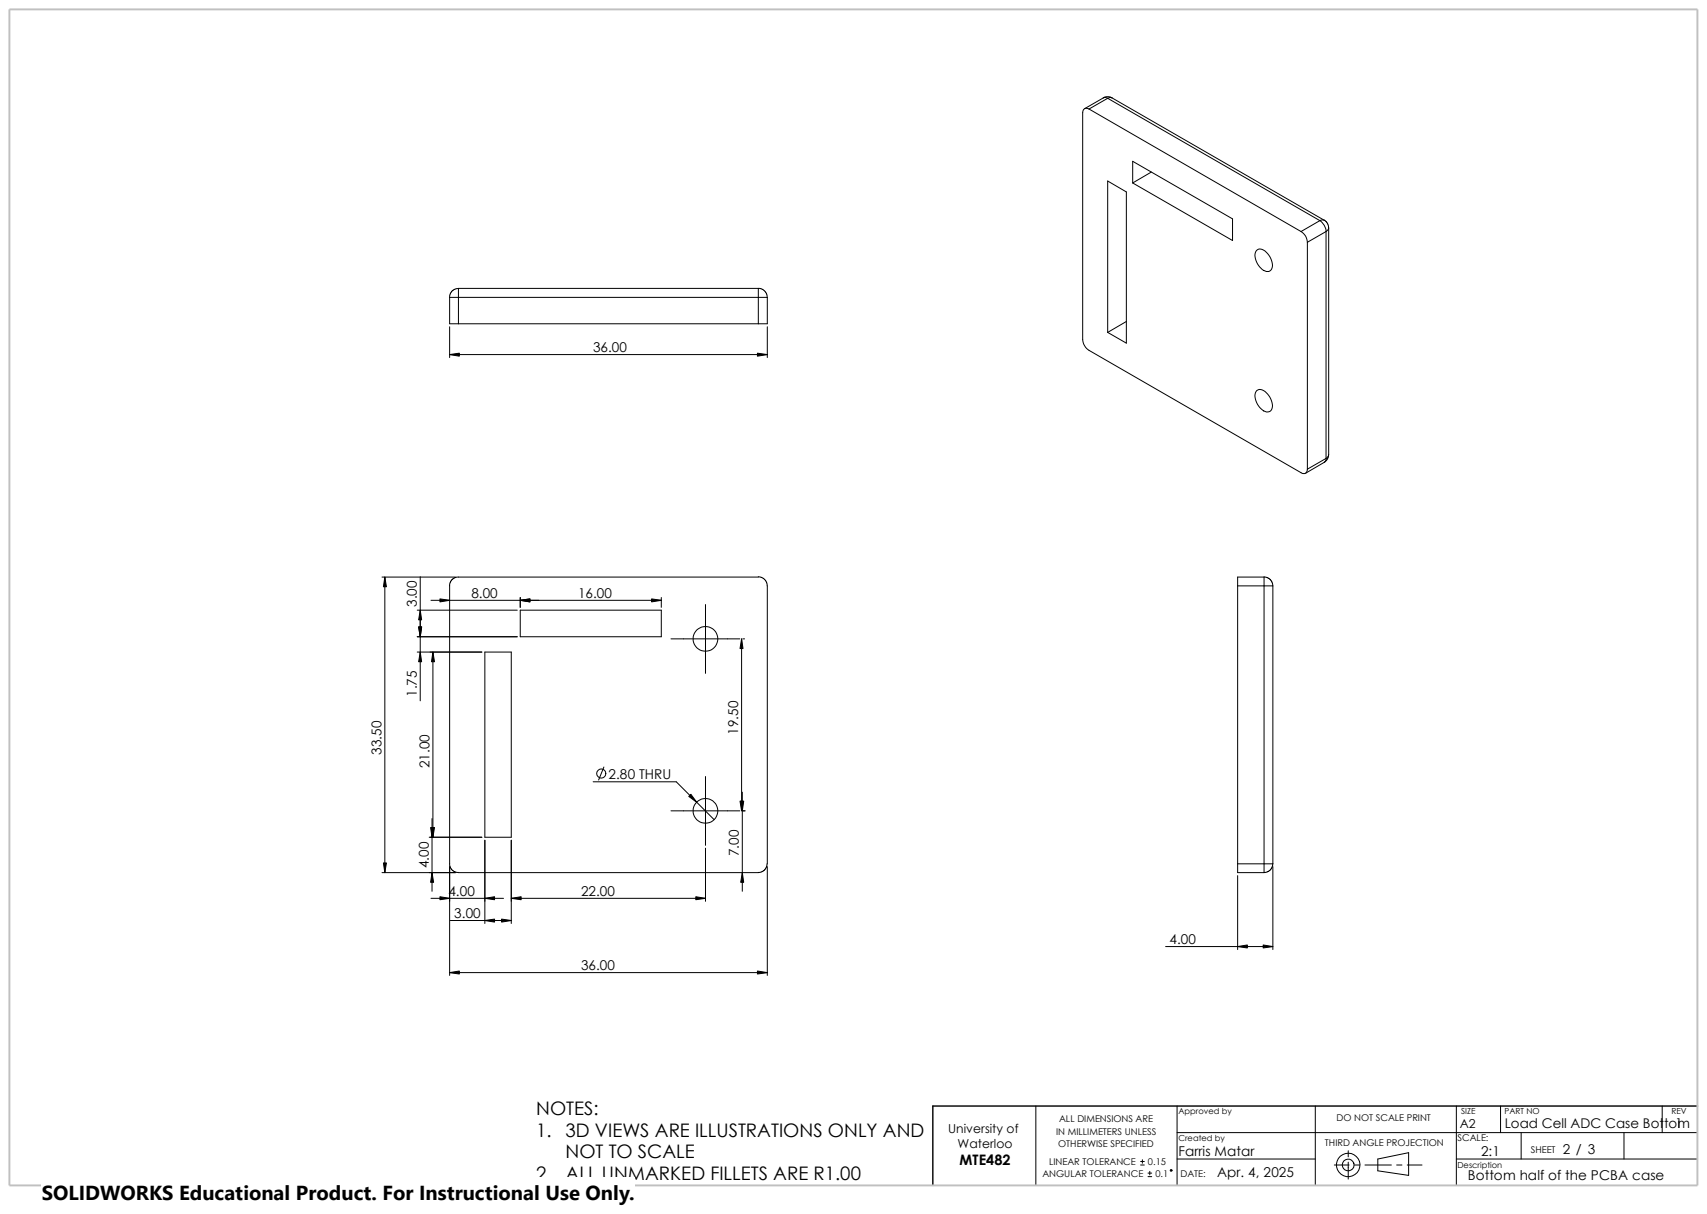
[picture p63: page 2]
NOTES:; 2.80 THRU 4.00 21.00 1.75 3.00

Load Cell ADC Case Bottom | 1
2:1 | 2 3 /

Bottom half of the PCBA case

6.00

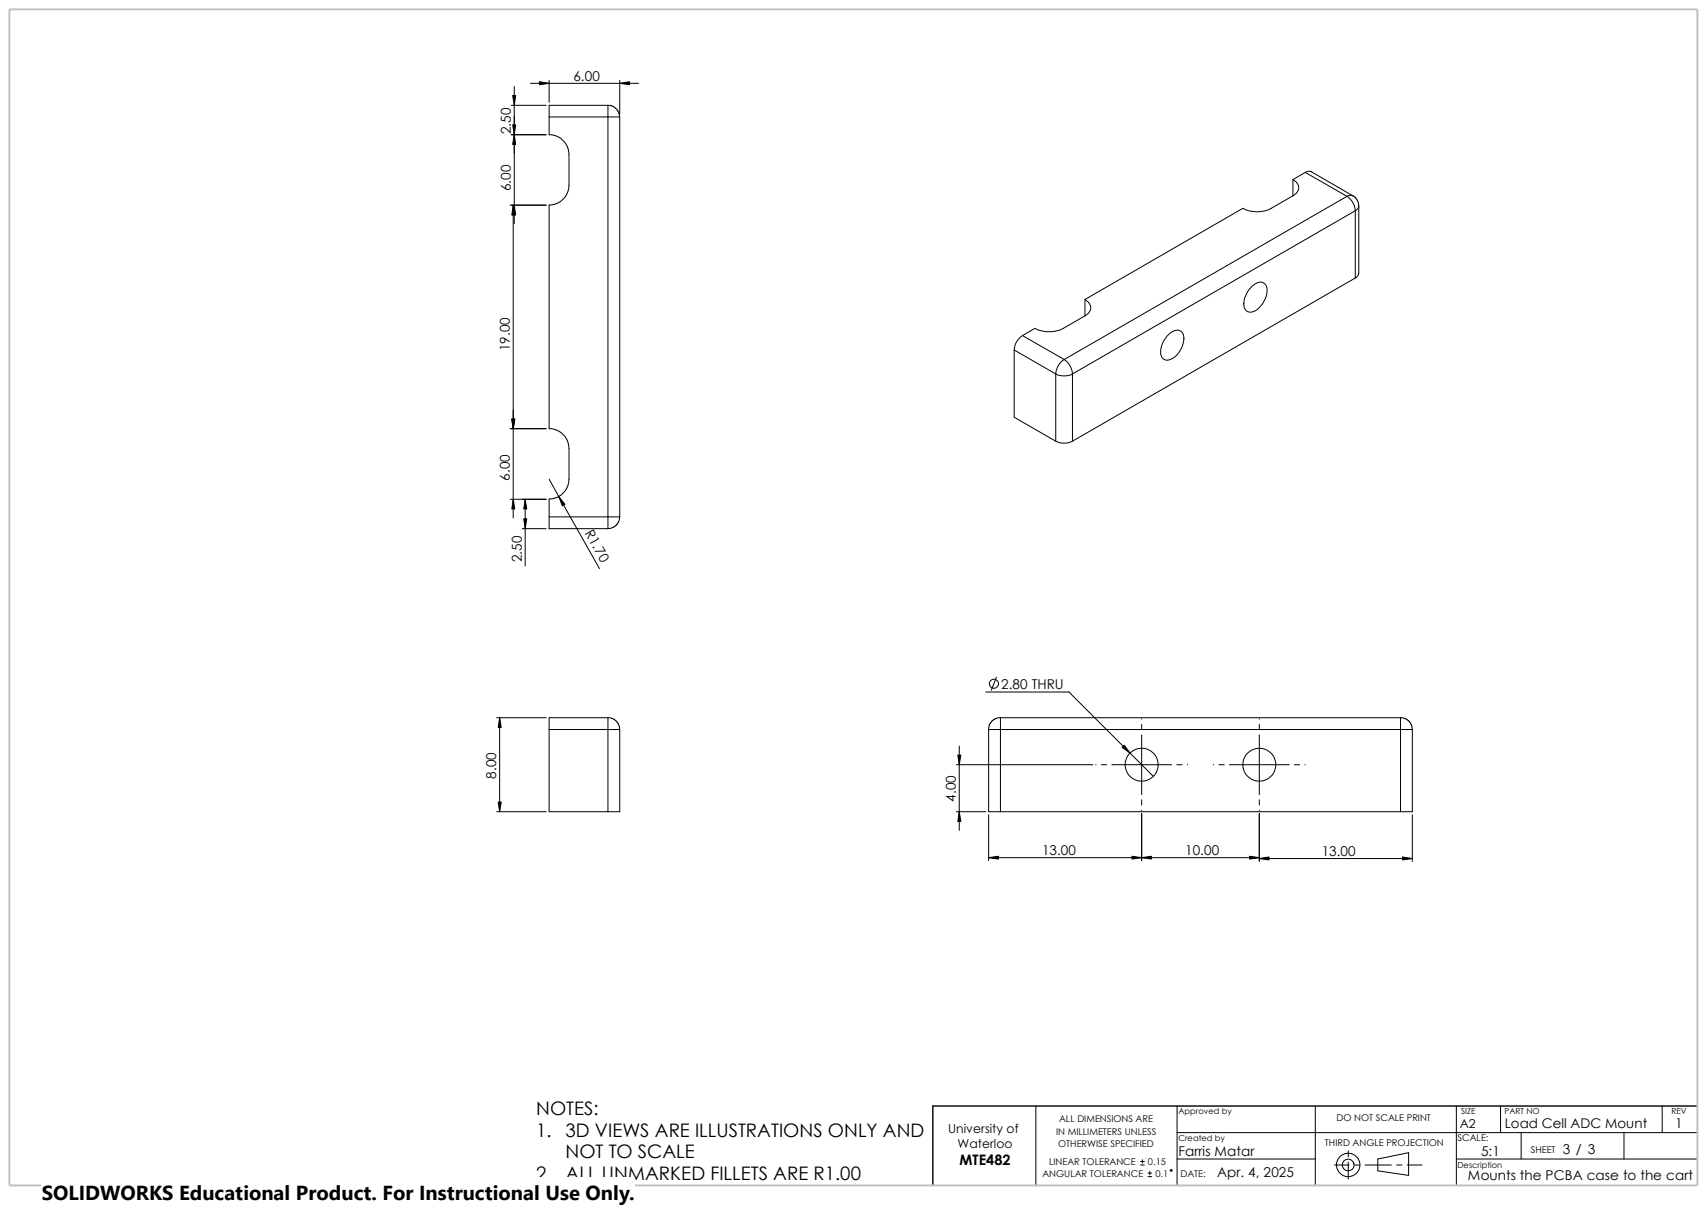
[picture p64: page 3]
NOTES:; 2.80 THRU

Load Cell ADC Mount
5:1 | 3 3 /

Mounts the PCBA case to the cart
