far-mat42/mte-481-g29/3D Parts and Assemblies/Custom Parts/Drawings/Nucleo Case.pdf

# 2. ALL UNMARKED FILLETS ARE R1.00 ⁶.60 9.00

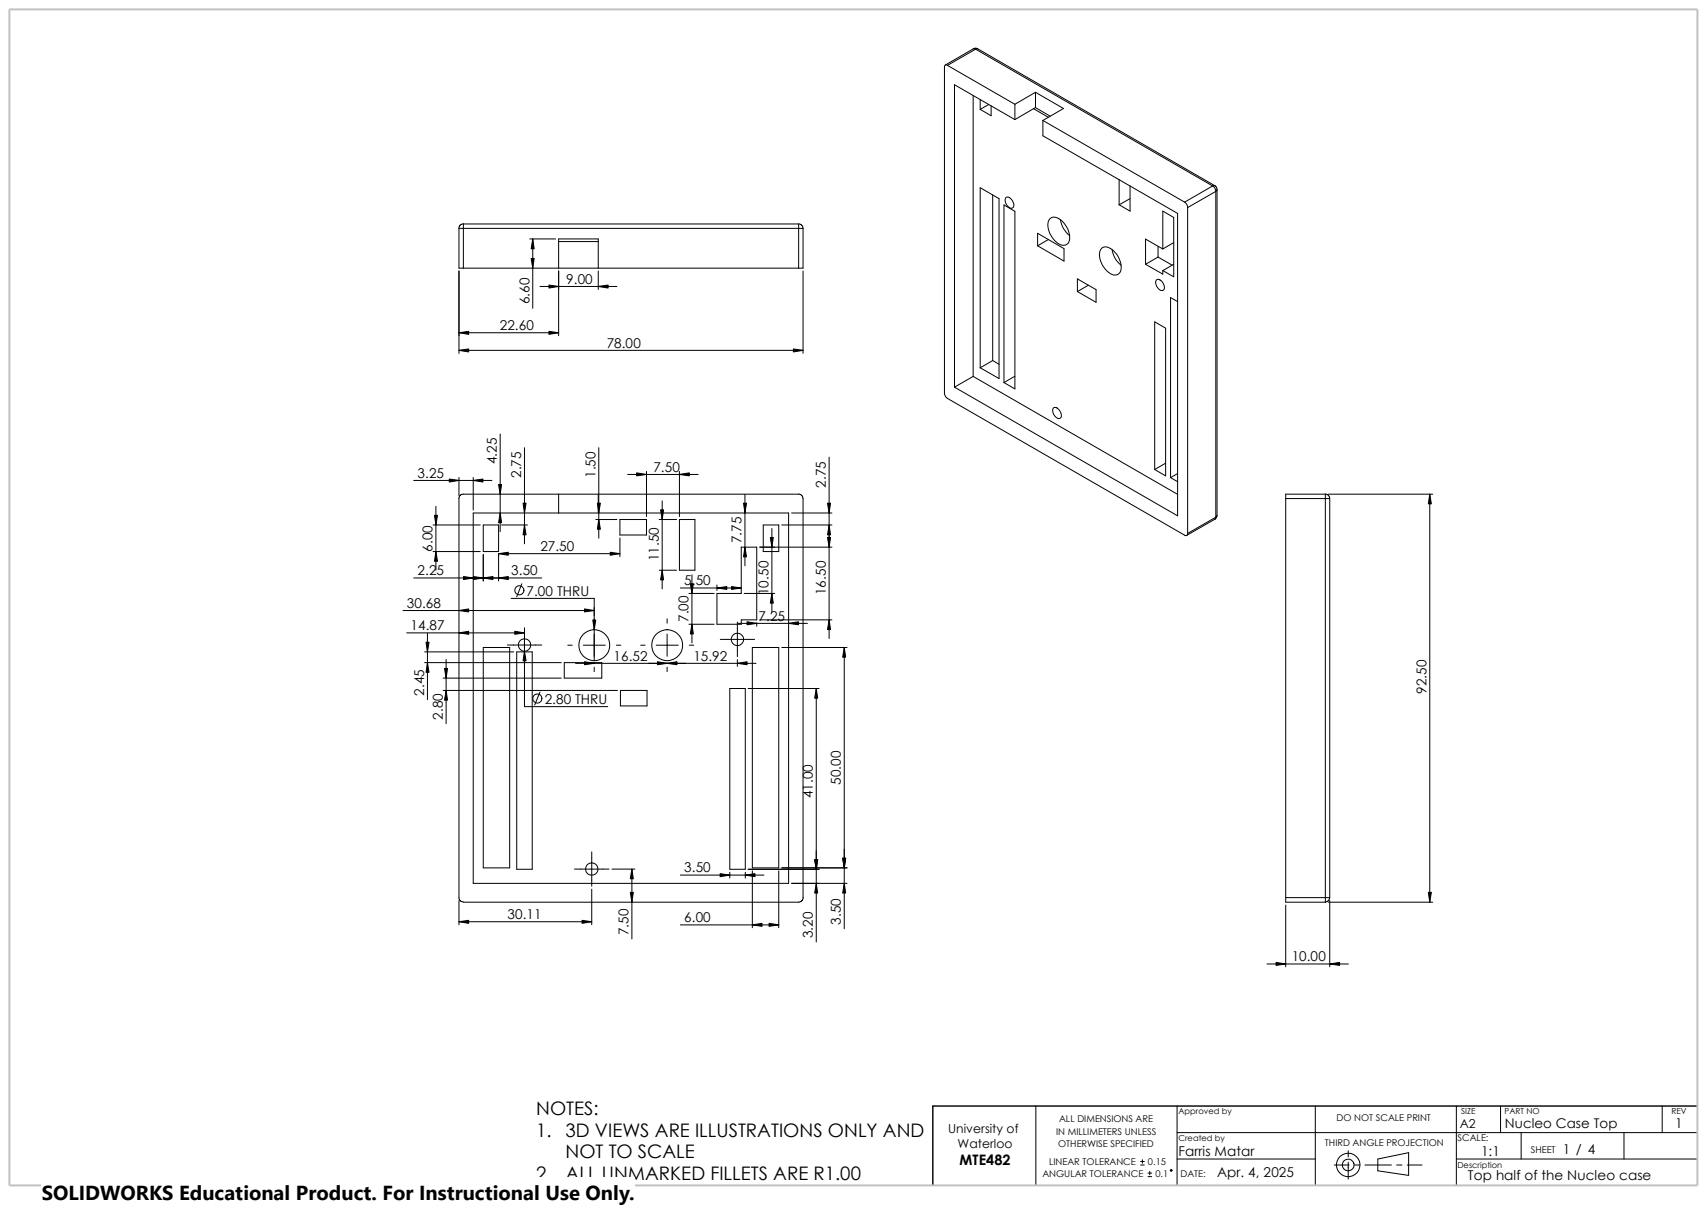
[picture p65: page 1]
DATE:; Apr. 4, 2025; 2.80 THRU; 7.00 THRU

NOTES:
1. 3D VIEWS ARE ILLUSTRATIONS ONLY AND
NOT TO SCALE

University of Waterloo MTE482 | ALL DIMENSIONS ARE IN MILLIMETERS UNLESS OTHERWISE SPECIFIED LINEAR TOLERANCE 0.15 ANGULAR TOLERANCE 0.1 | Approved by | DO NOT SCALE PRINT | SIZE A2 | PART NO Nucleo Case Top | REV

Created by Farris Matar | THIRD ANGLE PROJECTION | SCALE: 1:1 | SHEET 1 4 /

Description
Top half of the Nucleo case

SOLIDWORKS Educational Product. For Instructional Use Only.

## 5.75 ⁶.00

# 3.00 ⁷.00

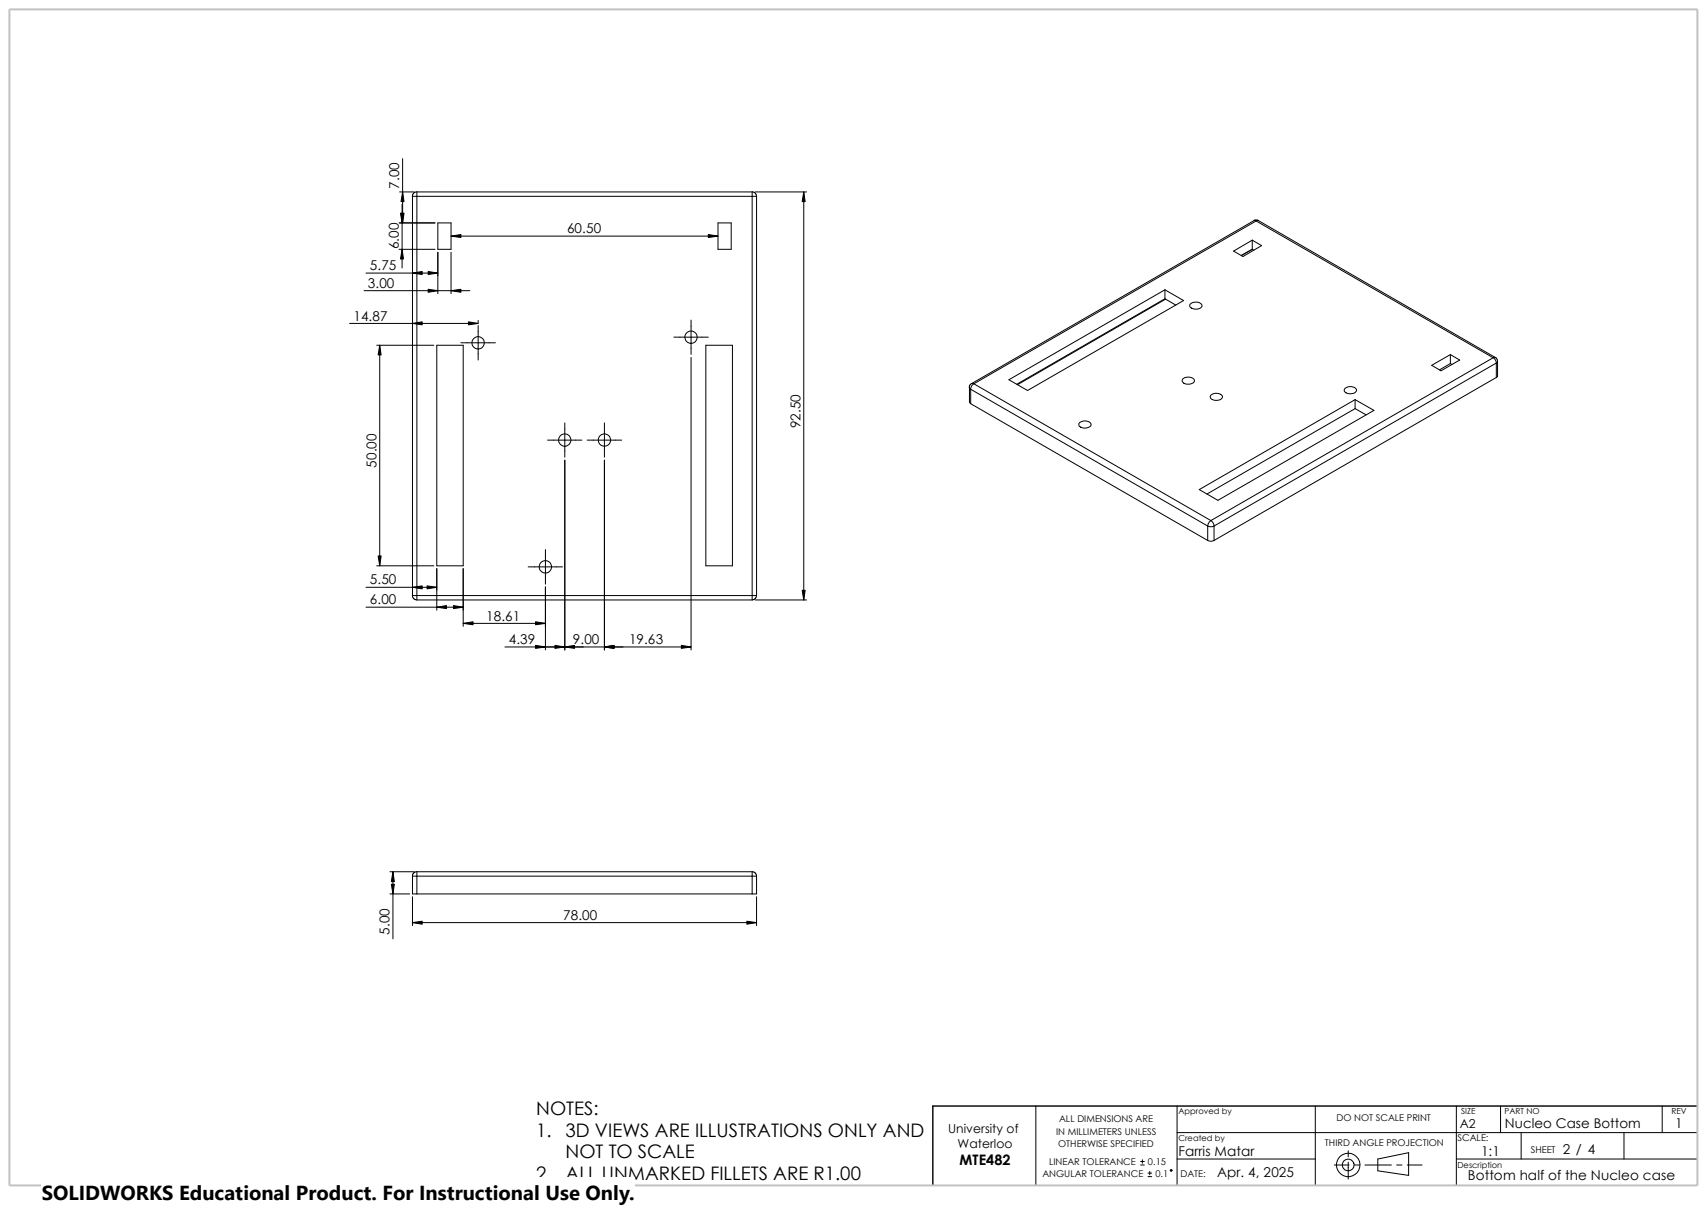
[picture p66: page 2]
NOTES:

2. ALL UNMARKED FILLETS ARE R1.00 ⁵⁰.00

Nucleo Case Bottom | 1
1:1 | 2 4 /

Bottom half of the Nucleo case

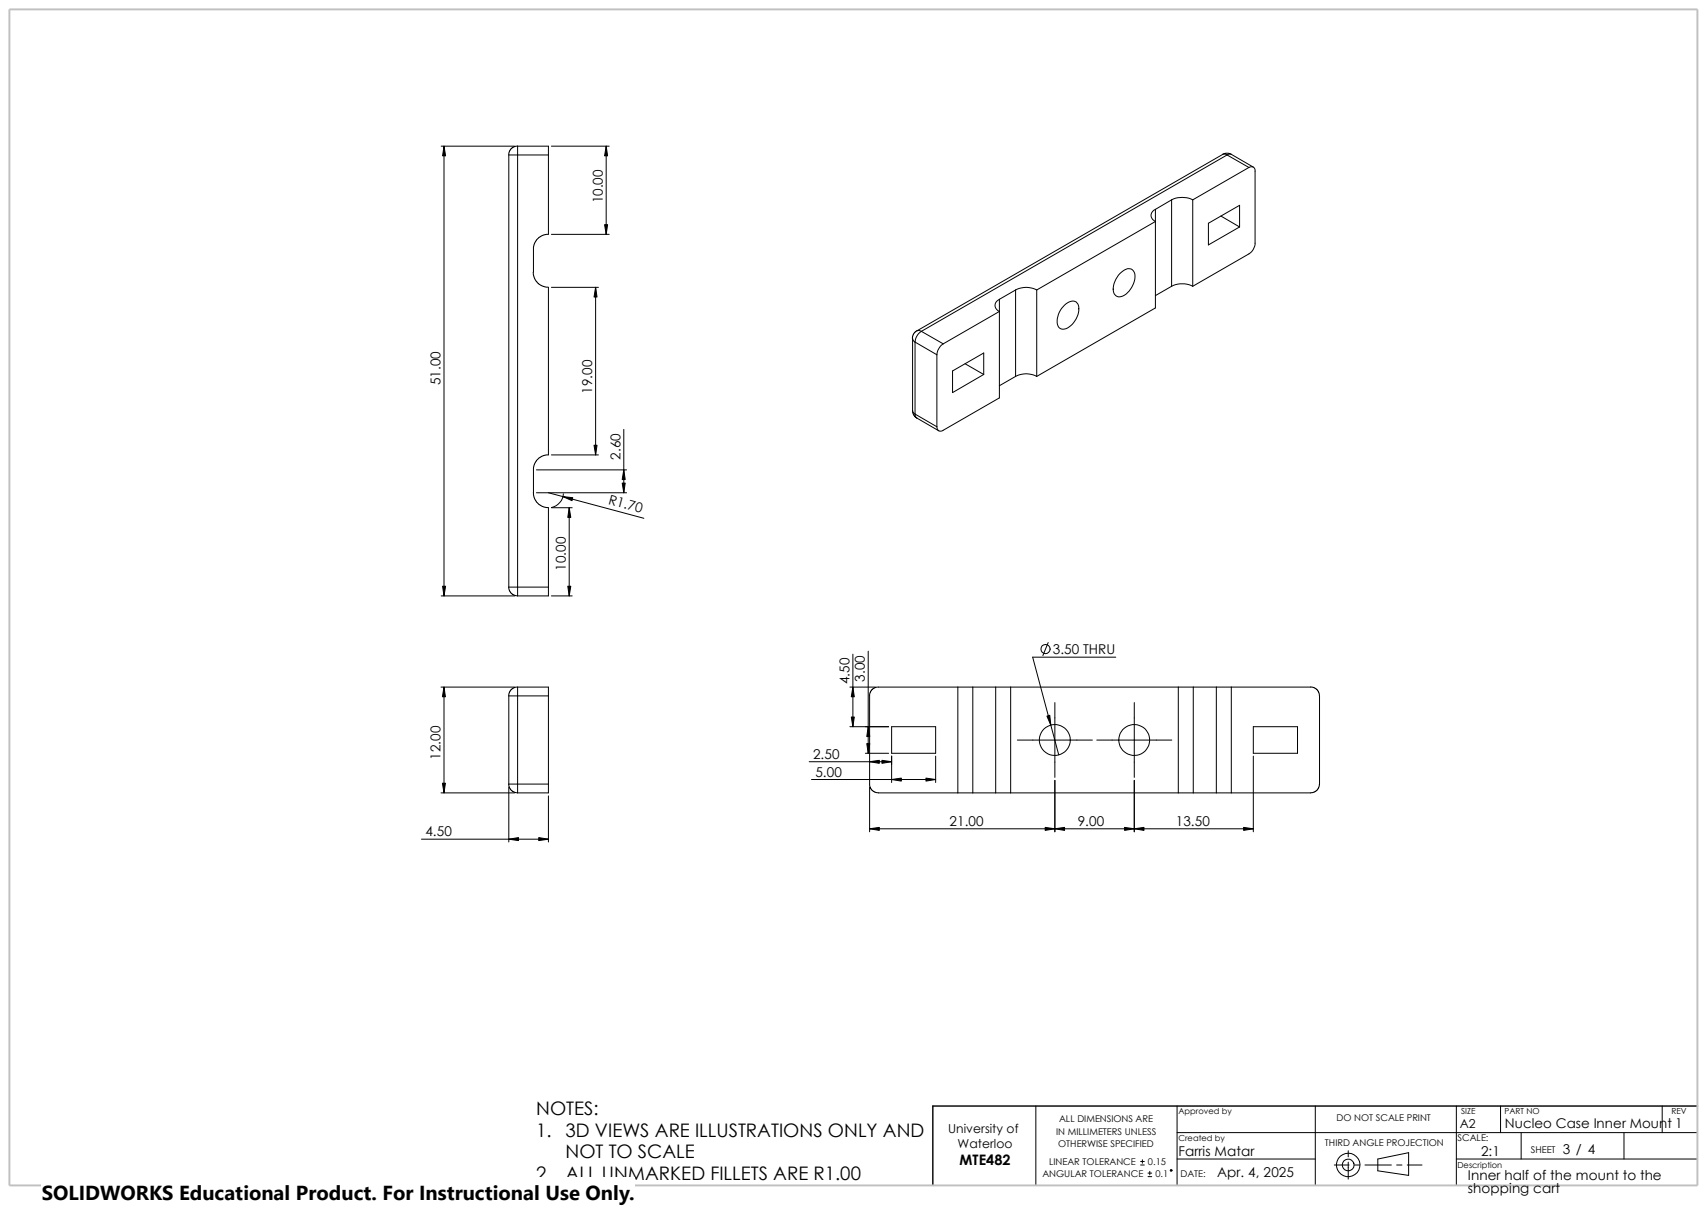
[picture p67: page 3]
3.50 THRU ⁵¹.00; NOTES:

Nucleo Case Inner Mount
2:1 | 3 4 /

2. ALL UNMARKED FILLETS ARE R1.00

Inner half of the mount to the
shopping cart

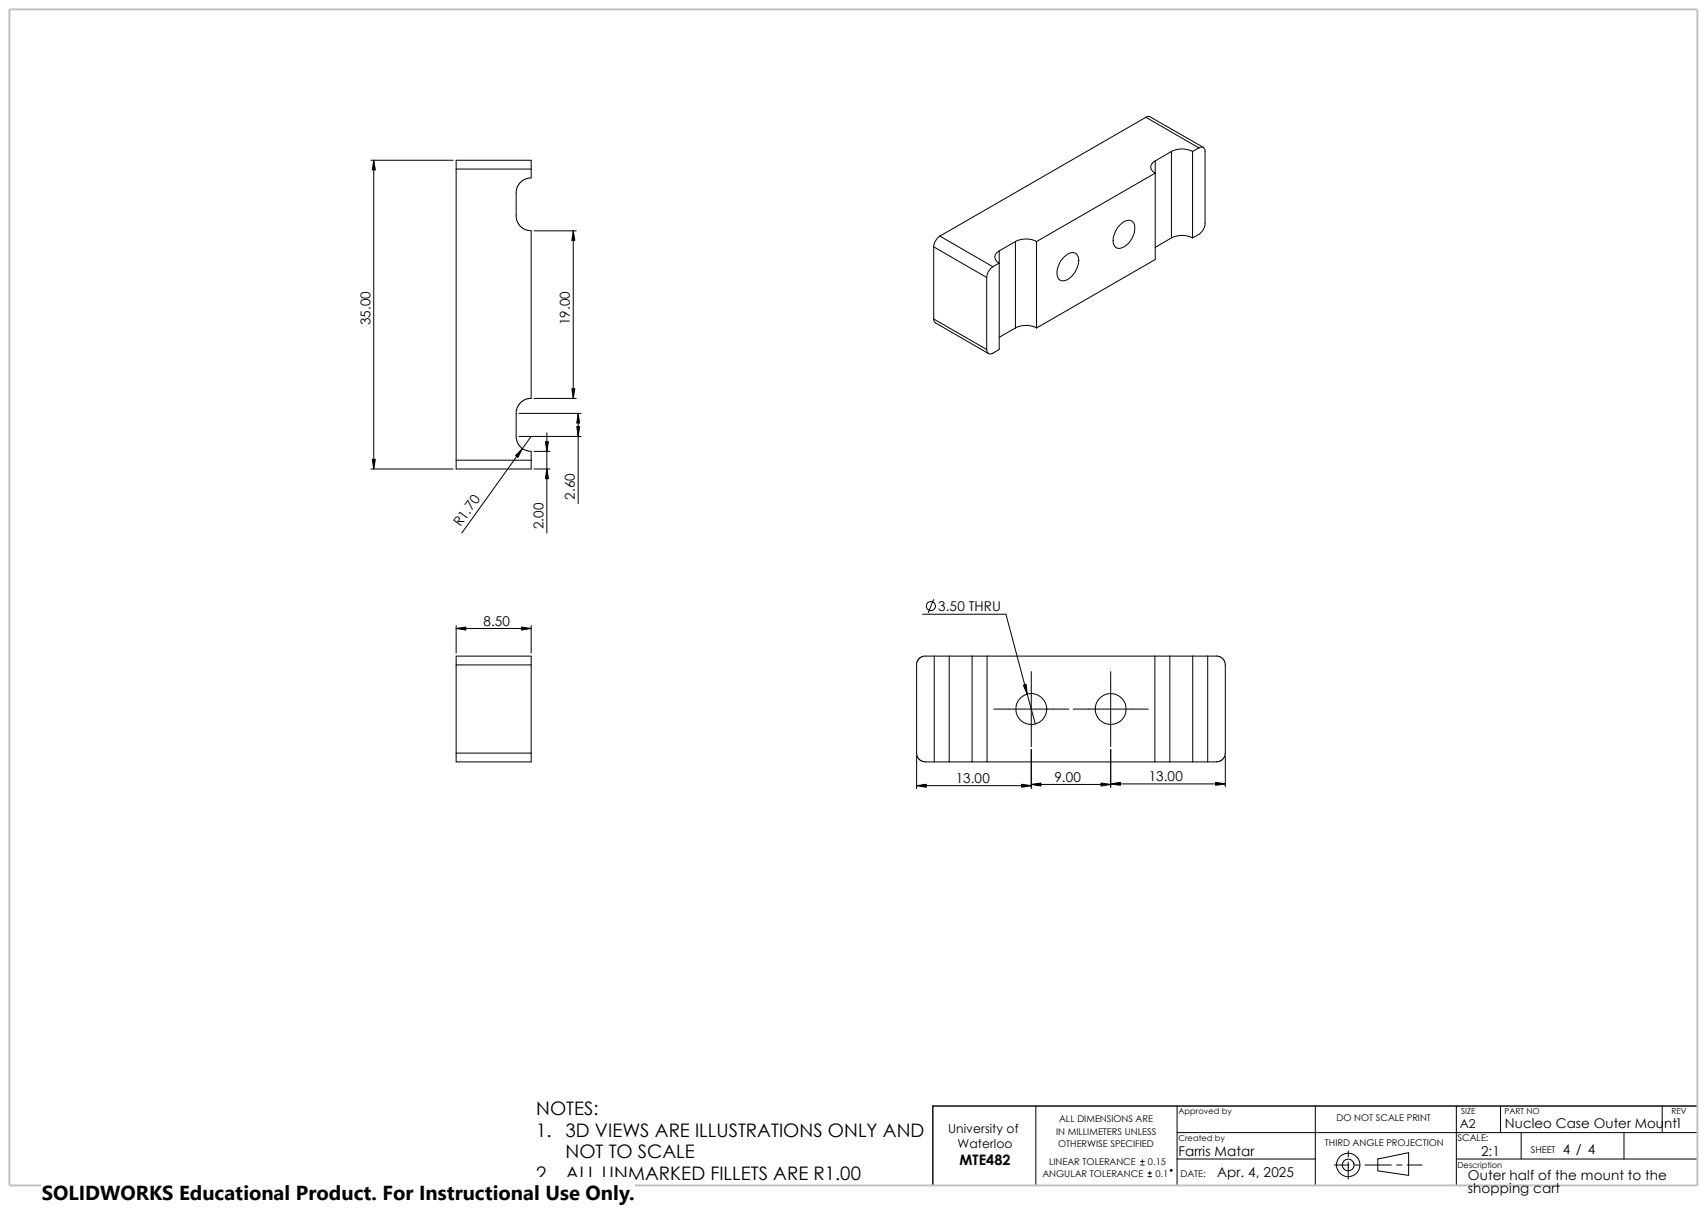
[picture p68: page 4]
NOTES:; 3.50 THRU

Nucleo Case Outer Mount
2:1 | 4 4 /

2. ALL UNMARKED FILLETS ARE R1.00

Outer half of the mount to the
shopping cart
