far-mat42/mte-481-g29/(list of files, drawings)

Other design files:
Custom PCBs/I2C UART Buffer Module/Buffer Module.SchDoc
Custom PCBs/I2C UART Buffer Module/I2C UART Buffer Module.PcbDoc
Custom PCBs/I2C UART Buffer Module/I2C UART Buffer Module.PrjPcb
Custom PCBs/Load Cell ADC Module/ADC Module.SchDoc
Custom PCBs/Load Cell ADC Module/Filter.SchDoc
Custom PCBs/Load Cell ADC Module/Load Cell ADC Module.PcbDoc
Custom PCBs/Load Cell ADC Module/Load Cell ADC Module.PrjPcb
Nucleo PCB Schematic/Connectors.SchDoc
Nucleo PCB Schematic/MB1136.PcbDoc
Nucleo PCB Schematic/MB1136.PrjPCB
Nucleo PCB Schematic/MB1136.SchDoc
Nucleo PCB Schematic/MB1136.SCHLIB
Nucleo PCB Schematic/MCU_64.SchDoc
Nucleo PCB Schematic/ST_LINK_V2-1.SCHDOC
