far-mat42/mte-481-g29/STM32 Nucleo/Auto Shopping Cart/Core/Src/main.c

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
/* Includes ------------------------------------------------------------------*/
#include "main.h"

/* USER CODE BEGIN Includes */
#include <stdio.h>
#include <stdbool.h>
#include "math.h"
#include "string.h"

/* USER CODE END Includes */

/* USER CODE BEGIN PD */
#define ADS1219_ADDR 		0x45 << 1

#define ADS1219_RDATA 		0x10
#define ADS1219_WREG 		0x40
#define ADS1219_STARTSYNC 	0x08

#define WEIGHT_THRESHOLD	0.040

#define TIM1_ARR 			19999

// Servos 1 and 3 on pitch axis, servos 2 and 4 on yaw axis
#define SERVO_DUTY_MIN 		650.0
#define SERVO_DUTY_BW		1700.0
#define SERVO_ANGLE_MAX		180

#define SERVO1_START 		0
#define SERVO1_END			93
#define SERVO1_MAX_SPEED	12

#define SERVO2_START		30
#define SERVO2_END			160
#define SERVO2_SPEED		0.75

#define SERVO3_START 		0
#define SERVO3_END			93
#define SERVO3_MAX_SPEED	12

#define SERVO4_START		30
#define SERVO4_END			160
#define SERVO4_SPEED		0.75

#define FINAL_SWEEP_COUNTS	20

#define MAX_BARCODE_LEN		20
#define MAX_BARCODES		100

/* USER CODE END PD */

I2C_HandleTypeDef hi2c1;

TIM_HandleTypeDef htim1;
TIM_HandleTypeDef htim2;
TIM_HandleTypeDef htim3;

UART_HandleTypeDef huart1;
UART_HandleTypeDef huart2;
UART_HandleTypeDef huart6;

/* USER CODE BEGIN PV */
// Flags for determining which step of the automation process to run
bool servoFlag = false;
bool scannersEnable = false;
bool resetScanners = true;

bool recordWeightFlag = false;
bool scaleEnable = true;

// Placeholder/variables for handling UART transmissions
uint8_t uartRxBuffer[MAX_BARCODES][MAX_BARCODE_LEN] = {0};
uint8_t uartTxBuffer[MAX_BARCODE_LEN + 2] = {0};
uint8_t txLen = 0;
volatile uint8_t barcodeIndex = 0;
volatile uint8_t charIndex = 0;
uint8_t rxChar;

// Local database of known barcodes and their corresponding weights
// In order: Lime juice, cereal box, pasta bag, "milk"
uint8_t codesDatabase[5][MAX_BARCODE_LEN] = {"065912581221", "064100147638", "067800007141", "066800004020"};
uint16_t weightsDatabase[5] = {498, 463, 807, 1904};

/* USER CODE END PV */

void SystemClock_Config(void);
static void MX_GPIO_Init(void);
static void MX_USART2_UART_Init(void);
static void MX_TIM1_Init(void);
static void MX_TIM2_Init(void);
static void MX_I2C1_Init(void);
static void MX_TIM3_Init(void);
static void MX_USART1_UART_Init(void);
static void MX_USART6_UART_Init(void);
/* USER CODE BEGIN PFP */
void SetServoAngle (uint32_t channel, uint8_t angle);
uint8_t inList(uint8_t *string, uint8_t (*strList)[MAX_BARCODE_LEN]);
float max(float a, float b);
uint32_t maxInt(uint32_t a, uint32_t b);

/* USER CODE END PFP */

/* USER CODE BEGIN 0 */
// Redirecting the printf function to print to the console (over UART2)
int _write(int file, char *data, int len) {
    // Redirect printf to UART
    HAL_UART_Transmit(&huart2, (uint8_t*)data, len, HAL_MAX_DELAY);
    return len;
}
/* USER CODE END 0 */

/**
  * @brief  The application entry point.
  * @retval int
  */
int main(void)
{

  /* MCU Configuration--------------------------------------------------------*/

  /* Reset of all peripherals, Initializes the Flash interface and the Systick. */
  HAL_Init();

  /* Configure the system clock */
  SystemClock_Config();

  /* Initialize all configured peripherals */
  MX_GPIO_Init();
  MX_USART2_UART_Init();
  MX_TIM1_Init();
  MX_TIM2_Init();
  MX_I2C1_Init();
  MX_TIM3_Init();
  MX_USART1_UART_Init();
  MX_USART6_UART_Init();
  /* USER CODE BEGIN 2 */
  // Initializing variables for servo motor control
  uint8_t servoAng1 = SERVO1_START;
  uint8_t servoDir1 = 1;
  uint8_t servoSpeed1 = 0;
  float servoSpeedCalc1 = 0;

  float servoAng2 = SERVO2_START;
  uint8_t servoDir2 = 1;

  uint8_t servoAng3 = SERVO3_START;
  uint8_t servoDir3 = 1;
  uint8_t servoSpeed3 = 0;
  float servoSpeedCalc3 = 0;

  float servoAng4 = SERVO2_START;
  uint8_t servoDir4 = 1;

  bool finalSweep = false;
  uint8_t finalSweepCount =  0;

  // Buffers for TX/RX data of I2C bus
  uint8_t txData[3] = {0};
  uint8_t rxData[3] = {0};

  // Variables and arrays for storing load cell readings
  int32_t rawLoadCell1 = 0;
  int32_t rawLoadCell2 = 0;

  int32_t LoadCell1_Offset = 0;
  int32_t LoadCell2_OffsetA = 0;
  int32_t LoadCell2_OffsetB = 0;

  int32_t rawData1[25] = {0};
  int32_t rawData2[25] = {0};
  int32_t avg1 = 0;
  int32_t avg2 = 0;

  float lsbToKg = 0.000256;
  float kilograms = 0;
  float prevKilograms = 0;
  float recordedWeight = 0;
  float totalWeight = 0;
  char weightMsg[20] = {0};

  // Arrays to track barcodes for items currently in the cart and prioritize scanned barcodes
  uint8_t cartCodes[MAX_BARCODES][MAX_BARCODE_LEN] = {0};
  uint8_t cartNumItems = 0;
  uint8_t priorities[MAX_BARCODES] = {0};
  uint8_t sendCodes[MAX_BARCODES] = {0};
  float remainingWeight = 0;
  float itemWeight = 0;
  bool sentCode = false;

  // Configure the ADS1219 to do continuous conversion, start with AIN0/1 load cell, use internal 2.048V reference and 90 SPS data rate
  txData[0] = ADS1219_WREG;
  txData[1] = 0x16;
  HAL_I2C_Master_Transmit(&hi2c1, ADS1219_ADDR, txData, 2, HAL_MAX_DELAY);

  // Send the START/SYNC command to start continuous conversions
  txData[0] = ADS1219_STARTSYNC;
  HAL_I2C_Master_Transmit(&hi2c1, ADS1219_ADDR, txData, 1, HAL_MAX_DELAY);

  // Average 100 measurements to get the offset for each load cell
  for (int i = 0; i < 100; i++) {
	  // Configure ADS1219 MUX to measure AIN0/1 load cell
	  txData[0] = ADS1219_WREG;
	  txData[1] = 0x16;
	  HAL_I2C_Master_Transmit(&hi2c1, ADS1219_ADDR, txData, 2, HAL_MAX_DELAY);
	  // Wait a bit to take the measurements
	  HAL_Delay(15);
	  // Read the measurement and store it
	  txData[0] = ADS1219_RDATA;
	  HAL_I2C_Master_Transmit(&hi2c1, ADS1219_ADDR, txData, 1, HAL_MAX_DELAY);
	  rxData[0] = 0x00;
	  rxData[1] = 0x00;
	  rxData[2] = 0x00;
	  HAL_I2C_Master_Receive(&hi2c1, ADS1219_ADDR, rxData, 3, HAL_MAX_DELAY);
	  rawLoadCell1 = (rxData[0] << 16) | (rxData[1] << 8) | rxData[2];
	  avg1 += rawLoadCell1;

	  // Configure ADS1115 MUX to measure AIN2/3 load cell
	  txData[0] = ADS1219_WREG;
	  txData[1] = 0x36;
	  HAL_I2C_Master_Transmit(&hi2c1, ADS1219_ADDR, txData, 2, HAL_MAX_DELAY);
	  // Wait a bit to take the measurements
	  HAL_Delay(15);
	  // Read the measurement and store it
	  txData[0] = ADS1219_RDATA;
	  HAL_I2C_Master_Transmit(&hi2c1, ADS1219_ADDR, txData, 1, HAL_MAX_DELAY);
	  rxData[0] = 0x00;
	  rxData[1] = 0x00;
	  rxData[2] = 0x00;
	  HAL_I2C_Master_Receive(&hi2c1, ADS1219_ADDR, rxData, 3, HAL_MAX_DELAY);
	  rawLoadCell2 = (rxData[0] << 16) | (rxData[1] << 8) | rxData[2];
	  avg2 += rawLoadCell2;
  }

  avg1 = avg1/100;
  avg2 = avg2/100;
  LoadCell1_Offset = avg1;
  LoadCell2_OffsetA = avg2;
  LoadCell2_OffsetB = avg2;

//  printf("Calculated the following offsets: %ld for cell A, %ld for cell B\r\n", LoadCell1_Offset, LoadCell2_OffsetA);

  // Startup for servo motors
  HAL_TIM_PWM_Start(&htim1, TIM_CHANNEL_1);
  HAL_TIM_PWM_Start(&htim1, TIM_CHANNEL_2);
  HAL_TIM_PWM_Start(&htim1, TIM_CHANNEL_3);
  HAL_TIM_PWM_Start(&htim1, TIM_CHANNEL_4);
  SetServoAngle(TIM_CHANNEL_1, SERVO1_START);
  SetServoAngle(TIM_CHANNEL_2, SERVO2_START);
  SetServoAngle(TIM_CHANNEL_3, SERVO3_START);
  SetServoAngle(TIM_CHANNEL_4, SERVO4_START);
  HAL_Delay(3000);
  HAL_TIM_Base_Start_IT(&htim2);
  HAL_TIM_Base_Start_IT(&htim3);

  /* USER CODE END 2 */

  /* Infinite loop */
  /* USER CODE BEGIN WHILE */
  while (1)
  {
	  // Reset position of barcode scanners if flagged to do so
	  if (resetScanners) {
		  SetServoAngle(TIM_CHANNEL_1, SERVO1_START);
		  SetServoAngle(TIM_CHANNEL_2, SERVO2_START);
		  SetServoAngle(TIM_CHANNEL_3, SERVO3_START);
		  SetServoAngle(TIM_CHANNEL_4, SERVO4_START);

		  servoAng1 = SERVO1_START;
		  servoDir1 = 1;
		  servoSpeed1 = 0;
		  servoSpeedCalc1 = 0;
		  servoAng2 = SERVO2_START;
		  servoDir2 = 1;
		  servoAng3 = SERVO3_START;
		  servoDir1 = 1;
		  servoSpeed3 = 0;
		  servoSpeedCalc3 = 0;
		  servoAng4 = SERVO4_START;
		  servoDir4 = 1;
		  finalSweep = false;
		  finalSweepCount = 0;

		  resetScanners = false;
		  scaleEnable = true;

		  // Disable any reception from barcode scanners over UART
		  HAL_UART_DeInit(&huart1);
		  HAL_UART_DeInit(&huart6);

//		  printf("\nScan complete, resetting scanner position...\r\n");
	  }
	  // Sweep the barcode scanners across the cart
	  if (scannersEnable) {
		  // Update servo positions when timer interrupt flag raised
		  if (servoFlag) {
			  servoFlag = 0;

			  // Servo 1 & 3 (pitch axis): Update speed using a quadratic equation
			  servoSpeedCalc1 = SERVO1_MAX_SPEED*(-0.000395501*servoAng1*servoAng1 + 0.0379681*servoAng1 + 0.0896552);
			  servoSpeed1 = ((uint8_t)servoSpeedCalc1);
			  servoAng1 += servoSpeed1*servoDir1;

			  servoSpeedCalc3 = SERVO3_MAX_SPEED*(-0.000395501*servoAng3*servoAng3 + 0.0379681*servoAng3 + 0.0896552);
			  servoSpeed3 = ((uint8_t)servoSpeedCalc3);
			  servoAng3 += servoSpeed3*servoDir3;
			  // Switch direction if max/min value reached
			  if (servoAng1 >= SERVO1_END) servoDir1 = -1;
			  if (servoAng1 <= SERVO1_START) servoDir1 = 1;
			  if (servoAng3 >= SERVO3_END) servoDir3 = -1;
			  if (servoAng3 <= SERVO3_START) servoDir3 = 1;

			  SetServoAngle(TIM_CHANNEL_1, servoAng1);
			  SetServoAngle(TIM_CHANNEL_3, servoAng3);

			  // Servo 2 & 4 (yaw axis): Increment position by speed value
			  if (servoAng2 <= SERVO2_END) servoAng2 += SERVO2_SPEED*servoDir2;
			  if (servoAng4 <= SERVO4_END) servoAng4 += SERVO4_SPEED*servoDir4;
			  // If max value reached on yaw axis, reset the scanners (sweep is complete) and re-enable the scale
//			  if (servoAng2 >= SERVO2_END || servoAng4 >= SERVO4_END) {
//				  scannersEnable = false;
//				  resetScanners = true;
//			  }
			  // If max value reached on yaw axis, do one final sweep then reset the scanners and re-enable the scale
			  if (servoAng2 >= SERVO2_END || servoAng4 >= SERVO4_END) {
				  finalSweep = true;
			  }
			  if (finalSweep) {
				  finalSweepCount += 1;
			  }
			  if (finalSweepCount >= FINAL_SWEEP_COUNTS) {
				  scannersEnable = false;
				  resetScanners = true;

				  // Output all barcodes received
//				  if (barcodeIndex > 0) {
////					  printf("\nReceived %d barcodes:\r\n", barcodeIndex);
//					  for (int i = 0; i < barcodeIndex; i++) {
//						  for (int j = 0; j < MAX_BARCODE_LEN; j++) {
//							  if (uartRxBuffer[i][j] == '\0') {
//								  txLen = j-1;
//								  break;
//							  }
//							  uartTxBuffer[j] = uartRxBuffer[i][j];
//						  }
//						  HAL_UART_Transmit(&huart2, uartTxBuffer, (txLen + 1), HAL_MAX_DELAY);
//						  HAL_UART_Transmit(&huart2, (uint8_t*)"\r\n", 2, HAL_MAX_DELAY);
//					  }
//					  barcodeIndex = 0;
//				  }
				  // Loop through all scanned barcodes, assign priorities based on likelihood of it being a new item
				  remainingWeight = recordedWeight; // Keep track of remaining weight from measured value
				  for (int i = 0; i < barcodeIndex; i++) {
					  // Priority 1: Item exists in database but is not in cart
					  if (inList(uartRxBuffer[i], codesDatabase) && !inList(uartRxBuffer[i], cartCodes)) {
						  priorities[i] = 1;
						  // Append this item to the end of the list of cart codes
						  strncpy(cartCodes[cartNumItems], uartRxBuffer[i], MAX_BARCODE_LEN);
						  cartNumItems++;
						  // Subtract the weight of this product from the remaining weight
						  remainingWeight -= weightsDatabase[inList(uartRxBuffer[i], codesDatabase) - 1];
					  }
					  // Priority 2 or 3: Item exists in database and 1 or more of that item is in the cart, higher priority to items whose weight exactly matches measured weight (within 5% tolerance)
					  else if (inList(uartRxBuffer[i], codesDatabase) && inList(uartRxBuffer[i], cartCodes)) {
						  itemWeight = weightsDatabase[inList(uartRxBuffer[i], codesDatabase) - 1];
						  if (recordedWeight > (itemWeight - max(1000*WEIGHT_THRESHOLD, 0.05*itemWeight)) && recordedWeight < (itemWeight + max(1000*WEIGHT_THRESHOLD, 0.05*itemWeight))) priorities[i] = 2;
						  else priorities[i] = 3;
					  }
					  // If none of the above apply, reset the priority for this index
					  else priorities[i] = 0;
				  }
				  // Loop through all priorities (lower numbers first) and decide whether or not to send the barcode
				  for (int i = 0; i < barcodeIndex; i++) {
					  if (priorities[i] == 1) {
						  // All priority 1 items are sent no matter what
						  sendCodes[i] = 1;
					  }
				  }
				  for (int i = 0; i < barcodeIndex; i++) {
					  // Only send priority 2 items if the remaining weight is sufficient
					  if (priorities[i] == 2) {
						  itemWeight = weightsDatabase[inList(uartRxBuffer[i], codesDatabase) - 1];
						  if (remainingWeight > (itemWeight + max(1000*WEIGHT_THRESHOLD, itemWeight*0.05))) {
							  sendCodes[i] = 1;
							  // Append this item to the end of the list of cart codes
							  strncpy(cartCodes[cartNumItems], uartRxBuffer[i], MAX_BARCODE_LEN);
							  cartNumItems++;
							  // Subtract the weight of this product from the remaining weight
							  remainingWeight -= itemWeight;
						  }
					  }
				  }
				  for (int i = 0; i < barcodeIndex; i++) {
					  // Only send priority 3 items if the remaining weight is sufficient
					  if (priorities[i] == 3) {
						  itemWeight = weightsDatabase[inList(uartRxBuffer[i], codesDatabase) - 1];
						  if (remainingWeight > (itemWeight + max(1000*WEIGHT_THRESHOLD, itemWeight*0.05))) {
							  sendCodes[i] = 1;
							  // Append this item to the end of the list of cart codes
							  strncpy(cartCodes[cartNumItems], uartRxBuffer[i], MAX_BARCODE_LEN);
							  cartNumItems++;
							  // Subtract the weight of this product from the remaining weight
							  remainingWeight -= itemWeight;
						  }
					  }
				  }

				  // Transmit all the codes flagged to be sent to the ESP32
				  sentCode = false;
				  for (int i = 0; i < barcodeIndex; i++) {
					  if (sendCodes[i] == 1) {
						  // Flag that a code was sent
						  sentCode = true;
						  // Transmit start of barcode character
						  HAL_UART_Transmit(&huart2, (uint8_t*)"C", 1, HAL_MAX_DELAY);
						  for (int j = 0; j < MAX_BARCODE_LEN; j++) {
							  uartTxBuffer[j] = uartRxBuffer[i][j];
							  if (uartRxBuffer[i][j] == '\0') {
								  txLen = j;
								  break;
							  }
						  }
						  HAL_UART_Transmit(&huart2, uartTxBuffer, (txLen + 1), HAL_MAX_DELAY);
					  }
				  }
				  // Send a dummy barcode in the event where no barcodes were found
//				  if (barcodeIndex == 0) HAL_UART_Transmit(&huart2, (uint8_t*)"C000000000000\0", 14, HAL_MAX_DELAY);
				  // Transmit end of transmission character (only if something was scanned)
				  if (sentCode) HAL_UART_Transmit(&huart2, (uint8_t*)"\r", 1, HAL_MAX_DELAY);

				  barcodeIndex = 0; // Reset barcode index
			  }

			  SetServoAngle(TIM_CHANNEL_2, servoAng2);
			  SetServoAngle(TIM_CHANNEL_4, servoAng4);
		  }
	  }
	  // Average 25 measurements (over approx. 1 second) to get the reading from each load cell.
	  if (scaleEnable) {
		  prevKilograms = kilograms;
		  HAL_Delay(100);
		  for (int i = 0; i < 25; i++) {
			  // Configure ADS1219 MUX to measure AIN0/1 load cell
			  txData[0] = ADS1219_WREG;
			  txData[1] = 0x16;
			  HAL_I2C_Master_Transmit(&hi2c1, ADS1219_ADDR, txData, 2, HAL_MAX_DELAY);
			  // Wait a bit to take the measurements
			  HAL_Delay(15);
			  // Read the measurement and store it
			  txData[0] = ADS1219_RDATA;
			  HAL_I2C_Master_Transmit(&hi2c1, ADS1219_ADDR, txData, 1, HAL_MAX_DELAY);
			  rxData[0] = 0x00;
			  rxData[1] = 0x00;
			  rxData[2] = 0x00;
			  HAL_I2C_Master_Receive(&hi2c1, ADS1219_ADDR, rxData, 3, HAL_MAX_DELAY);
			  rawLoadCell1 = (rxData[0] << 16) | (rxData[1] << 8) | rxData[2];
			  rawData1[i] = rawLoadCell1 - LoadCell1_Offset;

			  // Configure ADS1115 MUX to measure AIN2/3 load cell
			  txData[0] = ADS1219_WREG;
			  txData[1] = 0x36;
			  HAL_I2C_Master_Transmit(&hi2c1, ADS1219_ADDR, txData, 2, HAL_MAX_DELAY);
			  // Wait a bit to take the measurements
			  HAL_Delay(15);
			  // Read the measurement and store it
			  txData[0] = ADS1219_RDATA;
			  HAL_I2C_Master_Transmit(&hi2c1, ADS1219_ADDR, txData, 1, HAL_MAX_DELAY);
			  rxData[0] = 0x00;
			  rxData[1] = 0x00;
			  rxData[2] = 0x00;
			  HAL_I2C_Master_Receive(&hi2c1, ADS1219_ADDR, rxData, 3, HAL_MAX_DELAY);
			  rawLoadCell2 = (rxData[0] << 16) | (rxData[1] << 8) | rxData[2];
			  // Applying offset on load cell B based on if it overflowed or not
			  if (rawLoadCell2 > 16700000) rawData2[i] = rawLoadCell2 - LoadCell2_OffsetA;
			  else rawData2[i] = rawLoadCell2 - LoadCell2_OffsetB;
		  }
		  avg1 = 0;
		  avg2 = 0;
		  for (int i = 0; i < 25; i++) {
			  avg1 += rawData1[i];
			  avg2 += rawData2[i];
		  }
		  avg1 = avg1/-25;
		  avg2 = avg2/25; // Load cell B is mounted in opposite direction, so sign is flipped to get the same sign when summing both
		  kilograms = (avg1 + avg2)*lsbToKg;
//		  printf("\nMeasured weight of %.5f kilograms\r\n", kilograms);

		  // Save the weight if required
		  if (recordWeightFlag == true) {
			  recordedWeight = kilograms;
			  totalWeight += recordedWeight;
			  // Stop the scale and start the barcode scanners
			  scannersEnable = true;
			  scaleEnable = false;
			  recordWeightFlag = false;
//			  printf("Weight of product added to cart: %.5f kilograms\r\nTotal cart weight: %.5f\r\n", recordedWeight, totalWeight);
			  // Send weight information to ESP32
//			  printf("W%.3f\0\r", recordedWeight);
			  snprintf(weightMsg, sizeof(weightMsg), "W%.3f", recordedWeight);
			  HAL_UART_Transmit(&huart2, (uint8_t*)weightMsg, strlen(weightMsg), HAL_MAX_DELAY);
			  // Transmit end of transmission character
			  HAL_UART_Transmit(&huart2, (uint8_t*)"\r", 1, HAL_MAX_DELAY);

			  // Re-initialize and begin receiving from both UART channels
			  HAL_UART_Init(&huart1);
			  HAL_UART_Init(&huart6);
			  HAL_UART_Receive_IT(&huart1, &rxChar, 1);
			  HAL_UART_Receive_IT(&huart6, &rxChar, 1);
		  }

		  // Check if current weight is greater than previous weight by the established threshold (25g)
		  if (kilograms > (totalWeight + WEIGHT_THRESHOLD) && recordWeightFlag == false) {
			  recordWeightFlag = true;
		  }
	  }

    /* USER CODE END WHILE */

    /* USER CODE BEGIN 3 */
  }
  /* USER CODE END 3 */
}

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
/* USER CODE BEGIN 4 */
/**
 * Function to set the angle of a servo motor by calculating and setting the required PWM duty cycle
 * @param channel Which PWM channel to set (i.e. which servo motor to set the angle for)
 * @param angle Angle (between 0º and 180º) to set the servo motor to
 */
void SetServoAngle (uint32_t channel, uint8_t angle) {
	if (angle >= SERVO_ANGLE_MAX) angle = SERVO_ANGLE_MAX;
	uint16_t dutyCycle = ((double)angle / 180.0)*SERVO_DUTY_BW + SERVO_DUTY_MIN;

	switch(channel) {
		case TIM_CHANNEL_1:
			__HAL_TIM_SET_COMPARE(&htim1, TIM_CHANNEL_1, dutyCycle);
			break;
		case TIM_CHANNEL_2:
			__HAL_TIM_SET_COMPARE(&htim1, TIM_CHANNEL_2, dutyCycle);
			break;
		case TIM_CHANNEL_3:
			__HAL_TIM_SET_COMPARE(&htim1, TIM_CHANNEL_3, dutyCycle);
		case TIM_CHANNEL_4:
			__HAL_TIM_SET_COMPARE(&htim1, TIM_CHANNEL_4, dutyCycle);
		default:
			break;
	}
}

/**
 * Function to check if a string exists in a list of strings
 * @param string String to look for in the list
 * @param strList List of strings to check
 * @retval Position where item was found (0 if not found) (not to be confused with index)
 */
uint8_t inList(uint8_t *string, uint8_t (*strList)[MAX_BARCODE_LEN]) {
	for (int i = 0; i < sizeof(strList); i++) {
		if (strcmp(string, strList[i]) == 0) return i+1;
	}
	return false;
}

uint32_t maxInt(uint32_t a, uint32_t b) {
    if (a > b) return a;
    return b;
}

float max(float a, float b) {
    if (a > b) return a;
    return b;
}

void TIM2_IRQHandler(void) {
  servoFlag = 1;
  HAL_TIM_IRQHandler(&htim2);
}

void TIM3_IRQHandler(void) {
  HAL_TIM_IRQHandler(&htim3);
}

void HAL_UART_RxCpltCallback(UART_HandleTypeDef *huart) {
    if (huart->Instance == USART1) {  // Check if it's USART1
        if (rxChar == '\n' || rxChar == '\r') {  // End of message determined by newline or return
            uartRxBuffer[barcodeIndex][charIndex] = '\0';  // Null-terminate the message
            barcodeIndex++;  // Move to the next barcode slot
            charIndex = 0;  // Reset character index

            if (barcodeIndex >= MAX_BARCODES) {  // Prevent buffer overflow
                barcodeIndex = 0;  // Overwrite old messages (circular buffer)
            }
        } else {  // Store character
            if (charIndex < MAX_BARCODE_LEN - 1) {  // Prevent overflow
                uartRxBuffer[barcodeIndex][charIndex++] = rxChar;
            }
        }

        // Restart reception for the next character
        HAL_UART_Receive_IT(&huart1, &rxChar, 1);
    }
    if (huart->Instance == USART6) {  // Check if it's USART6
        if (rxChar == '\n' || rxChar == '\r') {  // End of message determined by newline or return
        	uartRxBuffer[barcodeIndex][charIndex] = '\0';  // Null-terminate the message
            barcodeIndex++;  // Move to the next barcode slot
            charIndex = 0;  // Reset character index

            if (barcodeIndex >= MAX_BARCODES) {  // Prevent buffer overflow
                barcodeIndex = 0;  // Overwrite old messages (circular buffer)
            }
        } else {  // Store character
            if (charIndex < MAX_BARCODE_LEN - 1) {  // Prevent overflow
            	uartRxBuffer[barcodeIndex][charIndex++] = rxChar;
            }
        }

        // Restart reception for the next character
        HAL_UART_Receive_IT(&huart6, &rxChar, 1);
    }
}

/* USER CODE END 4 */
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
