far-mat42/mte-481-g29/STM32 Nucleo/Auto Shopping Cart/Auto Shopping Cart.ioc

Mcu.UserName=STM32F401RETx
PA10.Signal=S_TIM1_CH3
PA11.Signal=S_TIM1_CH4
PA13.GPIO_Label=TMS
PA13.Signal=SYS_JTMS-SWDIO
PA14.GPIO_Label=TCK
PA14.Signal=SYS_JTCK-SWCLK
PA2.GPIO_Label=USART_TX
PA2.Signal=USART2_TX
PA3.GPIO_Label=USART_RX
PA3.Signal=USART2_RX
PA5.GPIO_Label=LD2 [Green Led]
PA5.Signal=GPIO_Output
PA8.Signal=S_TIM1_CH1
PA9.Signal=S_TIM1_CH2
PB3.GPIO_Label=SWO
PB3.Signal=SYS_JTDO-SWO
PB6.Signal=USART1_TX
PB7.Signal=USART1_RX
PB8.Signal=I2C1_SCL
PB9.Signal=I2C1_SDA
PC13-ANTI_TAMP.GPIO_Label=B1 [Blue PushButton]
PC13-ANTI_TAMP.Signal=GPXTI13
PC14-OSC32_IN.Signal=RCC_OSC32_IN
PC15-OSC32_OUT.Signal=RCC_OSC32_OUT
PC6.Signal=USART6_TX
PC7.Signal=USART6_RX
