far-mat42/mte-481-g29/(commit log)

2024-10-05 initialized project for load cell ADC
2024-10-07 added nucleo schematics for reference
    [Connectors.SchDoc, MB1136.PcbDoc, MB1136.PrjPCB, MB1136.SCHLIB, MB1136.SchDoc, MCU_64.SchDoc, ST_LINK_V2-1.SCHDOC]
2024-10-20 implemented configuration and continuous conversion reading from load cell ADC
2024-10-20 quick change to ADC FSR and gain
2024-11-13 small edits to adc code while testing load cells
2024-11-17 designed ADC module PCB for ADS
    [ADC Module.SchDoc, Filter.SchDoc, Load Cell ADC Module.PcbDoc, Load Cell ADC Module.PrjPcb]
2024-11-18 started design for I2C UART buffer module
    [Buffer Module.SchDoc, I2C UART Buffer Module.PrjPcb]
2024-11-18 finished design for I2C UART buffer module
    [Buffer Module.SchDoc, I2C UART Buffer Module.PcbDoc, I2C UART Buffer Module.PrjPcb, Load Cell ADC Module.PcbDoc]
2024-11-18 small touch-ups to silkscreen
    [I2C UART Buffer Module.PcbDoc]
2024-11-18 generated gerbers
    [I2C UART Buffer Module.GBL, I2C UART Buffer Module.GBO, I2C UART Buffer Module.GBP, I2C UART Buffer Module.GBS, I2C UART Buffer Module.GM1, I2C UART Buffer Module.GTL, I2C UART Buffer Module.GTO, I2C UART Buffer Module.GTP]
2024-11-18 Update Load Cell ADC Module.PrjPcb
    [Load Cell ADC Module.PrjPcb]
2024-12-08 added PCB BOMs
    [PCB BOM.xlsx]
2025-01-09 started on I2C driver for UART buffer
2025-01-11 finished code for UART buffer I2C driver
    - Implements an interrupt to determine when to read buffer data
    - Buffer data is read until buffer no longer contains any more barcodes
    - Barcodes are printed to console, indicating which scanner they're from
    [Barcode Scanner.ioc, main.c]
2025-01-12 models and parts for barcode scanner gimbal
    [Barcode Scanner Gimbal.SLDASM, Barcode Scanner Mount.SLDPRT, Barcode Scanner Mount.STL, GM67 Barcode Scanner.SLDPRT, Gimbal-Intermediate.SLDPRT, Gimbal-Intermediate.stl, Motor Slot Intermediate.SLDPRT, Motor Slot Intermediate.STL]
2025-01-16 updated load cell code to use ADS1219 ADC
2025-01-18 started timers & adjusted min/max angle
2025-01-18 completed servo test code
    gimbal sweeps both axes, with the pitch oscillating with a quadratic speed while the yaw moves at a slow, linear speed
    [Two-Axis Gimbal Test.ioc, main.c]
2025-01-24 quick fix to start ADC conversion, calculated offset
    [main.c]
2025-02-02 designed new 2 axis gimbal, mounts for barcode scanner & camera on shopping cart
    [Alt Gimbal Intermediate.SLDPRT, Alt Gimbal Pitch Arm.SLDPRT, Alt Gimbal Pitch Arm.STL, Alt Gimbal Yaw Arm.SLDPRT, Alt Gimbal Yaw Arm.STL, Alt Gimbal Yaw Servo Mount.SLDPRT, Alt Gimbal Yaw Servo Mount.STL, Alternate Barcode Scanner Gimbal.SLDASM]
2025-02-04 stm32esp32comm initial commit
2025-02-04 esp32wifi
    initial commit
2025-02-10 redesigned camera screw mounts
    [Camera Screw Mount Inside Alt.SLDPRT, Camera Screw Mount Inside Alt.STL, Camera Screw Mount Inside.SLDPRT, Camera Screw Mount Inside.STL, Camera Screw Mount Outside Alt.SLDPRT, Camera Screw Mount Outside Alt.STL, Camera Screw Mount Outside.SLDPRT, Camera Screw Mount Outside.STL]
2025-02-21 tested code for receiving from different UART channels & then printing them out at fixed intervals
    [Two-Axis Gimbal Test.ioc, main.c]
2025-02-23 designed case & mounting for ESP32
    [ESP32 Case Bottom.SLDPRT, ESP32 Case Bottom.STL, ESP32 Case Mount Clamp.SLDPRT, ESP32 Case Mount Clamp.STL, ESP32 Case Top.SLDPRT, ESP32 Case Top.STL, ESP32 Case.SLDASM]
2025-02-23 added case and mounting for load cell ADC
    [Load Cell ADC Case Bottom.SLDPRT, Load Cell ADC Case Bottom.STL, Load Cell ADC Case Mount Clamp.SLDPRT, Load Cell ADC Case Mount Clamp.STL, Load Cell ADC Case Top.SLDPRT, Load Cell ADC Case Top.STL, Load Cell ADC Case.SLDASM]
2025-02-24 added case & mounting for nucleo shield
    [Nucleo Case Bottom.SLDPRT, Nucleo Case Inner Clamp.SLDPRT, Nucleo Case Outer Clamp.SLDPRT, Nucleo Case Top.SLDPRT]
2025-02-24 added case and mounting for 3V3 LDO
    [LDO Case Bottom.SLDPRT, LDO Case Bottom.STL, LDO Case Mount Clamp.SLDPRT, LDO Case Mount Clamp.STL, LDO Case Top.SLDPRT, LDO Case Top.STL, Nucleo Case Bottom.STL, Nucleo Case Inner Clamp.STL]
2025-02-24 updated gimbal to better mount to basket
    [Alt Gimbal Yaw Servo Mount.SLDPRT, Alt Gimbal Yaw Servo Mount.STL, Alternate Barcode Scanner Gimbal.SLDASM, Yaw Servo Mount Clamp.SLDPRT, Yaw Servo Mount Clamp.STL]
2025-02-25 started on case for jetson nano
    [Jetson Nano Case Bottom.SLDPRT, Jetson Nano Case Top.SLDPRT]
2025-02-27 finished case for jetson nano
    [Jetson Case Inner Clamp.SLDPRT, Jetson Case Inner Clamp.STL, Jetson Case Outer Clamp.SLDPRT, Jetson Case Outer Clamp.STL, Jetson Nano Case Bottom.SLDPRT, Jetson Nano Case Bottom.STL, Jetson Nano Case Top.SLDPRT, Jetson Nano Case Top.STL]
2025-02-27 added case and mount for buck converter
    [Buck Converter Case Bottom.SLDPRT, Buck Converter Case Bottom.STL, Buck Converter Case Mount Clamp.SLDPRT, Buck Converter Case Mount Clamp.STL, Buck Converter Case Top.SLDPRT, Buck Converter Case Top.STL, Buck Converter Case.SLDASM, Buck Converter Model.SLDPRT]
2025-02-27 added case and mounting for battery
    [Battery Case Mount.SLDPRT, Battery Case Mount.STL, Battery Case.SLDASM, Battery Case.SLDPRT, Battery Case.STL, Battery Front Cover.SLDPRT, Battery Front Cover.STL, Battery Model.SLDPRT]
2025-03-02 quick fixes to jetson case and mounting
    [Battery Case.SLDASM, Jetson Case Inner Clamp.SLDPRT, Jetson Case Inner Clamp.STL, Jetson Case Outer Clamp.SLDPRT, Jetson Case Outer Clamp.STL, Jetson Nano Case Bottom.SLDPRT, Jetson Nano Case Bottom.STL, Jetson Nano Case Top.SLDPRT]
2025-03-03 redesigned parts for esp32 and nucleo cases
    [ESP32 Case Bottom.SLDPRT, ESP32 Case Bottom.STL, ESP32 Case Mount Clamp.SLDPRT, ESP32 Case Mount Clamp.STL, ESP32 Case Top.SLDPRT, ESP32 Case Top.STL, ESP32 Case.SLDASM, ESP32-WROOM-32.SLDPRT]
2025-03-03 minor modifications to camera case
    [Camera Screw Mount Inside Alt.SLDPRT, Camera Screw Mount Inside Alt.STL, Camera Screw Mount Inside.SLDPRT, Camera Screw Mount Inside.STL, Camera Screw Mount Outside Alt.SLDPRT, Camera Screw Mount Outside Alt.STL, Camera Screw Mount Outside.SLDPRT, Camera Screw Mount Outside.STL]
2025-03-06 quick fix to jetson nano case
    [Jetson Nano Case Bottom.SLDPRT, Jetson Nano Case Bottom.STL]
2025-03-08 implemented logic for avoiding duplicate scans/handling multiple scanned items
    [main.c]
2025-03-09 added dummy barcode tx, fixed yaw servo limits
    [main.c]
2025-03-10 added USB slot to ESP32 case
    [ESP32 Case Bottom.SLDPRT, ESP32 Case Bottom.STL, ESP32 Case Top.SLDPRT, ESP32 Case Top.STL, ESP32 Case.SLDASM]
2025-03-10 minor bug fix to avoid always sending dummy code
    [main.c]
2025-03-14 update functionality of esp32
    add timestamp of when data is sent to the server
    combine the weight and the barcode data to send together
    covert received data to JSON format
2025-03-16 few changes to models for symposium poster
    [Alternate Barcode Scanner Gimbal.SLDASM, Camera Screw Mount Outside Alt.SLDPRT, Camera Screw Mount Outside.SLDPRT, Gimbal Cart Mockup.SLDPRT, M3 Screw.SLDPRT]
2025-03-26 added drawings for custom parts
    [3V3 LDO Case.SLDDRW, Battery Mount.SLDDRW, ESP32 Case.SLDDRW, Gimbal Arms.SLDDRW, Gimbal Mount.SLDDRW, Jetson Case.SLDDRW, Load Cell ADC Case.SLDDRW, Nucleo Case.SLDDRW]
