far-mat42/mte-481-g29/(notices)

Notices in the files:
STM32 Nucleo/Auto Shopping Cart/Core/Src/main.c:
Copyright (c) 2025 STMicroelectronics.
All rights reserved.
This software is licensed under terms that can be found in the LICENSE file
